Makara97/Bluetooth_Speaker_Setup/Bluetooth_Speaker_Driver/Project Outputs for Bluetooth_Speaker_Driver/BOM/Bill of Materials-Bluetooth_Speaker_Driver(Fabrication Variant).xlsx

Comment | Description | Designator | Footprint | LibRef | Quantity
ANT3216_2.45GHz | C293767, ANT3216LL00R2400A, -40℃~+105℃ 1.2mm 1.6mm 160MHz 1W 2.45GHz 3.2mm 5.05dBi 50Ω 1206 Antennas ROHS | ANT1 | ANT3216_2.4GHz | ANT3216_2.45GHz | 1
1uF | C307427, CL05B105KQ5NQNC, 1uF 6.3V X7R ±10% 0402 Multilayer Ceramic Capacitors MLCC - SMD/SMT ROHS | C1, C7, C12, C13, C19 | CAPC0402X06N | CC0402_1uF_X7R | 5
100nF | C1882920, CC0201KRX7R5BB104, 100nF 6.3V X7R ±10% 0201 Multilayer Ceramic Capacitors MLCC - SMD/SMT ROHS | C2, C3, C4, C5, C8, C9, C10, C11, C18 | CAPC0201X03N | CC0201_100nF_X7R | 9
2.2nF | C161488. GRM033R71E222KA12D, 2.2nF 25V X7R ±10% 0201 Multilayer Ceramic Capacitors MLCC - SMD/SMT ROHS | C6 | CAPC0201X03N | CC0201_2.2nF_X7R | 1
0.7pF | C907945, GJM0335C1ER70WB01D, 0.7pF 25V C0G 0201 Multilayer Ceramic Capacitors MLCC - SMD/SMT ROHS | C14 | CAPC0201X03N | CC0201_0.7pF_COG | 1
4.7uF | C354262, CC0805KKX7R8BB475, 25V 4.7uF X7R ±10% 0805 Multilayer Ceramic Capacitors MLCC - SMD/SMT ROHS | C16, C17, C34, C38 | CAP0805X13N | CC0805_4.7uF_X7R | 4
100pF | C14663 ,CC0603KRX7R9BB104, 100nF 50V X7R ±10% 0603 Multilayer Ceramic Capacitors MLCC - SMD/SMT ROHS | C20, C26, C27, C31 | CAPC0603X8N | CC0603_100pF_X7R | 4
10uF | C95841, CL21B106KOQNNNE, 10uF 16V X7R ±10% 0805 Multilayer Ceramic Capacitors MLCC - SMD/SMT ROHS | C21, C25, C28, C30, C45, C47, C48, C49, C53, C56, C62 | CAPC0805X14N | CC0805_10uF_X7R | 11
2.2nF | C107043, CC0603JRNPO9BN222, 2.2nF 50V NP0 ±5% 0603 Multilayer Ceramic Capacitors MLCC - SMD/SMT ROHS | C22, C29 | CAPC0603X8N | CC0603_2.2nF_NPO | 2
2.2uF | C19110 ,CL21B225KAFNNNE, 2.2uF 25V X7R ±10% 0805 Multilayer Ceramic Capacitors MLCC - SMD/SMT ROHS | C23, C24 | CAP0805X13N | CC0805_2.2uF_X7R | 2
22pF | C105620, CC0603JRNPO9BN220, 22pF 50V NP0 ±5% 0603 Multilayer Ceramic Capacitors MLCC - SMD/SMT ROHS | C32, C40 | CAPC0603X8N | CC0603_22pF_NPO | 2
22uF | C309062, CL32B226KAJNNNE, 22uF 25V X7R ±10% 1210 Multilayer Ceramic Capacitors MLCC - SMD/SMT ROHS | C33, C41, C51, C52 | CAPC1210X25N | CC1210_22uF_X7R | 4
4.7nF | C106218, CC0603KRX7R9BB472, 4.7nF 50V X7R ±10% 0603 Multilayer Ceramic Capacitors MLCC - SMD/SMT ROHS | C35 | CAPC0603X8N | CC0603_4.7nF_X7R | 1
10nF | C100042, CC0603KRX7R9BB103, 10nF 50V X7R ±10% 0603 Multilayer Ceramic Capacitors MLCC - SMD/SMT ROHS | C36, C42, C43, C44, C46 | CAPC0603X8N | CC0603_10nF_X7R | 5
220nF | C464977, GRM31C5C1H224JE02L, 220nF 50V C0G ±5% 1206 Multilayer Ceramic Capacitors MLCC - SMD/SMT ROHS | C37, C83, C84, C88, C90 | CAPC1206X18N | CC0603_220nF_NPO, CC1206_220nF_NPO | 5
100nF | C14663, CC0603KRX7R9BB104, 100nF 50V X7R ±10% 0603 Multilayer Ceramic Capacitors MLCC - SMD/SMT ROHS | C39, C50, C54, C57, C61, C63, C75, C81, C100, C105 | CAPC0603X8N | CC0603_100nF_X7R | 10
75pF | C282074, CC0603JRNPO9BN750, 50V 75pF NP0 ±5% 0603 Multilayer Ceramic Capacitors MLCC - SMD/SMT ROHS | C55 | CAPC0603X8N | CC0603_75pF_NPO | 1
1uF | C28323, CL21B105KBFNNNE, 1uF 50V X7R ±10% 0805 Multilayer Ceramic Capacitors MLCC - SMD/SMT ROHS | C58, C60, C64, C87, C89, C91, C94, C95, C98, C108, C111, C112, C113 | CAP0805X13N | CC0805_1uF_X7R | 13
470uF | C3350, RVT1V471M1010, -55℃~+105℃ 10.2mm 10mm 2000hrs@105℃ 35V 470uF ±20% SMD,D10xL10.2mm Aluminum Electrolytic Capacitors - SMD ROHS | C59 | CAPD10XL11.1X10.2M | CPD10XL10.2_470uF_ALUM | 1
100nF | C97946, GRM31C5C1H104JA01L, 100nF 50V C0G ±5% 1206 Multilayer Ceramic Capacitors MLCC - SMD/SMT ROHS | C65, C66 | CAPC1206X18N | CC1206_100nF_C0G | 2
10uF | C5246550, HV1V106M0605PZ, -55℃~+105℃ 10uF 2.2mm 2000hrs 35V 5.8mm 6.3mm ±20% SMD,D6.3xL5.8mm Polymer Aluminum Capacitors ROHS | C67, C70, C71, C72, C73 | CAPD6.3XL5.8X61M | CPD6.3XL5.8_10uF_POLYMER | 5
390nF | C1854267, CC0805KKX7R9BB394, 390nF 50V X7R ±10% 0805 Multilayer Ceramic Capacitors MLCC - SMD/SMT ROHS | C68, C69 | CAPC0805X14N | CC0805_390nF_X7R | 2
100uF | C5246554, HV1V107M0607PZ, -55℃~+105℃ 100uF 2.2mm 2000hrs 35V 6.3mm 7.7mm ±20% SMD,D6.3xL7.7mm Polymer Aluminum Capacitors ROHS | C74, C80, C99, C104 | CAPD6.3XL6.3X77M | CPD6.3XL7.7_100uF_POLY | 4
1nF | C100040, CC0603KRX7R9BB102, 1nF 50V X7R ±10% 0603 Multilayer Ceramic Capacitors MLCC - SMD/SMT ROHS, C106246, CC0603JRNPO9BN102, 1nF 50V NP0 ±5% 0603 Multilayer Ceramic Capacitors MLCC - SMD/SMT ROHS | C76, C77, C78, C82, C85, C86, C92, C93, C96, C97, C101, C106 | CAPC0603X8N | CC0603_1nF_X7R, CC0603_1nF_NPO | 12
220uF | C5246541, HV1E227M0607PZ, -55℃~+105℃ 2.2mm 2000hrs 220uF 25V 6.3mm 7.7mm ±20% SMD,D6.3xL7.7mm Polymer Aluminum Capacitors ROHS | C79, C102 | CAPD6.3XL6.3X77M | CPD6.3XL7.7_220uF_POLY | 2
680nF | C145012, CC1206KKX7R9BB684, 50V 680nF X7R ±10% 1206 Multilayer Ceramic Capacitors MLCC - SMD/SMT ROHS | C103, C110 | CAPC1206X18N | CC1206_680nF_X7R | 2
470nF | C277483, CC1206KKX7R9BB474, 470nF 50V X7R ±10% 1206 Multilayer Ceramic Capacitors MLCC - SMD/SMT ROHS | C107, C109 | CAPC1206X18N | CC1206_470nF_X7R | 2
FB_3A | C107332, MPZ1608S101ATAH0, -55℃~+125℃ 1 100Ω@100MHz 30mΩ 3A ±25% 0603 Ferrite Beads ROHS | FB1, FB2, FB4, FB5, FB6 | FB0603X08N | FB0603_3A | 5
FB_6A | C136227, MPZ2012S300AT000, -55℃~+125℃ 1 10mΩ 30Ω@100MHz 6A ±25% 0805 Ferrite Beads ROHS | FB3, FB7 | FB0805X12N | FB0805_6A | 2
4.7uH | C91237, MLP2520S4R7MT0S1, 130mΩ 1A 4.7uH Multilayer inductor ±20% 1008 Inductors (SMD) ROHS | IN1, IN2 | INDC2520X10N | IN2520_4.7uH_1A | 2
15uH | C5189959, CYA0630-15UH, 15uH 3.8A 3A 98mΩ ±20% SMD,7.2x6.6mm Inductors (SMD) ROHS | IN3 | INDM7266X30N | IN7266_15uH_3A | 1
SWD_CONN_2X5P_1.27MM | C42372547, HX JN1.27-2x5P ZZ H4.9, -40℃~+105℃ 1.27mm 1.27mm 1A 2 2x5P 5 500V Black Copper Gold IDC Header Through Hole Plugin,P=1.27mm IDC Connectors ROHS | J1 | CONN_2X5P_1.27MM - duplicate | SWD_CONN_2X5P_1.27MM | 1
JST_GH_4_PIN | C161692, BM04B-GHS-TBT(LF)(SN), -25℃~+85℃ 1 1.25mm 1A 1x4P 4 4.05mm 4.32mm 4P 50V 8.25mm Auxiliary Solder Pin GH PA9T Phosphor bronze Surface Mount,Vertical Tin UL94V-0 White SMD,P=1.25mm Wire To Board Connector ROHS | J2 | JST_GH_4_PIN | JST_GH_4_PIN | 1
JST_GH_8_PIN | C133062, BM08B-GHS-TBT(LF)(SN), -25℃~+85℃ 1 1.25mm 13.25mm 1A 1x8P 4.05mm 4.32mm 50V 8 8P Auxiliary Solder Pin GH PA9T Phosphor bronze Surface Mount,Vertical Tin UL94V-0 White SMD,P=1.25mm Wire To Board Connector ROHS | J3 | JST_GH_8_PIN | JST_GH_8_PIN | 1
USB_TYPE_A_FE | C456018, AF 90 WJDG, -25℃~+85℃ 1 1.5A 14mm 30V 4P 5,000 times Female Right Angle Type-A USB 2.0 White 弯插 USB Connectors ROHS | J4 | USB_TYPE_A_FE | USB_TYPE_A_FE | 1
JST_S2P_VH | C160355, S2P-VH(LF)(SN), -25℃~+85℃ 1 10A 13.9mm 1x2P 2 250V 2P 3.96mm 7.86mm Brass PA66 Right Angle Tin UL94V-0 VH White 弯插,P=3.96mm Wire To Board Connector ROHS | J5 | JST_S2P_VH | JST_S2P_VH | 1
JST_B2B-XH-A-GU | C265283, B2B-XH-A-GU, -25℃~+85℃ 1 1x2P 2 2.5mm 250V 2P 3A 5.75mm 7.4mm 7mm Brass Gold K Pin PA66 Through Hole UL94V-0 White XH 插件,P=2.5mm Wire To Board Connector ROHS | J6, J7, J8 | JST_B2B_XH_A_GU | JST_B2B-XH-A-GU | 3
10uH | C76798, MLZ1608M100WT000, 1.05Ω 10uH 250mA 2MHz 90mA Multilayer inductor ±20% 0603 Inductors (SMD) ROHS | L1, L2 | INDC0603X08N | IN0603_10uH | 2
2.2nH | C98041, LQP03TN2N2B02D, 11GHz 14@500MHz 150mΩ 2.2nH 600mA Thick Film Inductor 0201 Inductors (SMD) ROHS | L3, L4 | INDC0201 | IN0201_2.2nH | 2
1.5nH | C77114, LQP03TN1N5B02D, 1.5nH 14@500MHz 150mΩ 15GHz 600mA Thick Film Inductor 0201 Inductors (SMD) ROHS | L5 | INDC0201 | IN0201_1.5nH | 1
1.8nH | C98040, LQP03TN1N8B02D, 1.8nH 14@500MHz 150mΩ 15GHz 600mA Thick Film Inductor 0201 Inductors (SMD) ROHS | L7 | INDC0201 | IN0201_1.8nH | 1
10uH | C168076, FNR6045S100MT, 10uH 2.7A 3.5A 62mΩ Magnetic Shielded Inductor ±20% SMD,6x6mm Power Inductors ROHS | L8, L9 | INDC6060X45N | IN0606_10uH_2.7A | 2
LED_YELLOW | C965814, XL-2012UYC, 120° 2.3V 20mA 50mW 585nm~595nm 590nm Discrete Diode Top-mount Water Clear Yellow 0805 LED Indication - Discrete ROHS | LED1A, LED1B, LED1C, LED1D | LED_0805_127P120X200-2N | LED0805_YELLOW | 4
AO3400A | C347475, AO3400A, -55℃~+150℃ 1 N-channel 1.1V 1.4W 17mΩ@10V 30V 5.8A 77pF 823pF 9.7nC@4.5V 99pF SOT-23 MOSFETs ROHS | Q1A, Q1B, Q1C, Q1D | SOT23_P240X110-3N | SOT_23_AO3400A | 4
2.2 ohm | C474415, RC0201JR-072R2L, -100ppm/℃~+350ppm/℃ -55℃~+125℃ 2.2Ω 25V 50mW Thick Film Resistor ±5% 0201 Chip Resistor - Surface Mount ROHS | R1 | CAPC0201X03N | REC0201_2.2_THICK | 1
50 ohm | C849792, RT0603BRE0750RL, -55℃~+155℃ 100mW 50Ω 75V Thin Film Resistor ±0.1% ±50ppm/℃ 0603 Chip Resistor - Surface Mount ROHS | R2A, R2B, R2C, R2D | RECS0603X45N | RESC0603_50_THIN | 4
100 ohm | C122970, RT0603BRD07100RL, -55℃~+155℃ 100mW 100Ω 75V Thin Film Resistor ±0.1% ±25ppm/℃ 0603 Chip Resistor - Surface Mount ROHS | R3A, R3B, R3C, R3D, R10 | RECS0603X45N | RESC0603_100_THIN | 5
100k | C116674, AC0603FR-07100KL, -55℃~+155℃ 100kΩ 100mW 75V Thick Film Resistor ±1% ±100ppm/℃ 0603 Chip Resistor - Surface Mount ROHS | R4A, R4B, R4C, R4D, R9, R12, R13, R17, R25, R28, R29, R30, R31, R39, R41, R44, R46, R48 | RECS0603X45N | RESC0603_100K_THIN | 18
470 ohm | C705857,RT0603BRE07470RL, -55℃~+155℃ 100mW 470Ω 75V Thin Film Resistor ±0.1% ±50ppm/℃ 0603 Chip Resistor - Surface Mount ROHS | R5, R6 | RECS0603X45N | RESC0603_470_THIN | 2
510K | C114066, RC0603FR-07510KL, -55℃~+155℃ 100mW 510kΩ 75V Thick Film Resistor ±1% ±100ppm/℃ 0603 Chip Resistor - Surface Mount ROHS | R7, R11 | RECS0603X45N | RESC0603_510K_THICK | 2
130K | C163432, RC0603FR-07130KL, -55℃~+155℃ 100mW 130kΩ 75V Thick Film Resistor ±1% ±100ppm/℃ 0603 Chip Resistor - Surface Mount ROHS | R8 | RECS0603X45N | RESC0603_130K_THICK | 1
320k | C20165692, RT0603BRD07320KL, -55℃~+155℃ 100mW 320kΩ 75V Thin Film Resistor ±0.1% ±25ppm/℃ 0603 Chip Resistor - Surface Mount ROHS | R14 | RECS0603X45N | RESC0603_320K_THIN | 1
324k | C861321, RT0603BRD07324KL, -55℃~+155℃ 100mW 324kΩ 75V Thin Film Resistor ±0.1% ±25ppm/℃ 0603 Chip Resistor - Surface Mount ROHS | R15 | RECS0603X45N | RESC0603_324K_THIN | 1
49.9 ohm | C23185, 0603WAF499JT5E, -55℃~+155℃ 100mW 49.9Ω 75V Thick Film Resistor ±1% ±100ppm/℃ 0603 Chip Resistor - Surface Mount ROHS | R16 | RECS0603X45N | RESC0603_49.9_THIN | 1
13.3k | C185373, RC0603FR-0713K3L, -55℃~+155℃ 100mW 13.3kΩ 75V Thick Film Resistor ±1% ±100ppm/℃ 0603 Chip Resistor - Surface Mount ROHS | R18 | RECS0603X45N | REC0603_13.3K_THICK | 1
11k | C728581, RT0603BRD0711KL, -55℃~+155℃ 100mW 11kΩ 75V Thin Film Resistor ±0.1% ±25ppm/℃ 0603 Chip Resistor - Surface Mount ROHS | R19, R20, R21, R24, R26, R27 | RECS0603X45N | RESC0603_11K_THIN | 6
5.6k | C179095, RT0603BRD075K6L, -55℃~+155℃ 100mW 5.6kΩ 75V Thin Film Resistor ±0.1% ±25ppm/℃ 0603 Chip Resistor - Surface Mount ROHS | R22, R23 | RECS0603X45N | RESC0603_5.6K_THIN | 2
4.7k | C513565, RT0603BRD074K7L, -55℃~+155℃ 100mW 4.7kΩ 75V Thin Film Resistor ±0.1% ±25ppm/℃ 0603 Chip Resistor - Surface Mount ROHS | R32, R35 | RECS0603X45N | RESC0603_4.7K_THIN | 2
10k | C95204, RT0603BRD0710KL, -55℃~+155℃ 100mW 10kΩ 75V Thin Film Resistor ±0.1% ±25ppm/℃ 0603 Chip Resistor - Surface Mount ROHS | R33, R34 | RECS0603X45N | RESC0603_10K_THIN | 2
68 ohm | C861523, RT0603BRD0768RL, -55℃~+155℃ 100mW 68Ω 75V Thin Film Resistor ±0.1% ±25ppm/℃ 0603 Chip Resistor - Surface Mount ROHS | R36, R37, R38, R43 | RECS0603X45N | RESC0603_68_THIN | 4
51K | C107231, RC0603FR-0751KL, -55℃~+155℃ 100mW 51kΩ 75V Thick Film Resistor ±1% ±100ppm/℃ 0603 Chip Resistor - Surface Mount ROHS | R40, R45 | RECS0603X45N | RESC0603_51K_THICK | 2
39K | C163424, RC0603FR-0739KL, -55℃~+155℃ 100mW 39kΩ 75V Thick Film Resistor ±1% ±100ppm/℃ 0603 Chip Resistor - Surface Mount ROHS | R42, R47 | RECS0603X45N | RESC0603_39K_THICK | 2
SCHDIOSMB_1A | C86598, STPS160U, 1 Independent 1A 4uA@60V 60V 670mV@1A 75A SMB Schottky Diodes ROHS | SD1, SD2 | SD_SMB_1A | SCHDIOSMB_1A | 2
PB_SW | C49393629, R4A25211L, 1.8N 12V 50mA Gull Wing Rectangular Button SPST-NO Surface Mount,Vertical White SMD Pushbutton Switches ROHS | SW1, SW2, SW3, SW4, SW5, SW6, SW7, SW8 | SW_PB_2 | SW_SMD_PUSH | 8
nRF5340-QKAA | Multi-protocol Bluetooth Low Energy, IEEE 802.15.4, ANT and 2.4GHz proprietary system-on-chip | U1 | AQFN40P700X700X85_HS-99N | nRF5340-QKAA | 1
PCM5102APWR | C107671, PCM5102APWR, -25℃~+85℃ 1.8V~3.3V 2 32 384kHz 500uA 50MHz Audio Decoder I2S TSSOP-20 ADCs/DACs - Special Purpose ROHS | U2 | SOP65P640X120-20N | PCM5102APWR | 1
TPS65131RGER | C87663, TPS65131RGER, -15V~-2V、500mV~15V -40℃~+85℃@(TA)、-40℃~+125℃@(TJ) 1.25MHz~1.5MHz 1.95A 2 2.7V~5.5V 500uA Adjustable Boost、Inverting Buck-Boost Built-in No QFN-24-EP(4x4) DC-DC Converters ROHS | U3 | QFN50P400X400X100-25N-D | TPS65131RGER | 1
TPS7A4901DGNR | C16430, TPS7A4901DGNR, -40℃~+125℃@(Tj) 1 1.194V~33V 15.4uVrms 150mA 260mV@(100mA) 35V 49uA 72dB@(120Hz) Adjustable Positive Under Voltage Lockout、Over Current Protection、Over Temperature Protection、Enable HVSSOP-8 Voltage Regulators - Linear, Low Drop Out (LDO) Regulators ROHS | U4 | SOP65P490X110-9N | TPS7A4901DGNR | 1
TPS7A3001DGNR | C33835, TPS7A3001DGNR, -40℃~+125℃@(Tj) 1 1.18V~33V 15.1uVrms 200mA 216mV@(100mA) 36V 55uA 72dB@(120Hz) Adjustable Negative Over Current Protection、Enable、Thermal Shutdown HVSSOP-8 Voltage Regulators - Linear, Low Drop Out (LDO) Regulators ROHS | U5 | SOP65P490X110-9N | TPS7A3001DGNR | 1
TPS54202DDCR | C191884, TPS54202DDCR, -40℃~+125℃@(TJ) 1 2A 4.5V~28V 45uA 500kHz Adjustable Buck Buck Built-in Yes SOT-23-6 DC-DC Converters ROHS | U6 | TPS54202DDCR | TPS54202DDCR | 1
TLV75533PDBVR | C404027, TLV75533PDBVR, -40℃~+125℃@(Tj) 1 238mV@(500mA) 25uA 3.3V 46dB@(100kHz) 5.5V 500mA 71.5uVrms Fixed Over Current Protection、Thermal Shutdown、Input undervoltage protection Positive SOT-23-5 Voltage Regulators - Linear, Low Drop Out (LDO) Regulators ROHS | U7 | SOT95P280X145-5N | TLV75533PDBVR | 1
TPS7A2033PDBVR | C2862740, TPS7A2033PDBVR, -40℃~+125℃@(Tj) 1 10uVrms 140mV@(300mA) 3.3V 300mA 65dB@(100kHz) 6V 8.5uA Fixed Over Current Protection、Enable Positive SOT-23-5 Voltage Regulators - Linear, Low Drop Out (LDO) Regulators ROHS | U8 | SOT95P280X145-5N | TPS7A2033PDBVR | 1
RC4580IDR | C80100, RC4580IDR, -16V~-2V、2V~16V -40℃~+85℃ 0.0005% 110dB 2-Channel 9mA SOIC-8 Audio Amplifiers ROHS | U9, U10 | SOIC127P600X175-8N | RC4580IDR | 2
TPA3138D2PWPR | C475506, TPA3138D2PWPR, -10℃~+85℃ -70dB 0.04% 102dB 10W×2@6Ω、18.5W×1@4Ω 2-Channel 20mA 3.5V~14.4V Automatic mute/no-noise switch、Overvoltage protection、Digital programmable gain Class D TSSOP-28-EP Audio Amplifiers ROHS | U11, U12 | SOP65P640X120-29N | TPA3138D2PWPR | 2
32MHz | C20617581, XL2MI-111-32M, -40℃~+85℃ 10pF 32MHz 40Ω Crystal Oscillator ±10ppm ±20ppm SMD3225-4P Crystals ROHS | X1 | CRYOSC_3.2X2.5M | SMD3225_4P_32MHz_OSC | 1
Total components |  |  |  |  | 227
