Makara97/Bluetooth_Speaker_Setup/Bluetooth_Speaker_Driver/Project Outputs for Bluetooth_Speaker_Driver/ExportSTEP/PCB(Fabrication Variant).step

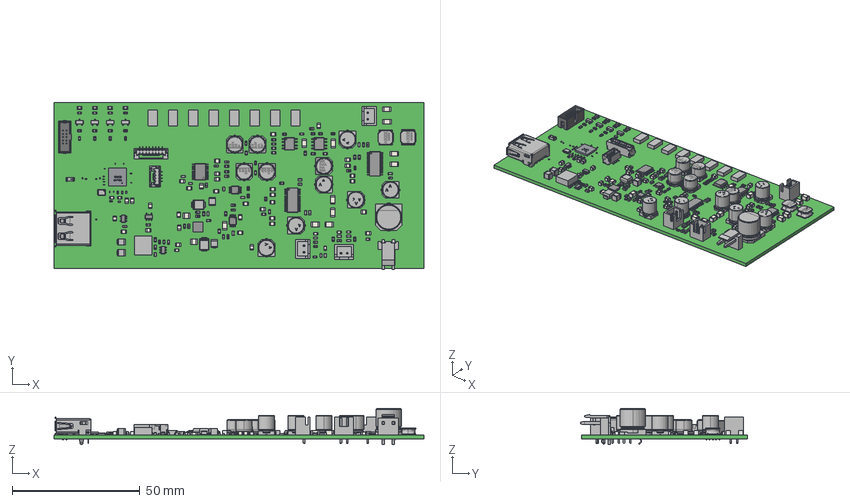
[picture p1: CAD file, 2026-09-16]
Bluetooth_Speaker_Driver/Project Outputs for Bluetooth_Speaker_Driver/ExportSTEP/PCB(Fabrication Variant).step
145.0 x 65.3 x 14.1 mm
Imported x 2
Inlay
MetalFrame
Pin1Marker
Pin3
Pin1
Lid
Pin4
Pin2
Ceramic
PinsArrayLR x 5
ThermalPad x 2
BODY-SOT x 2
LEAD-SOT x 10
LEAD-DUMMY x 2
BODY-HVSSOP x 2
LEAD-HVSSOP x 16
PIN1_HVSSOP x 2
DAP_HVSSOP x 2
BODY-QFN
PIN1-ID
BODY-TSSOP
LEAD-TSSOP x 20
PIN1
aQFN-94 x 9
Extruded x 234
STPS160U_RGB8421504 x 2
RT0603BRD074K7L 4.7k_RGB8421504 x 56
SOT-23_RGB8421504 x 4
LED-0805-1_RGB8421504 x 4
10uH, 6x6 mm_RGB8421504 x 2
JST-B2B-XH-A_RGB8421504 x 3
VH-2AW-Body.STEP
VH-2AW-Pin.STEP x 2
USB-A1HSW6 shell
test
BMxxB-GHS-TBT_08
JST-GH-4PIN-BM04B-GHS-TBT(LF)(SN)(N)_RGB8421504
Linear Pattern 01
Pins:1
CC0603JRNPO9BN222 - 2.2nF, C0G,_RGB8421504 x 37
C5246554 - 100uF, D6.3x7.7mm_RGB8421504 x 6
C5246550 - 10uF,D6.3xL5.8mm_RGB8421504 x 5
C3350 - 470uF, D10xL10.2mm_RGB8421504
CC1210 - 22uF, X7R_RGB8421504 x 4
