Makara97/Bluetooth_Speaker_Setup/Bluetooth_Speaker_Driver/Project Outputs for Bluetooth_Speaker_Driver/Schematic.PDF

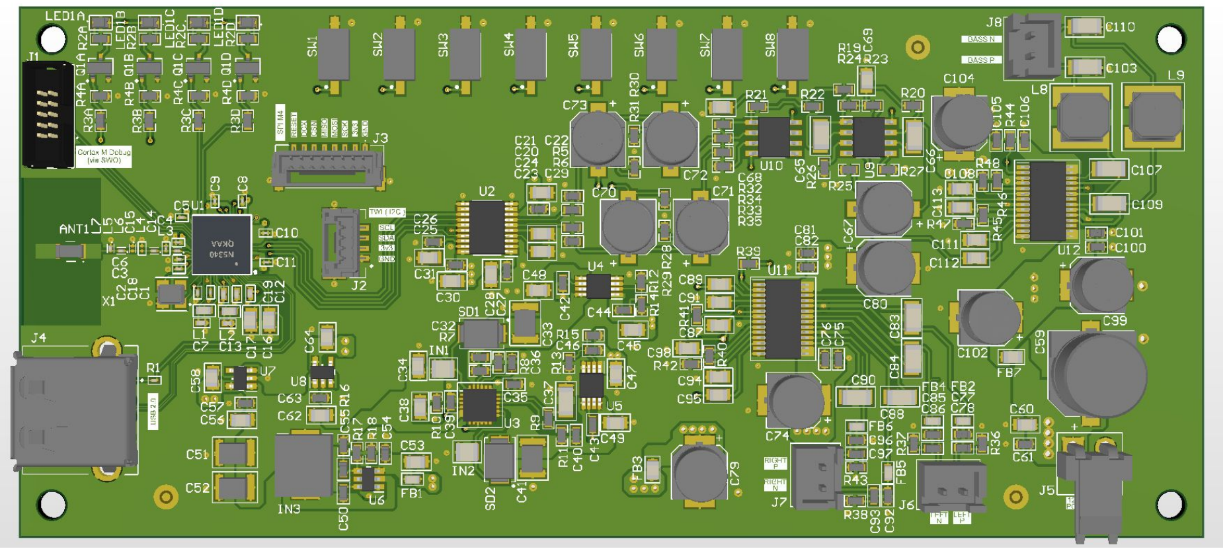
[picture p2: page 1]

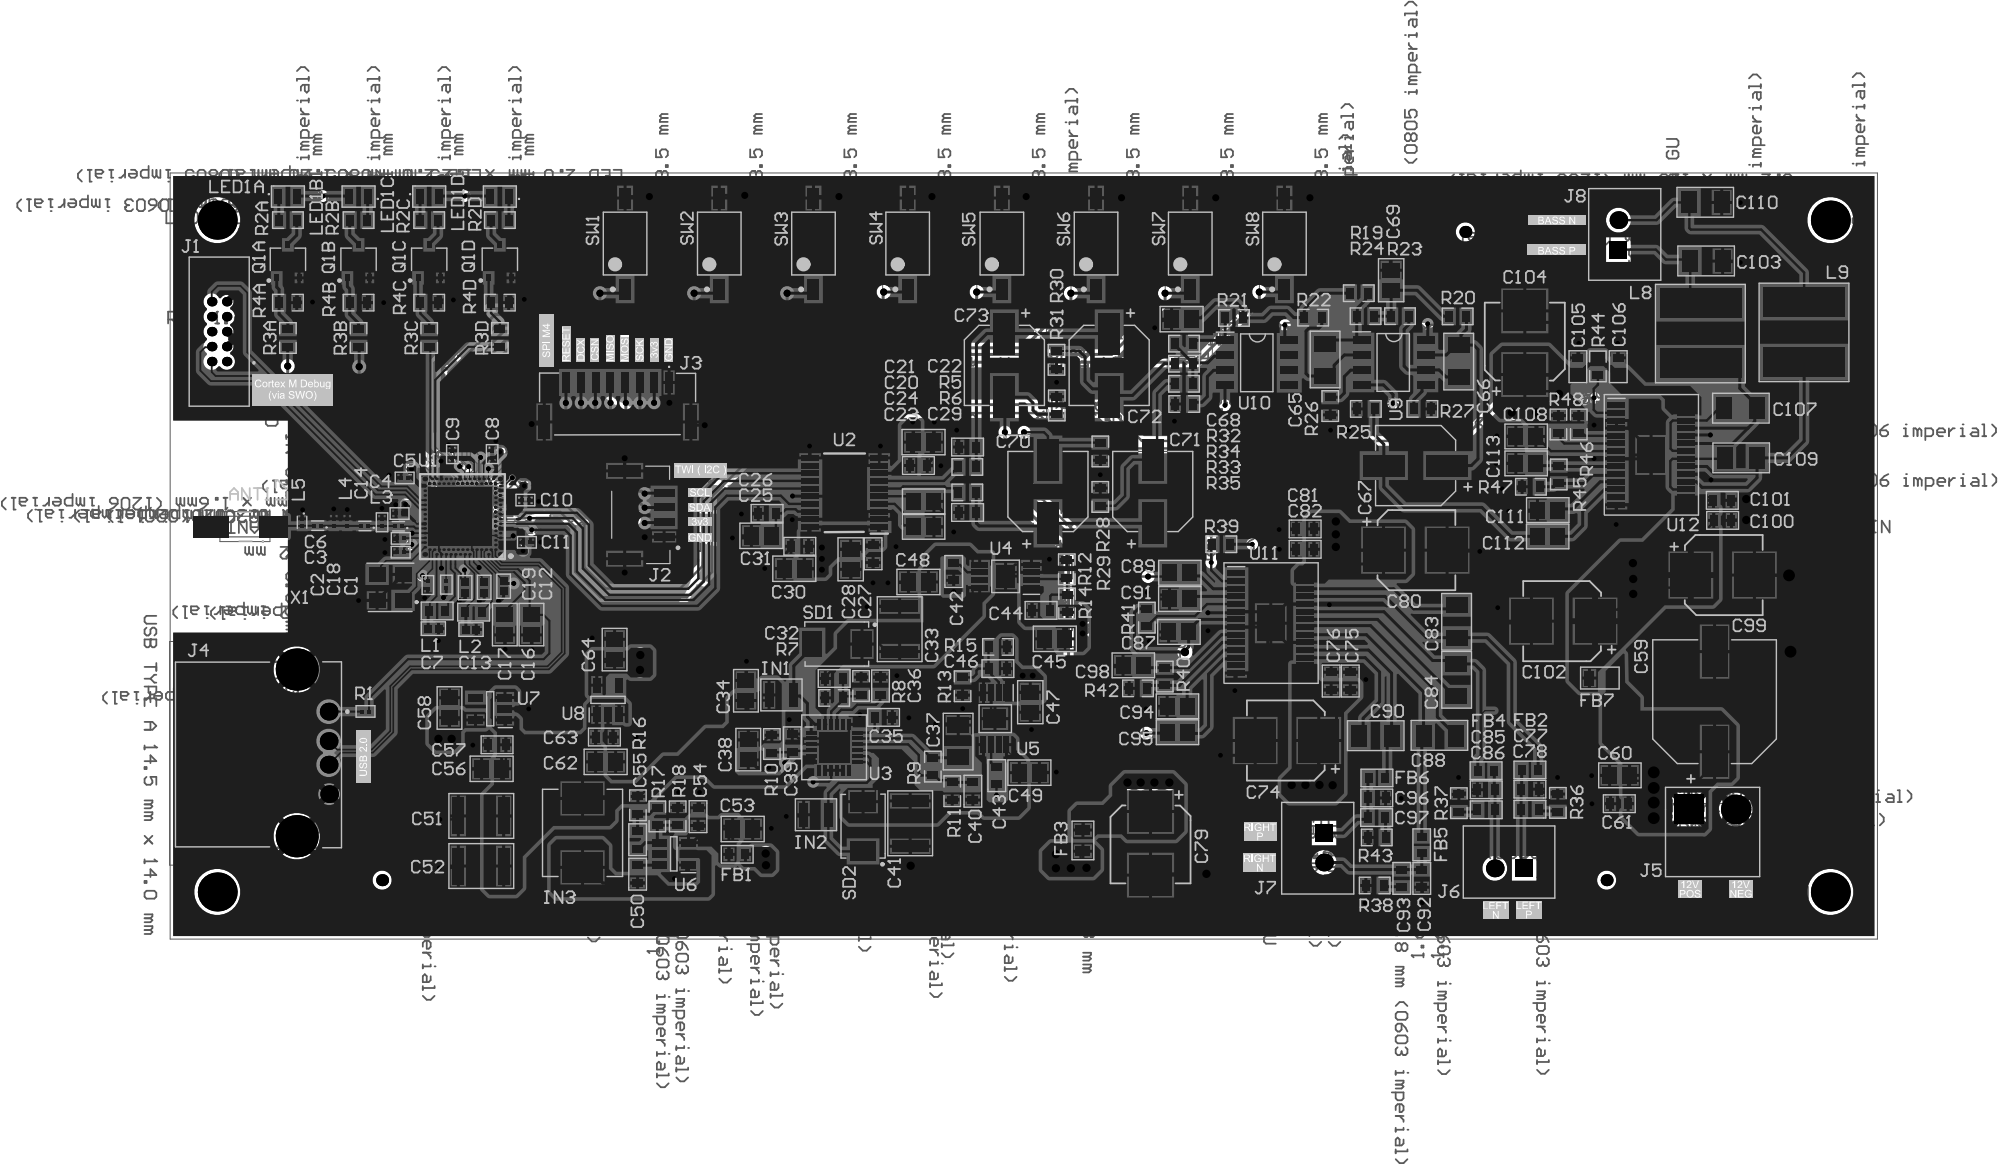
[picture p3: page 2]

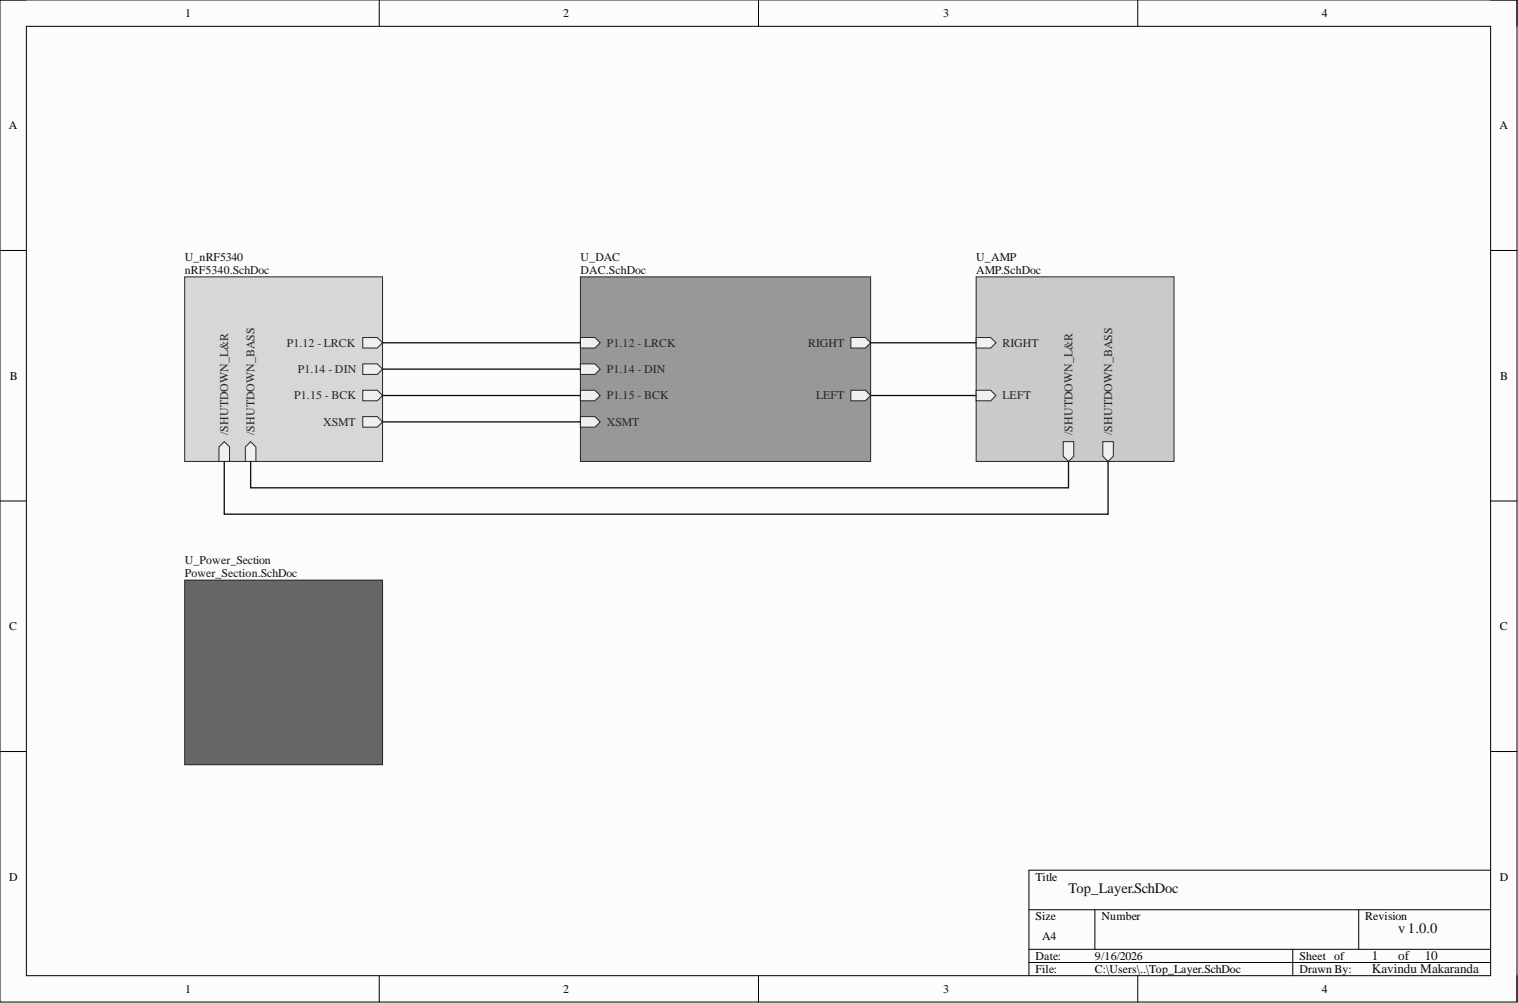
[picture p4: page 4]

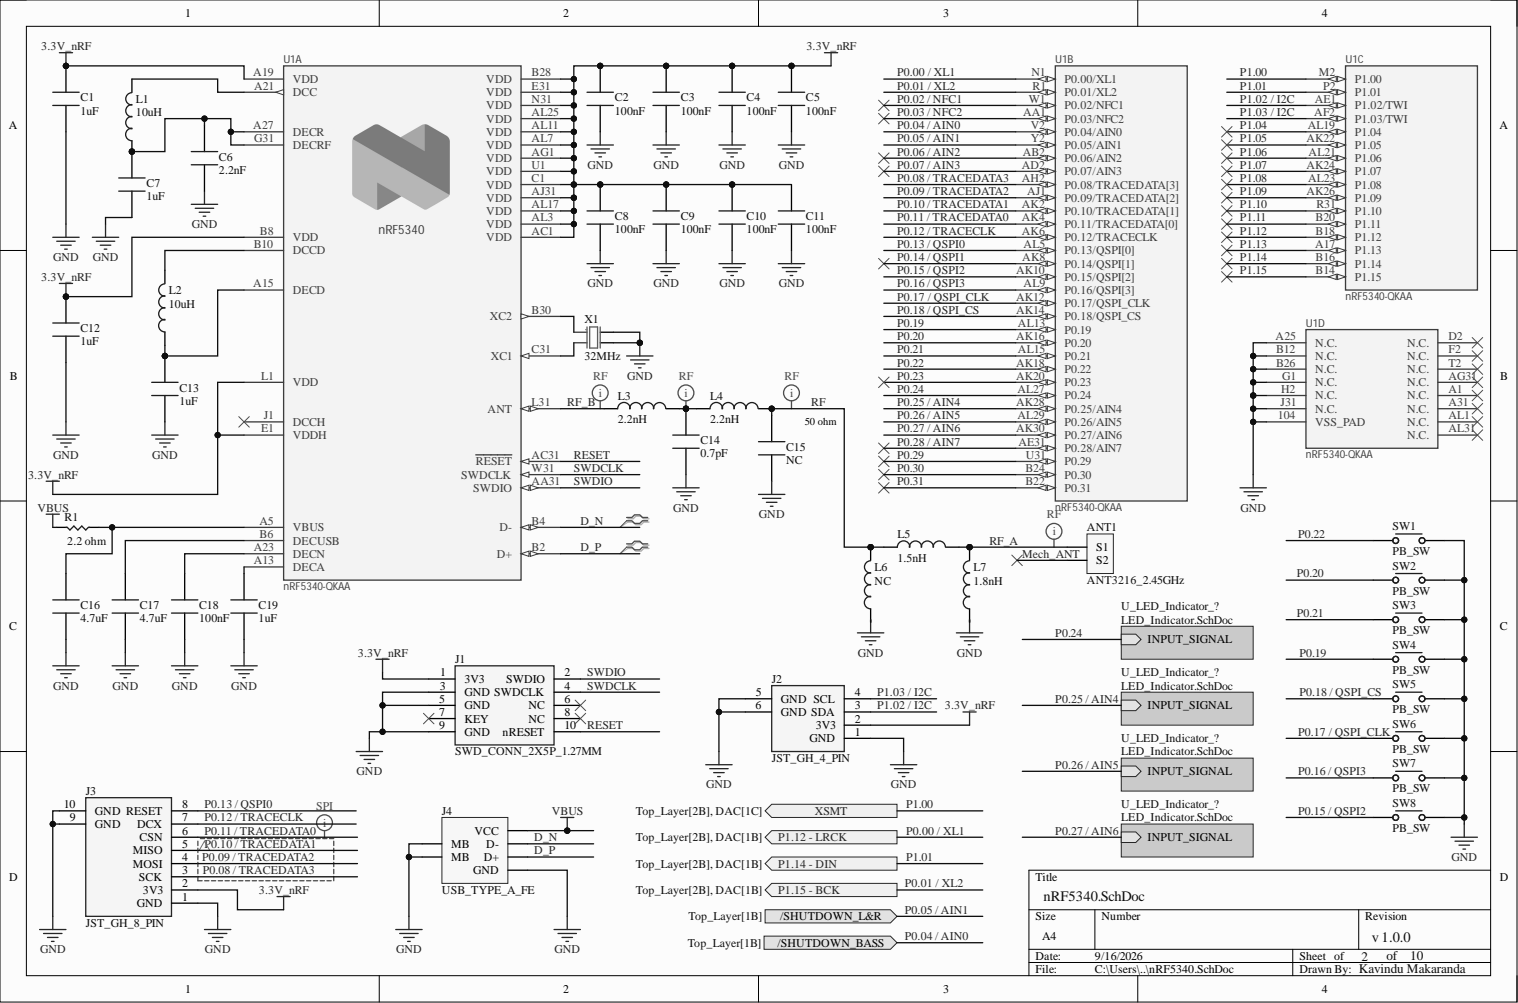
[picture p5: page 5]

A J 3 1 | G N RF | i
A L 1 7
A L 3

A 2 3
A 1 3

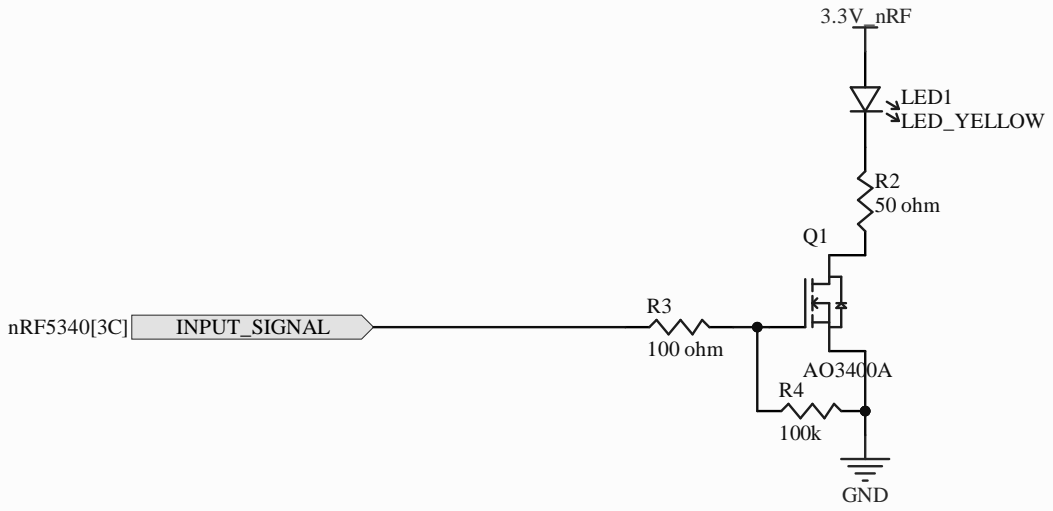
[picture p6: page 6]

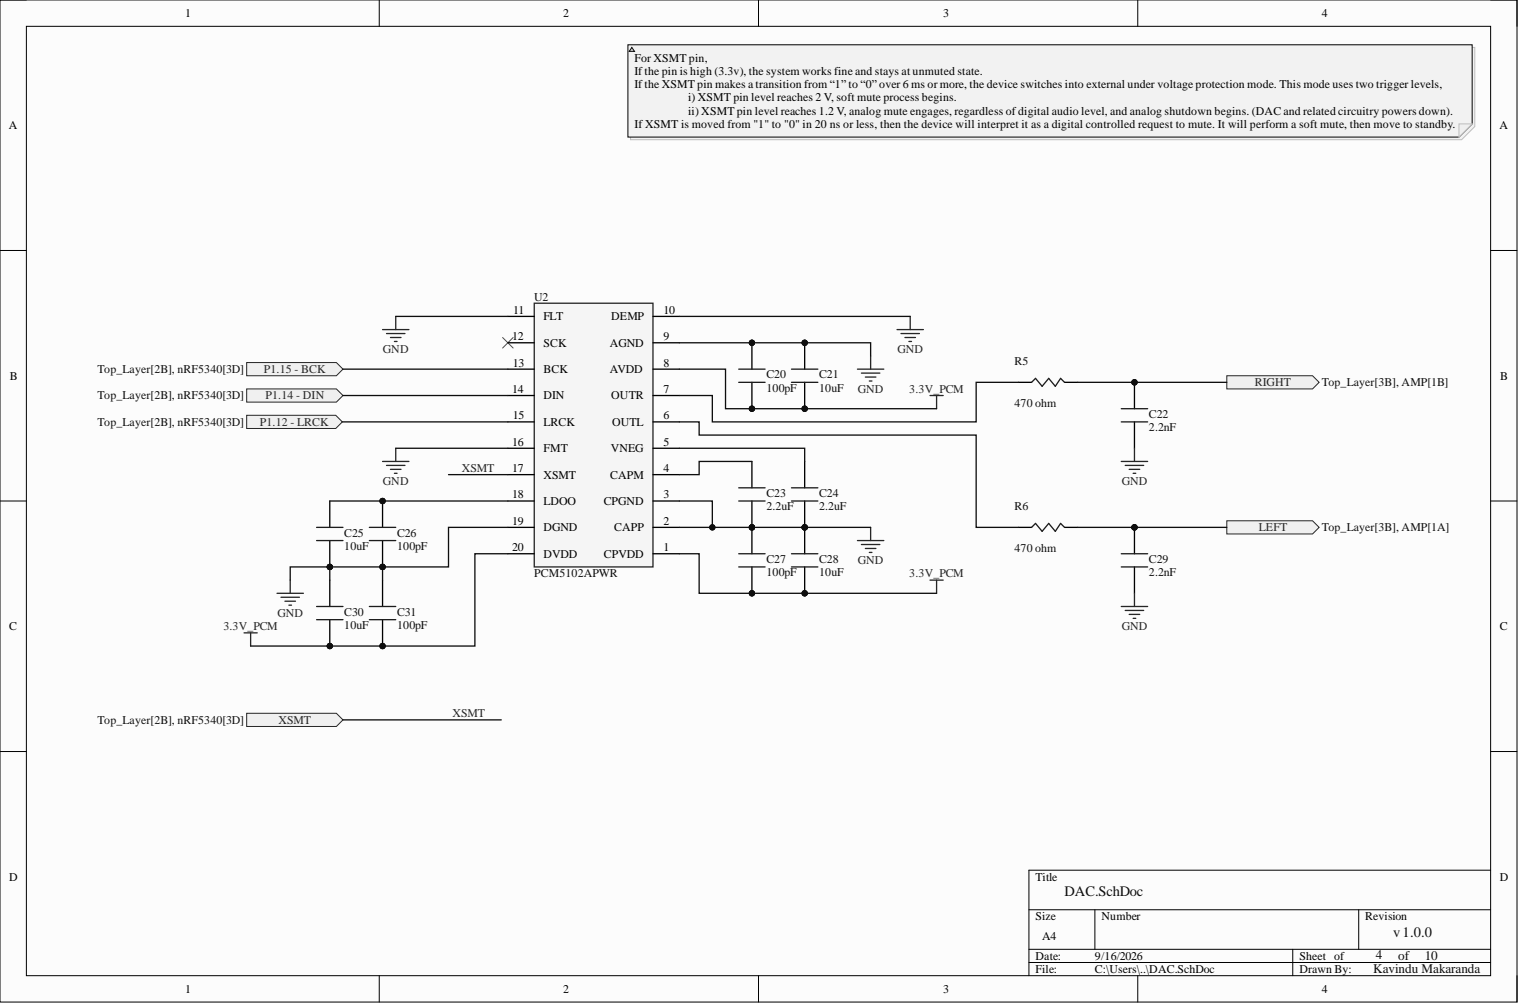
[picture p7: page 7]

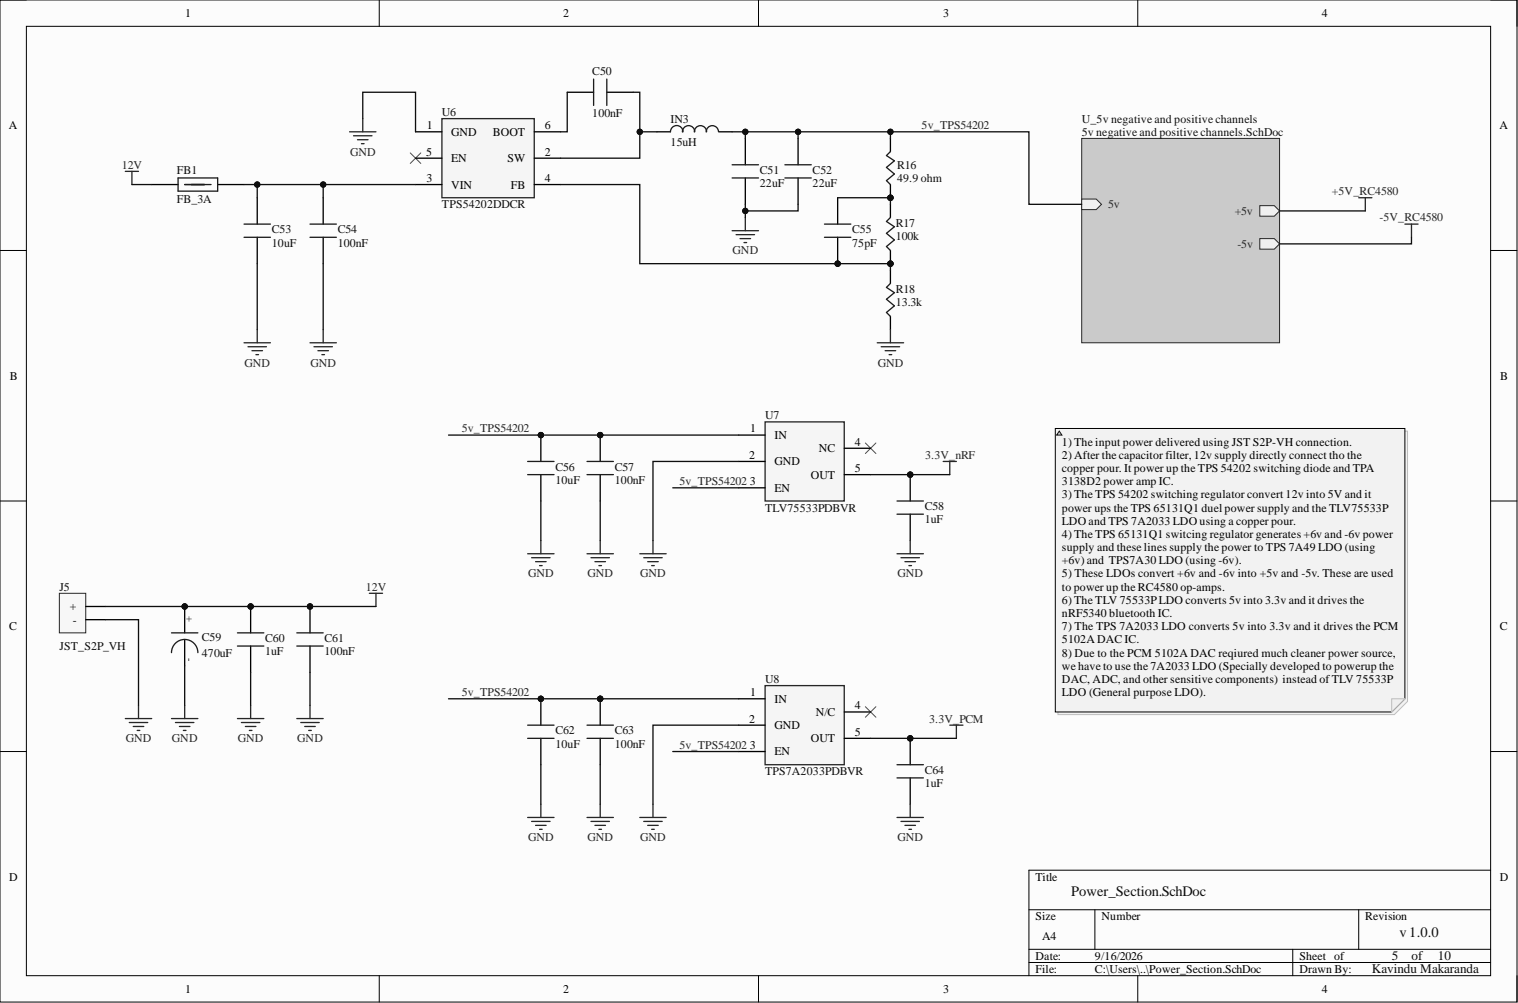
[picture p8: page 8]

U_5v negative and positive channels
5v negative and positive channels.SchDoc

1) The input power delivered using JST S2P-VH connection.
2) After the capacitor filter, 12v supply directly connect tho the
copper pour. It power up the TPS 54202 switching diode and TPA
3138D2 power amp IC.
3) The TPS 54202 switching regulator convert 12v into 5V and it
power ups the TPS 65131Q1 duel power supply and the TLV75533P
LDO and TPS 7A2033 LDO using a copper pour.
4) The TPS 65131Q1 switcing regulator generates +6v and -6v power
supply and these lines supply the power to TPS 7A49 LDO (using
+6v) and TPS7A30 LDO (using -6v).
5) These LDOs convert +6v and -6v into +5v and -5v. These are used
to power up the RC4580 op-amps.
6) The TLV 75533PLDO converts 5v into 3.3v and it drives the
nRF5340 bluetooth IC.
7) The TPS 7A2033 LDO converts 5v into 3.3v and it drives the PCM
5102A DAC IC.
8) Due to the PCM 5102A DAC reqiured much cleaner power source,
we have to use the 7A2033 LDO (Specially developed to powerup the
DAC, ADC, and other sensitive components) instead of TLV 75533P
LDO (General purpose LDO).

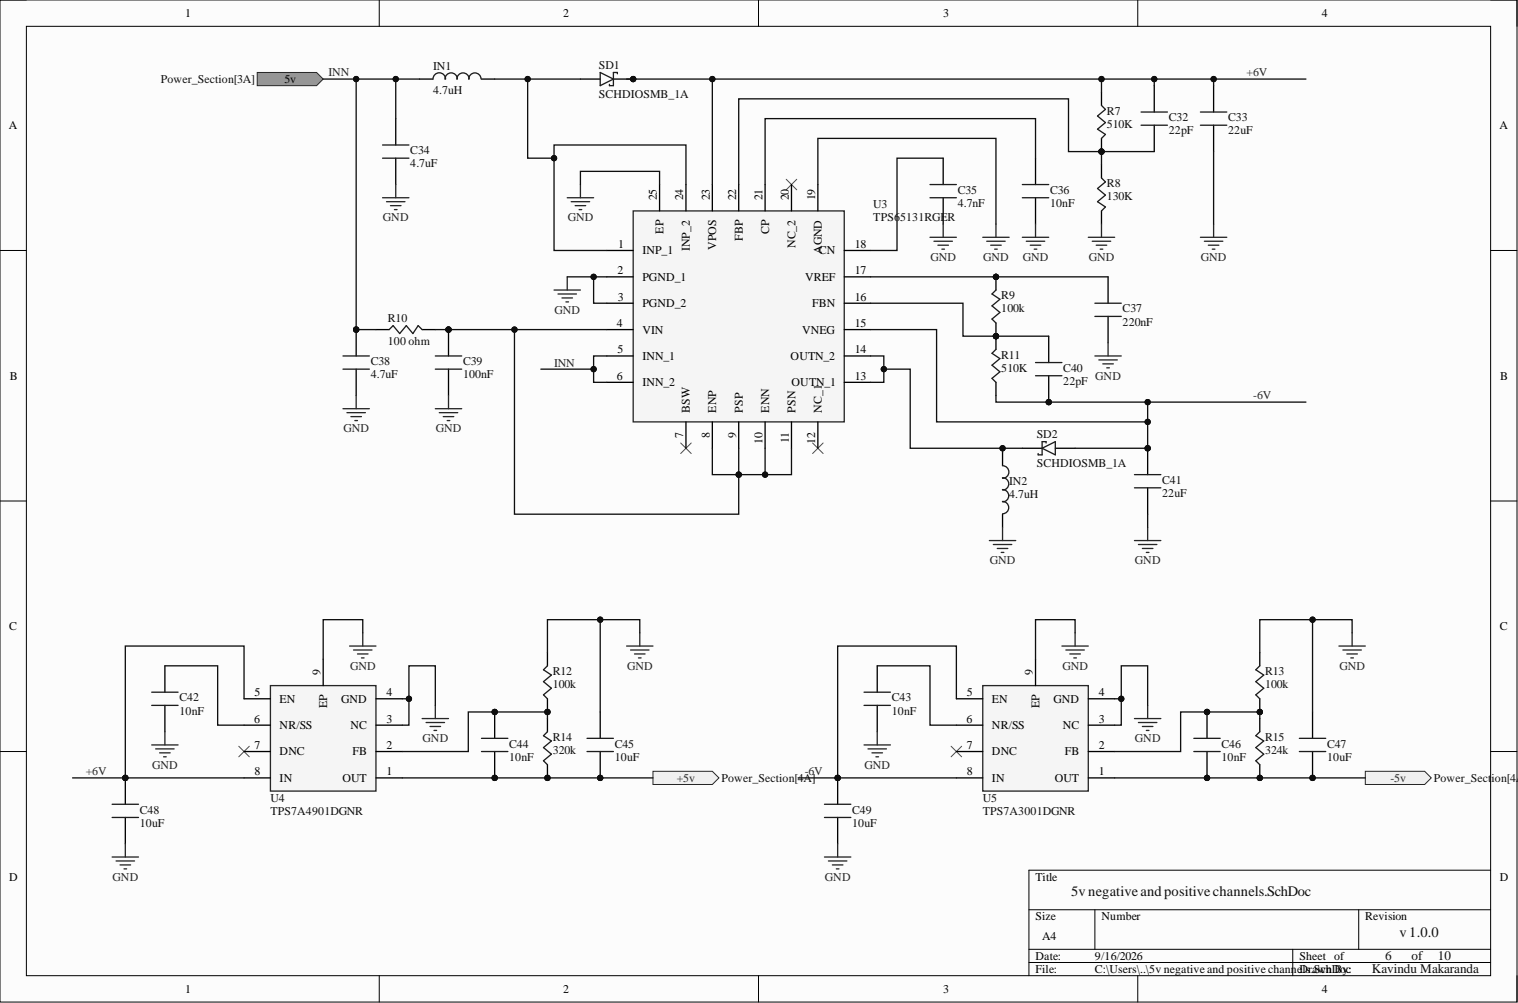
[picture p9: page 9]

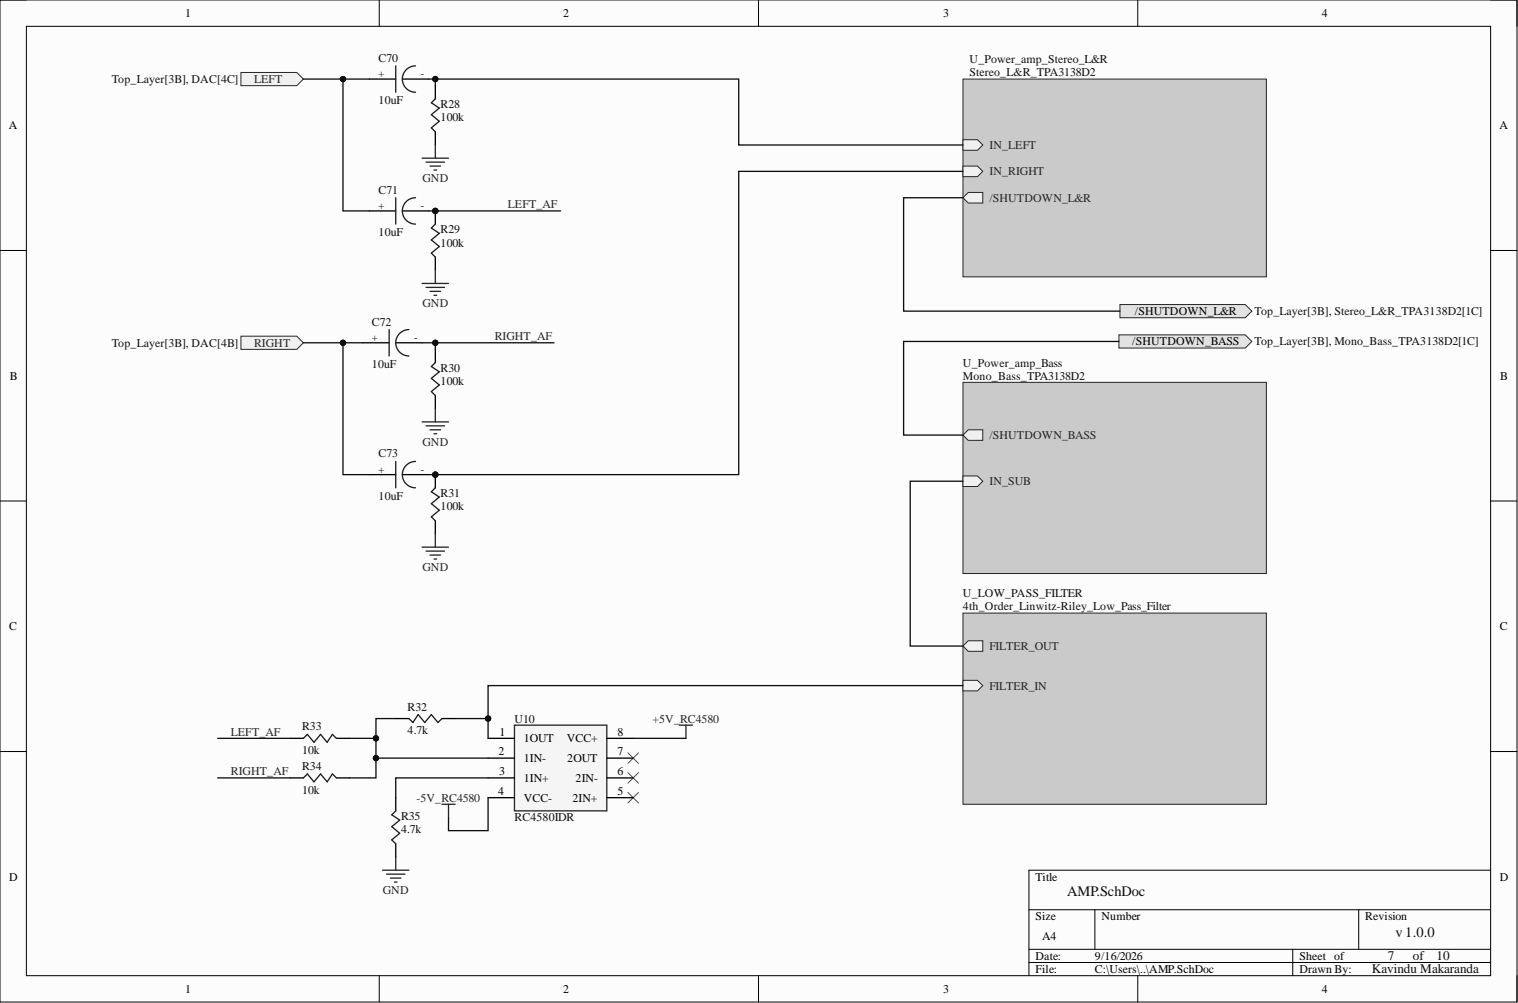
[picture p10: page 10]

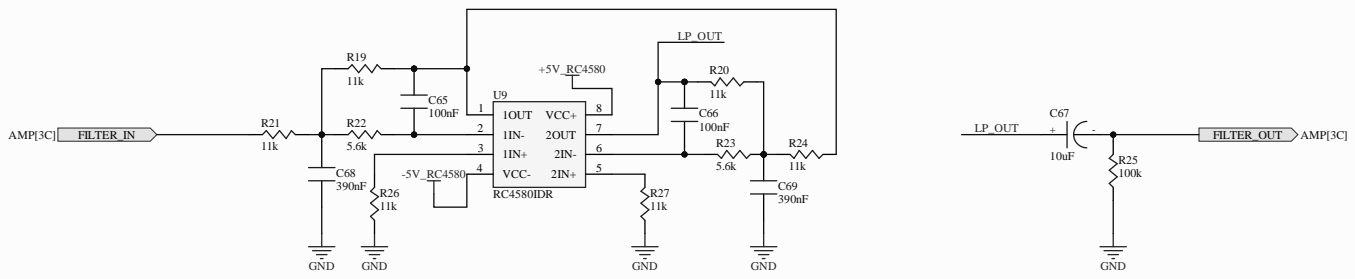
[picture p11: page 11]

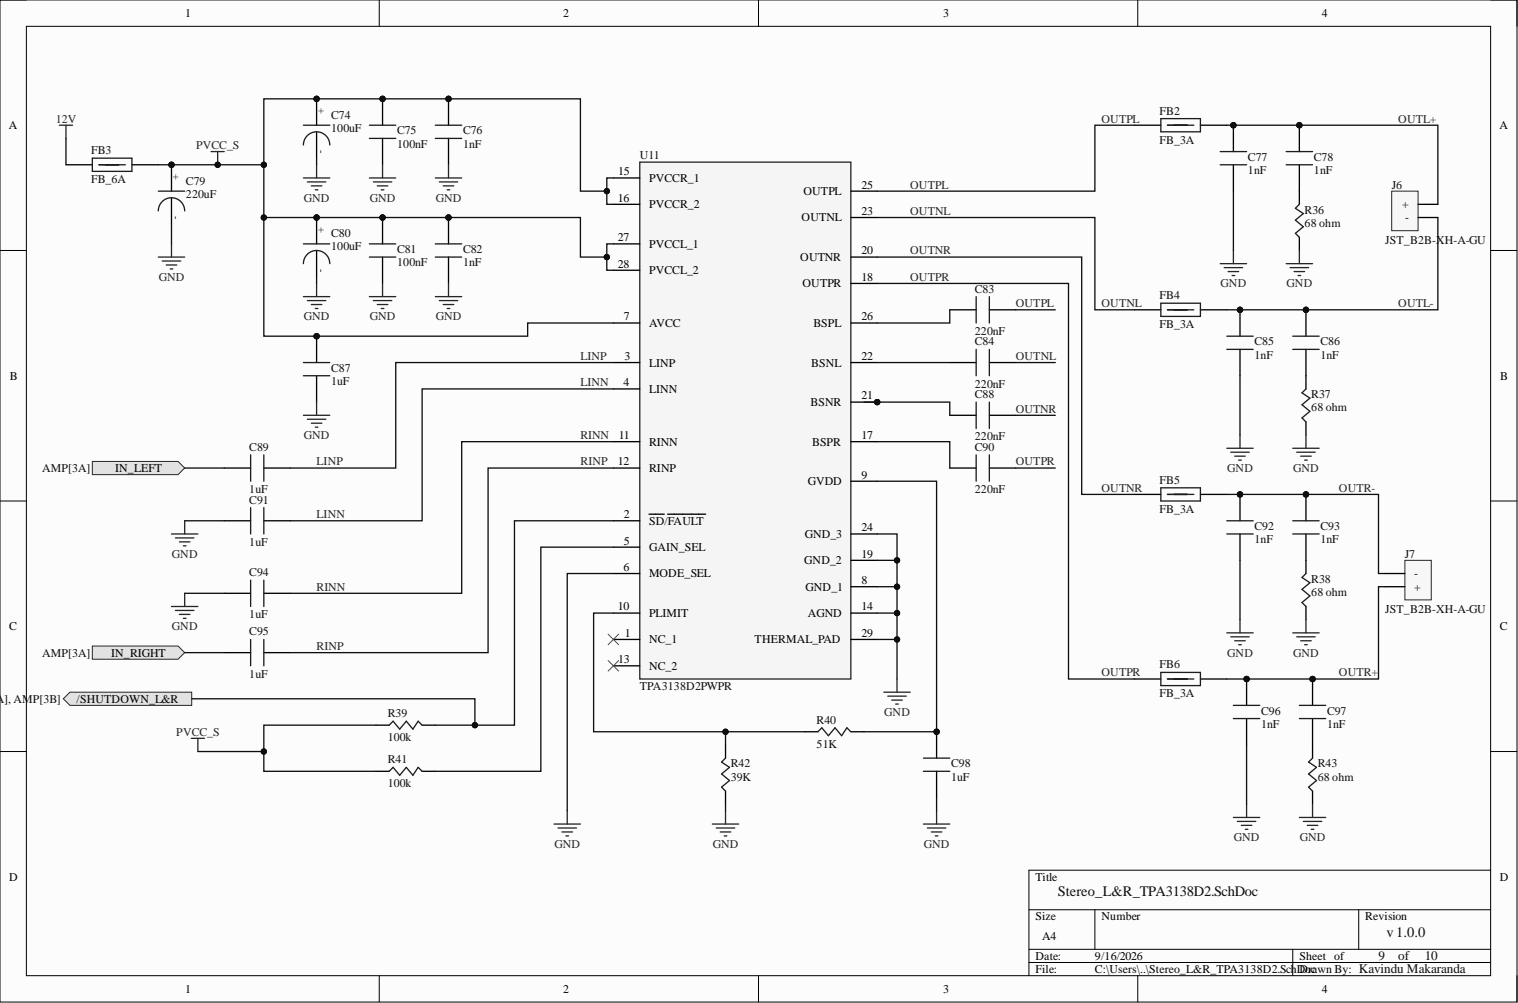
[picture p12: page 12]

1 8 | O U T PR
2 6 | | C8 | 3

G N D RIN N | | 1 1

LIN P RIN P | 1 2 | | 9

LIN N | 2

RIN N | | 5

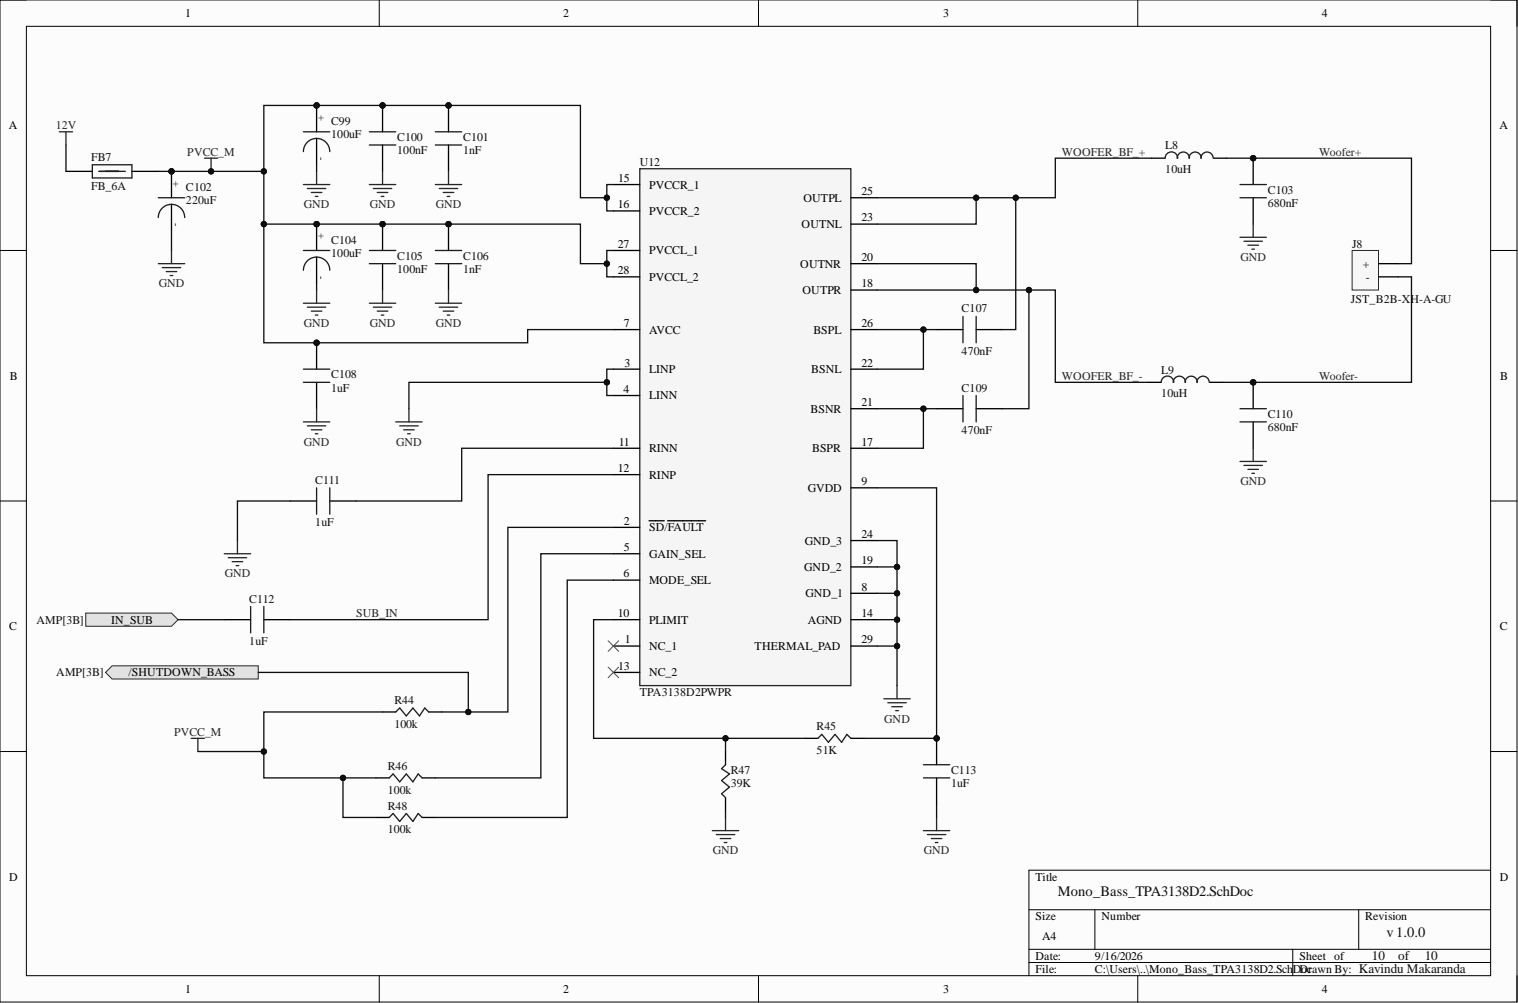
[picture p13: page 13]

RINP 12

1uF | SD/FAULT 2

GAIN_SEL 5

MODE_SEL 6

PLIMIT 10

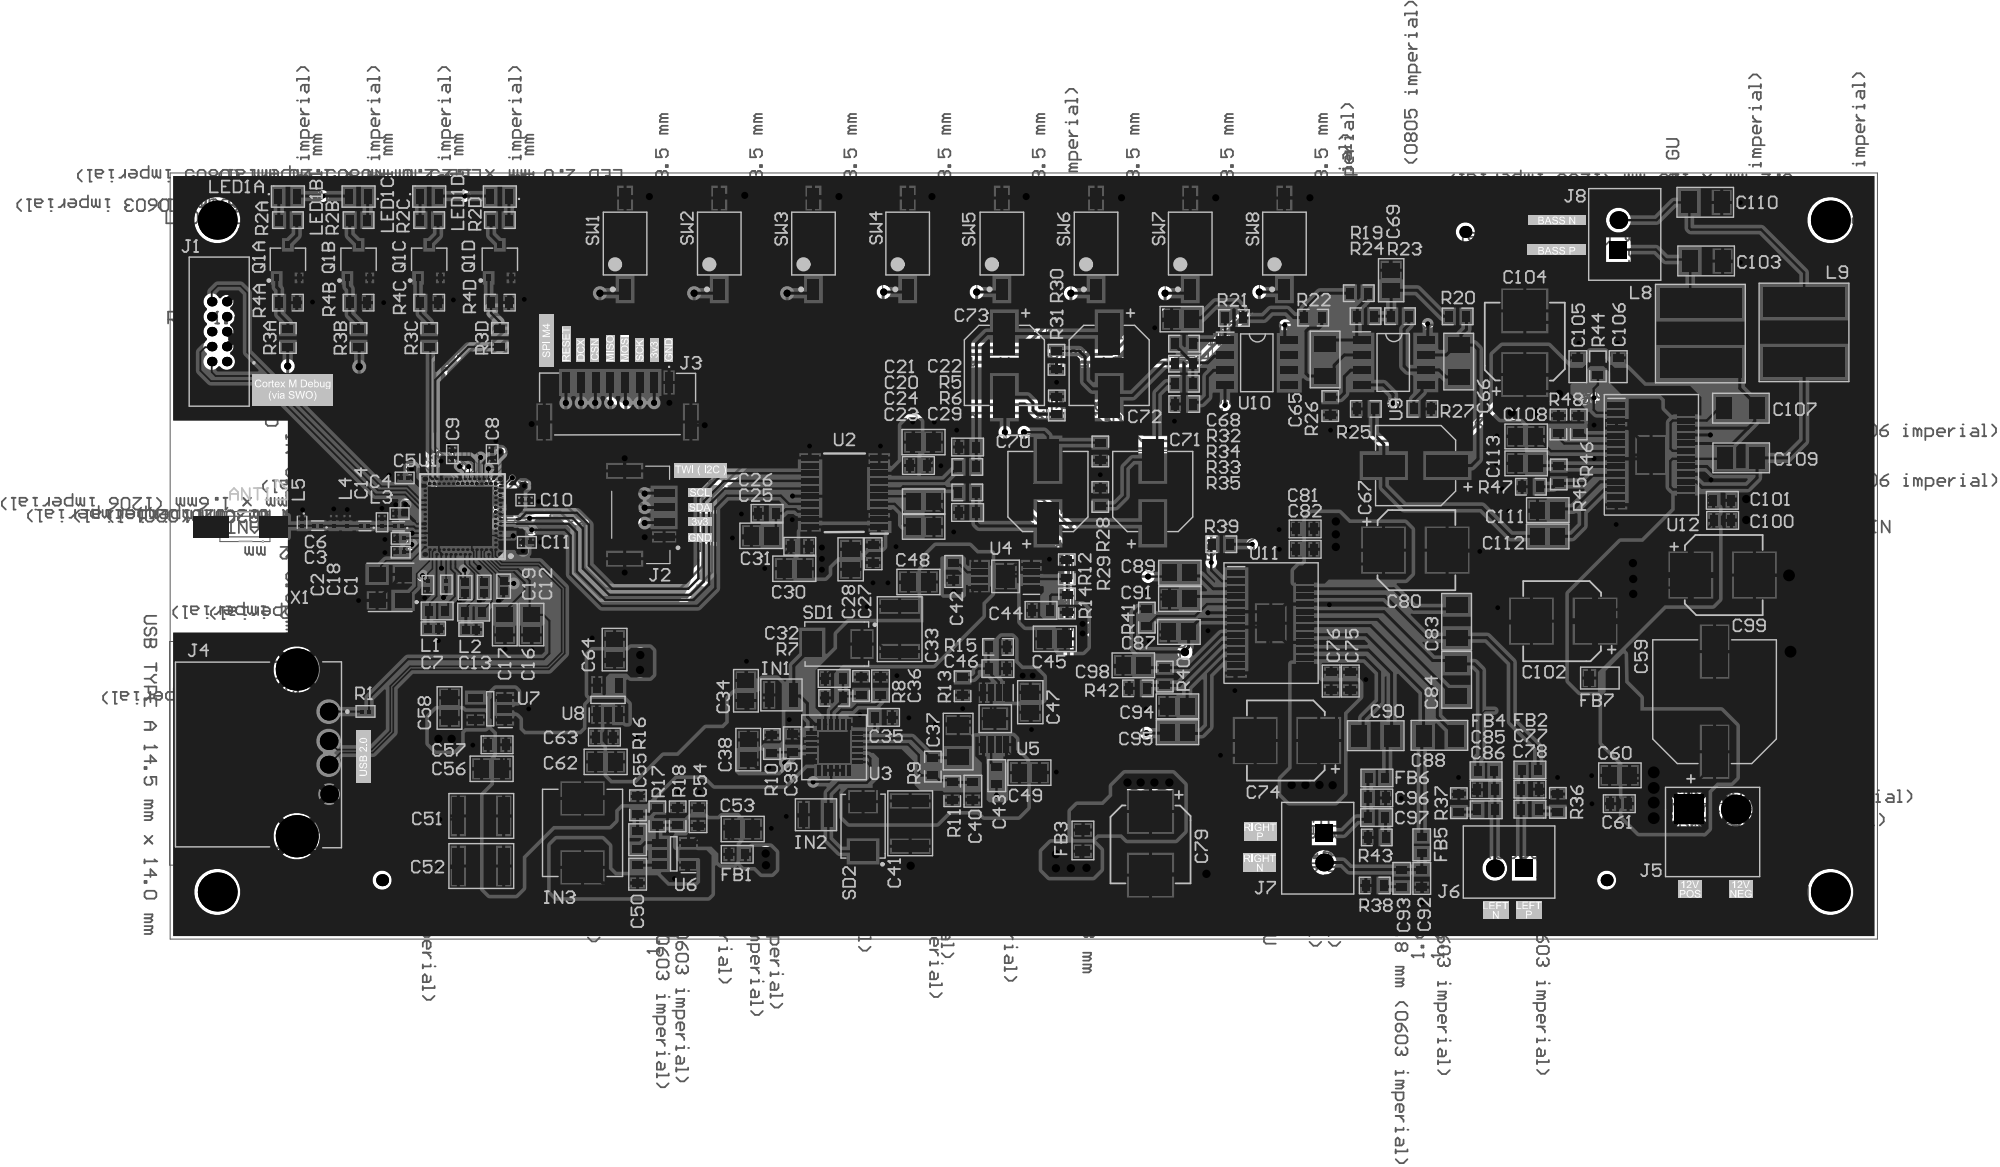
[picture p14: page 14]
