Makara97/Bluetooth_Speaker_Setup/Bluetooth_Speaker_Driver/Project Outputs for Bluetooth_Speaker_Driver/PDF/Report Board Stack/Report_Board_Stack.PDF

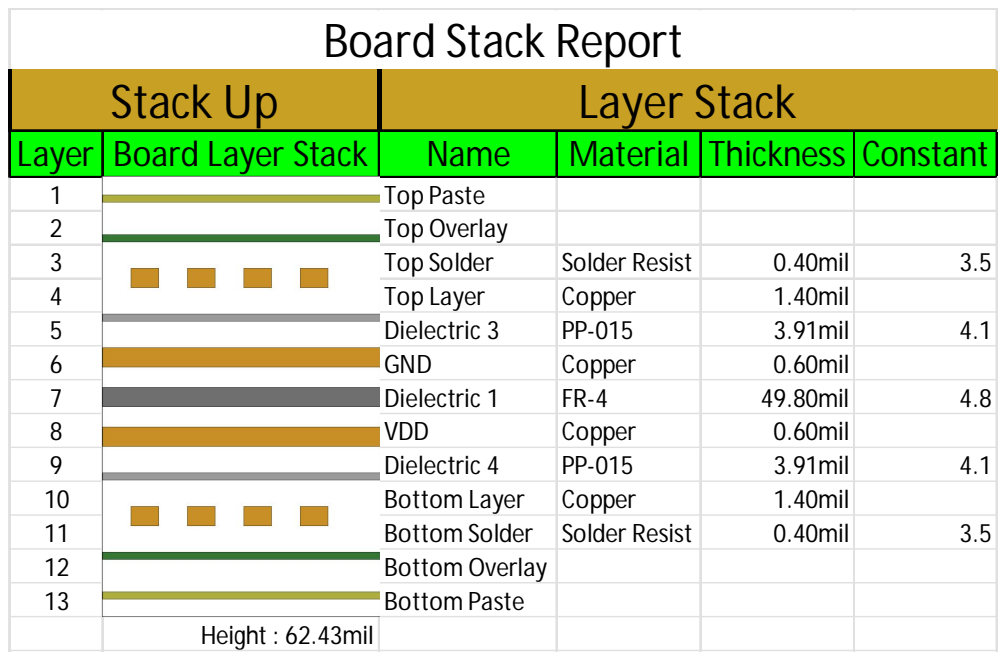
[picture p15: page 1]

Stack Up | Layer Stack
Layer | Board Layer Stack | Name | Material | Thickness | Constant
1 | | Top Paste
2 | | Top Overlay
3 | | Top Solder | Solder Resist | 0.40mil | 3.5
4 | | Top Layer | Copper | 1.40mil
5 | | Dielectric 3 | PP-015 | 3.91mil | 4.1
6 | | GND | Copper | 0.60mil
7 | | Dielectric 1 | FR-4 | 49.80mil | 4.8
8 | | VDD | Copper | 0.60mil
9 | | Dielectric 4 | PP-015 | 3.91mil | 4.1
10 | | Bottom Layer | Copper | 1.40mil
11 | | Bottom Solder | Solder Resist | 0.40mil | 3.5
12 | | Bottom Overlay
13 | | Bottom Paste

Height : 62.43mil
