Makara97/Bluetooth_Speaker_Setup/Bluetooth_Speaker_Driver/Project Outputs for Bluetooth_Speaker_Driver/PDF/Assembly Drawings/Assembly_Drawings.PDF

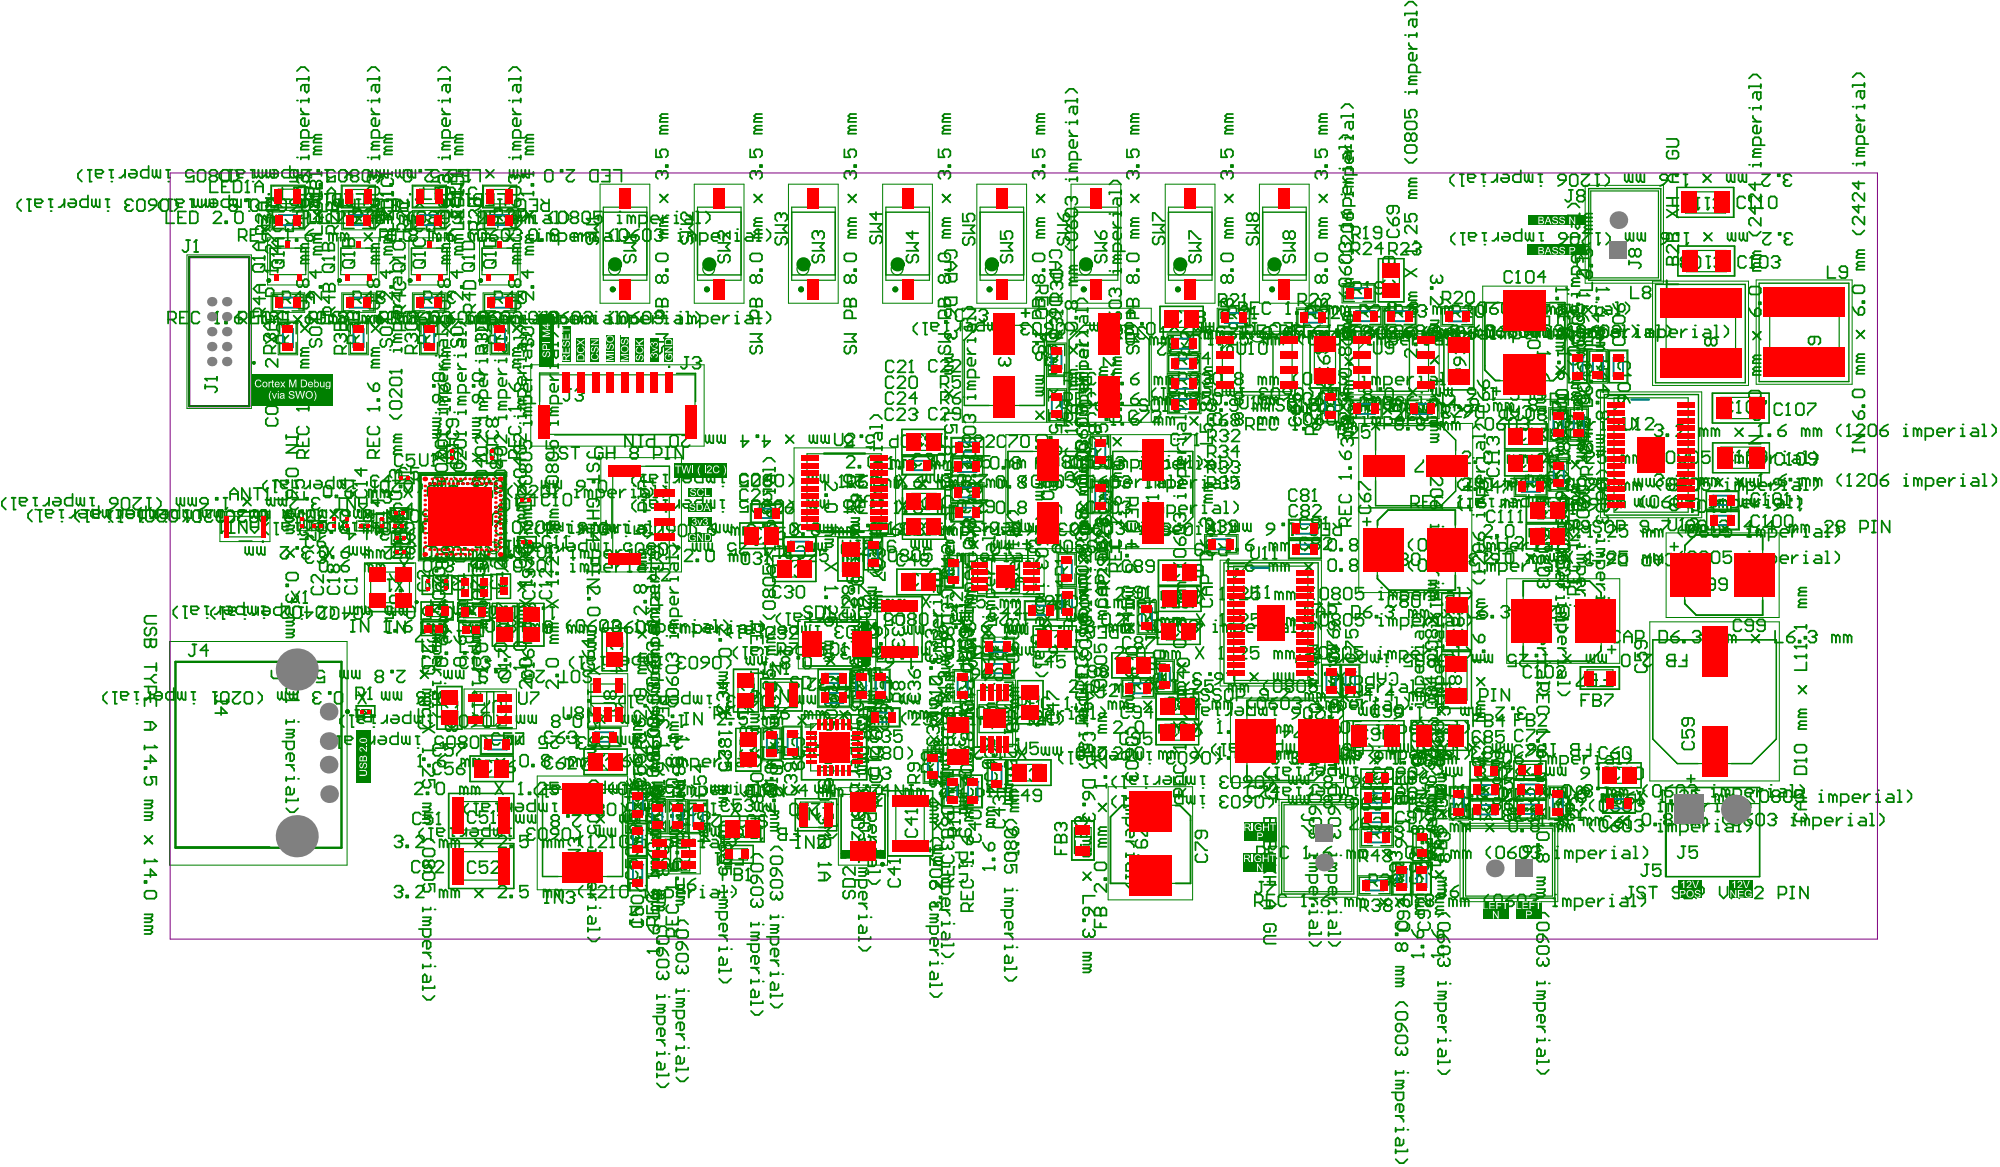
[picture p26: page 1]

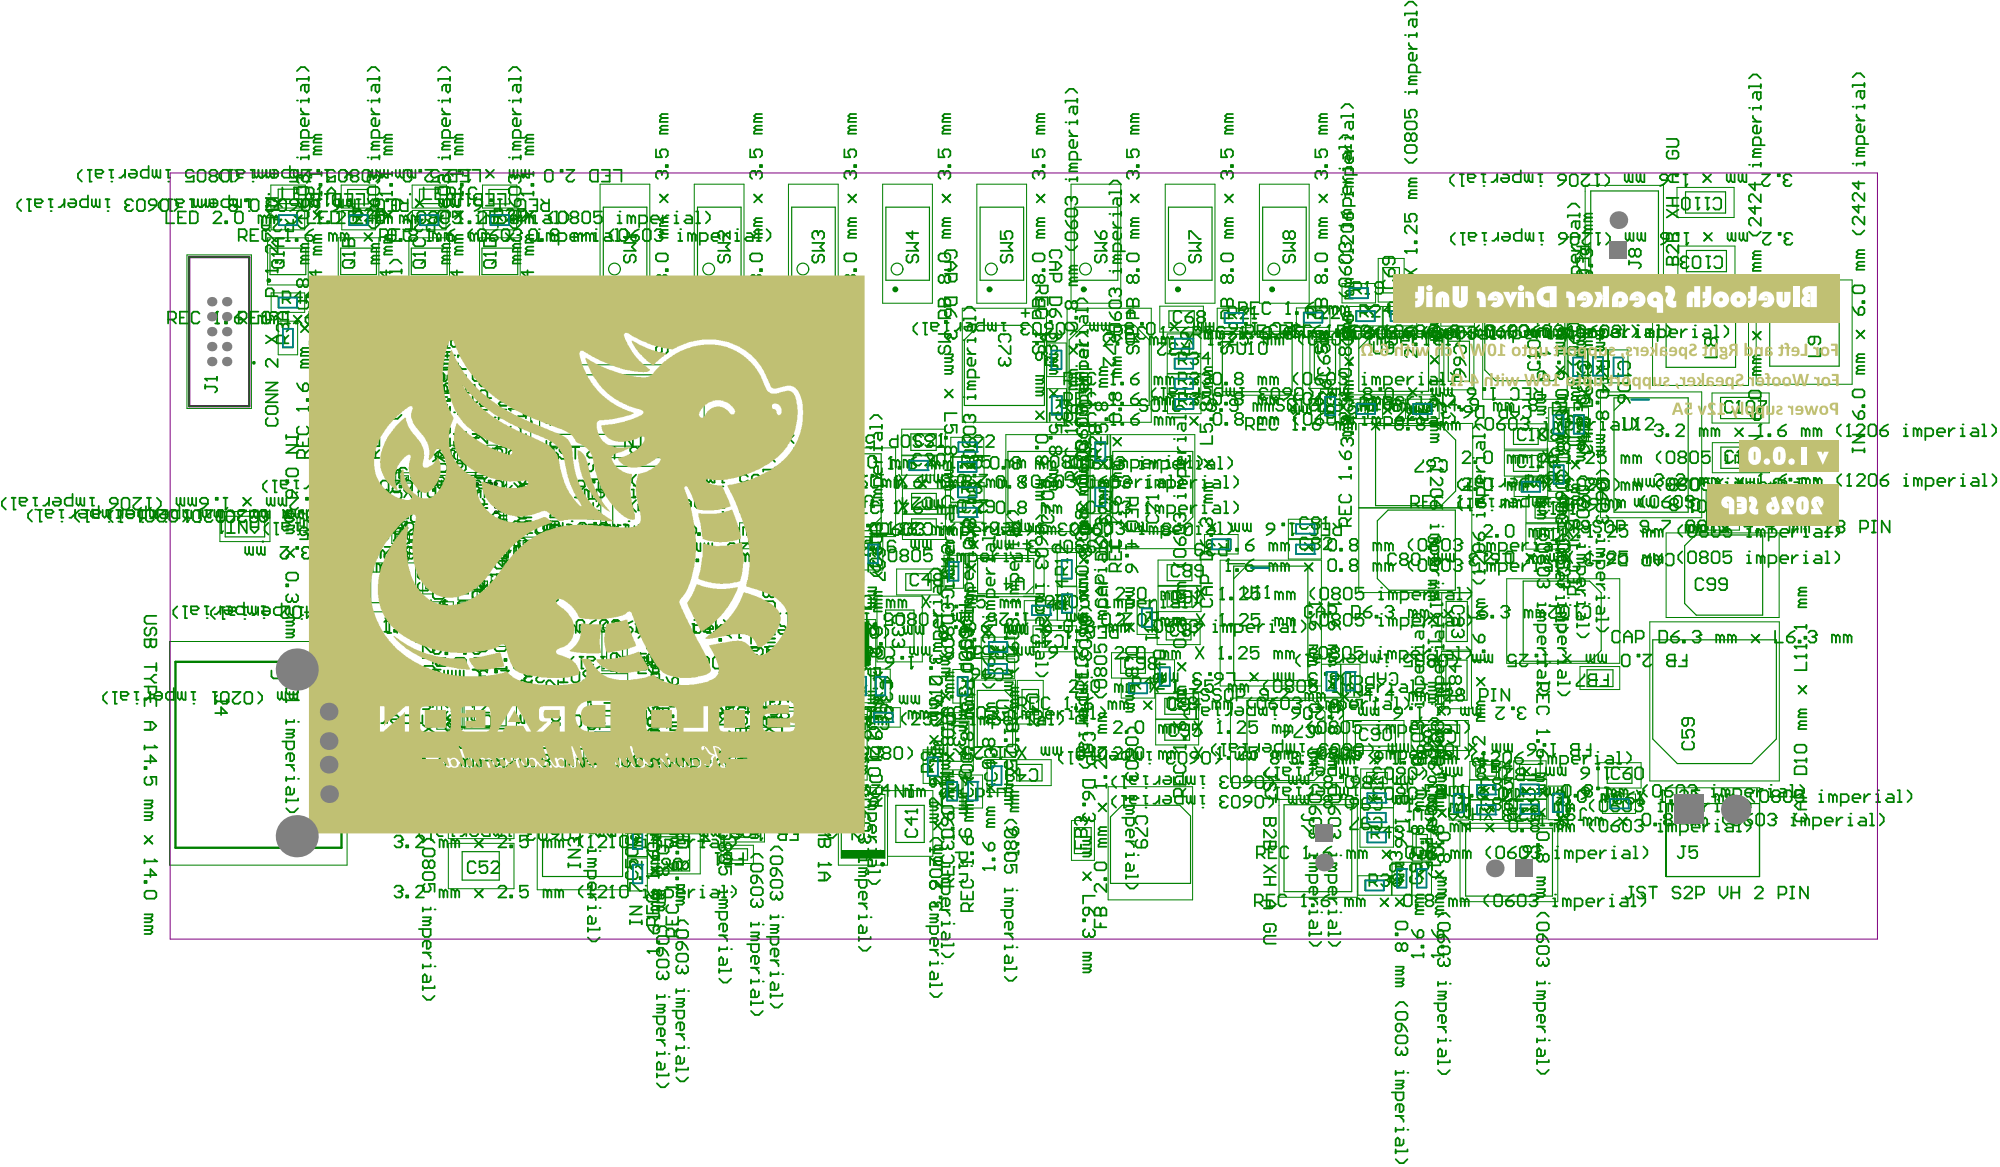
[picture p27: page 2]
