Makara97/Bluetooth_Speaker_Setup/Bluetooth_Speaker_Driver/Project Outputs for Bluetooth_Speaker_Driver/PDF/Drill Drawing_Guides/Drill_Drawing_Guides.PDF

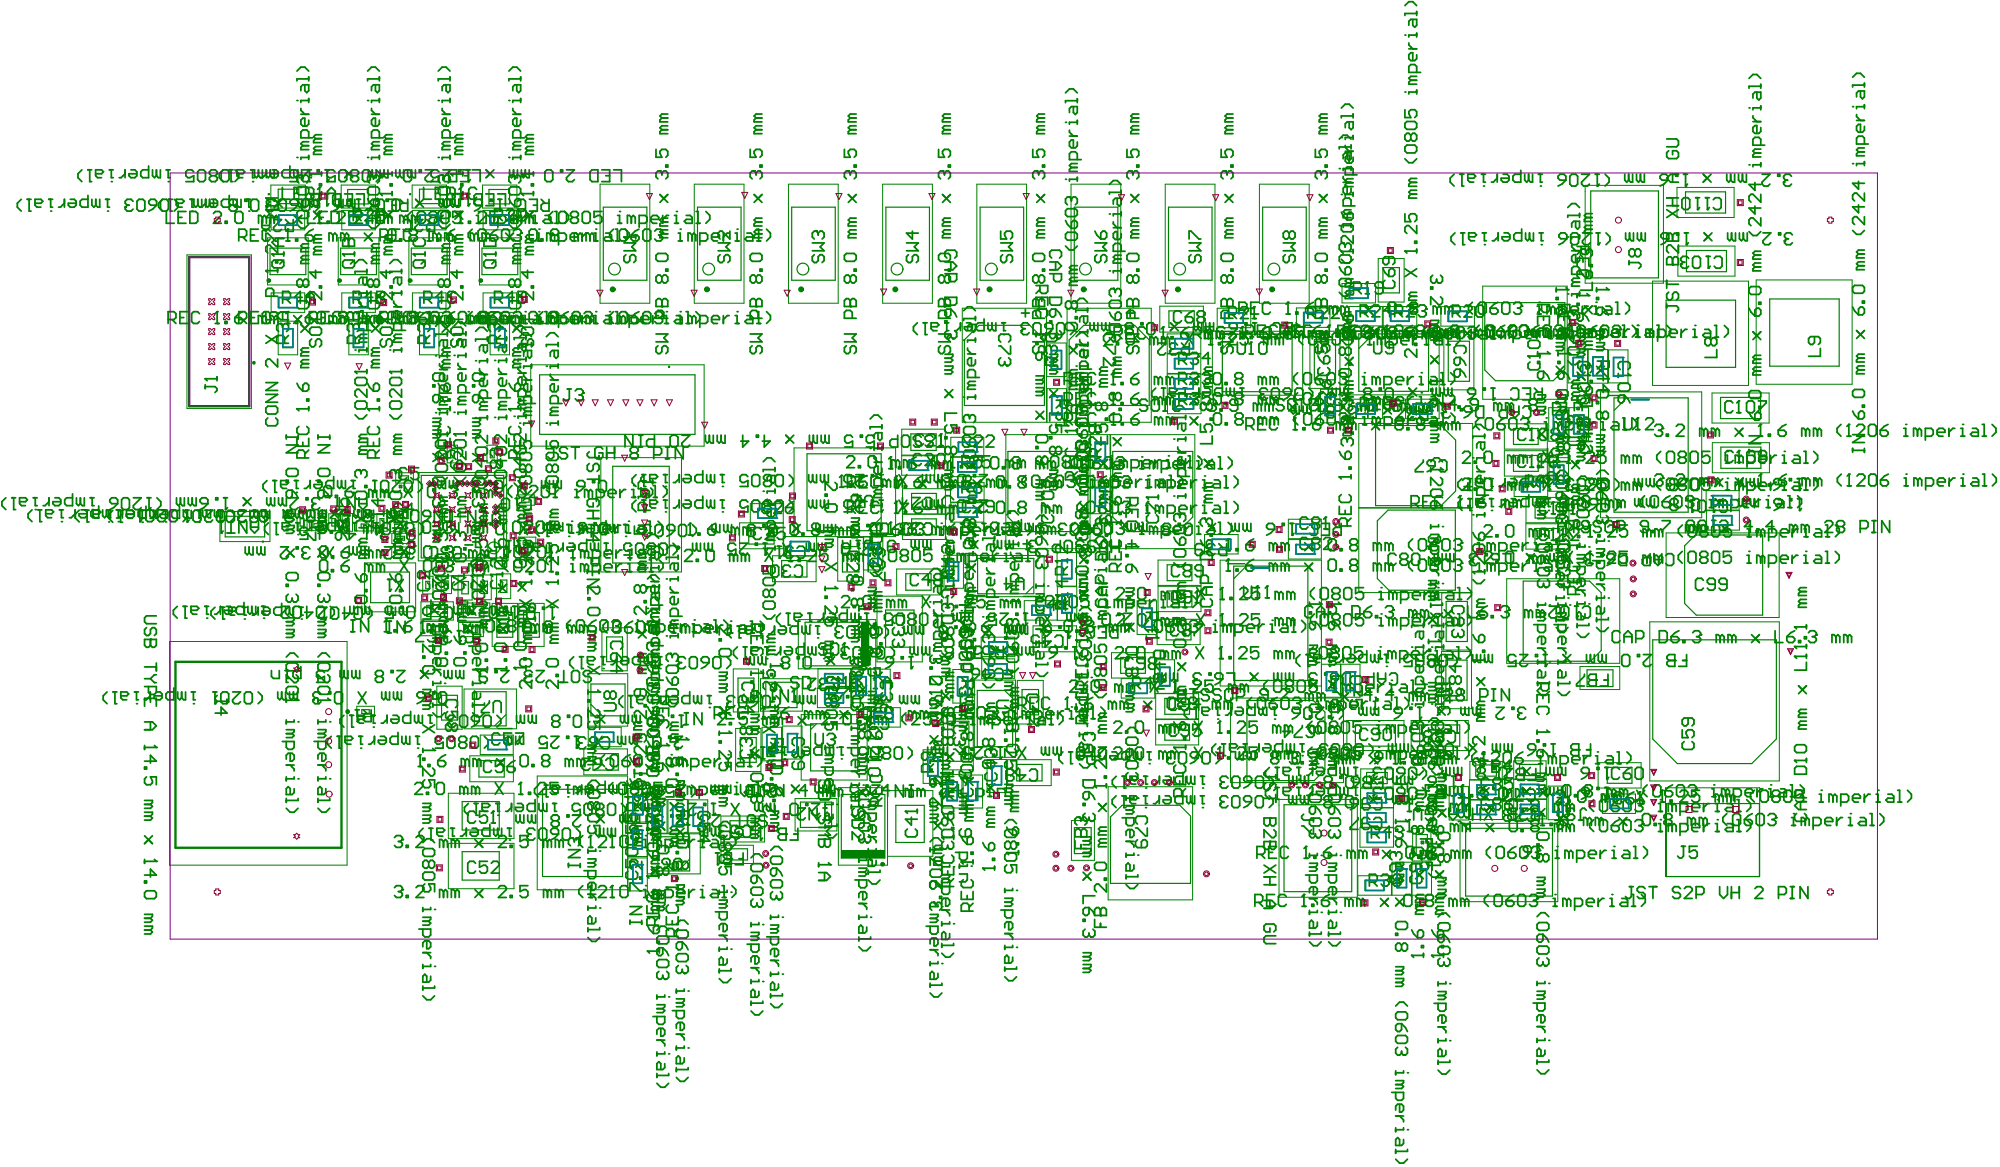
[picture p28: page 1]

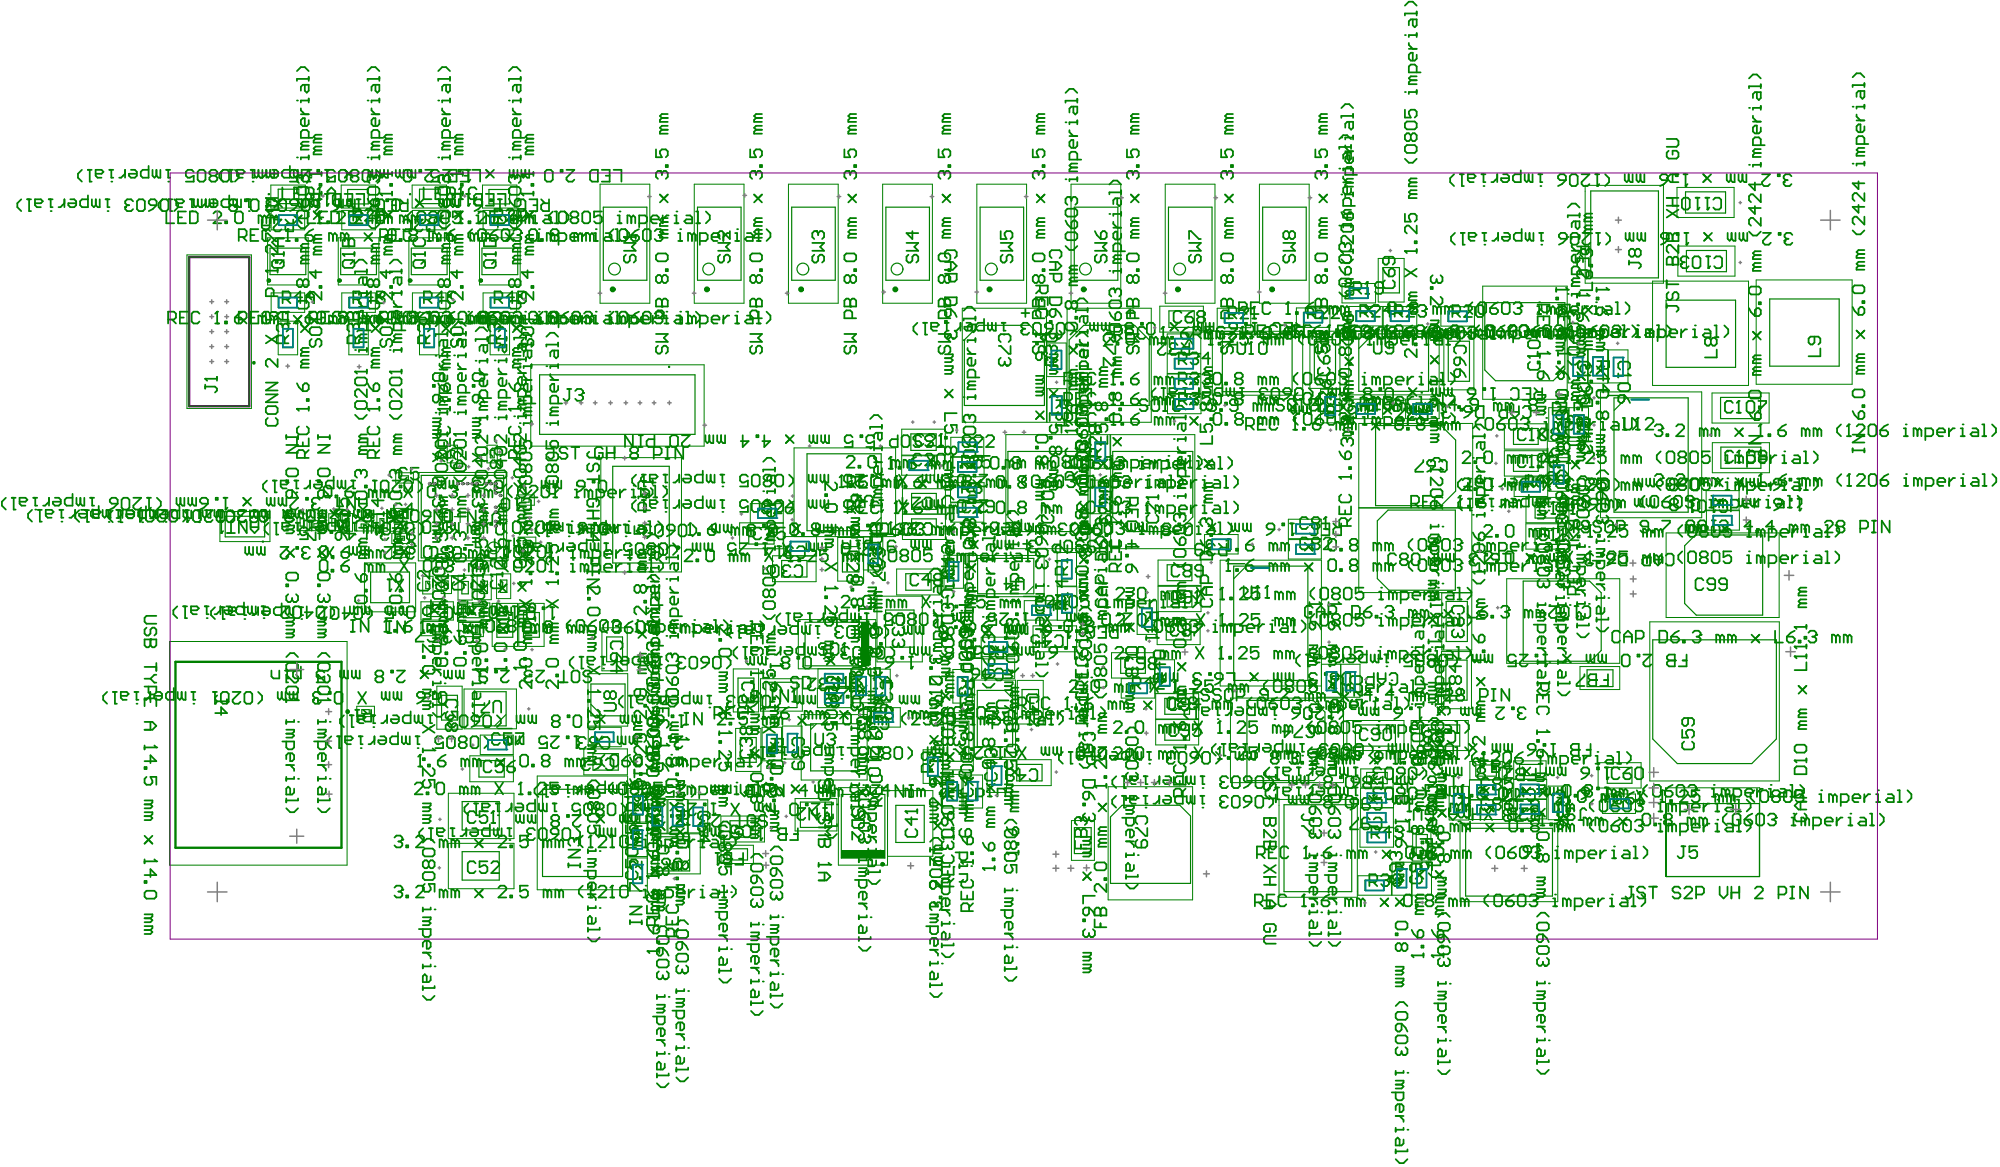
[picture p29: page 2]
