Makara97/Bluetooth_Speaker_Setup/Bluetooth_Speaker_Driver/Project Outputs for Bluetooth_Speaker_Driver/PDF/Final Artwork Prints/Final_Artwork_Print.PDF

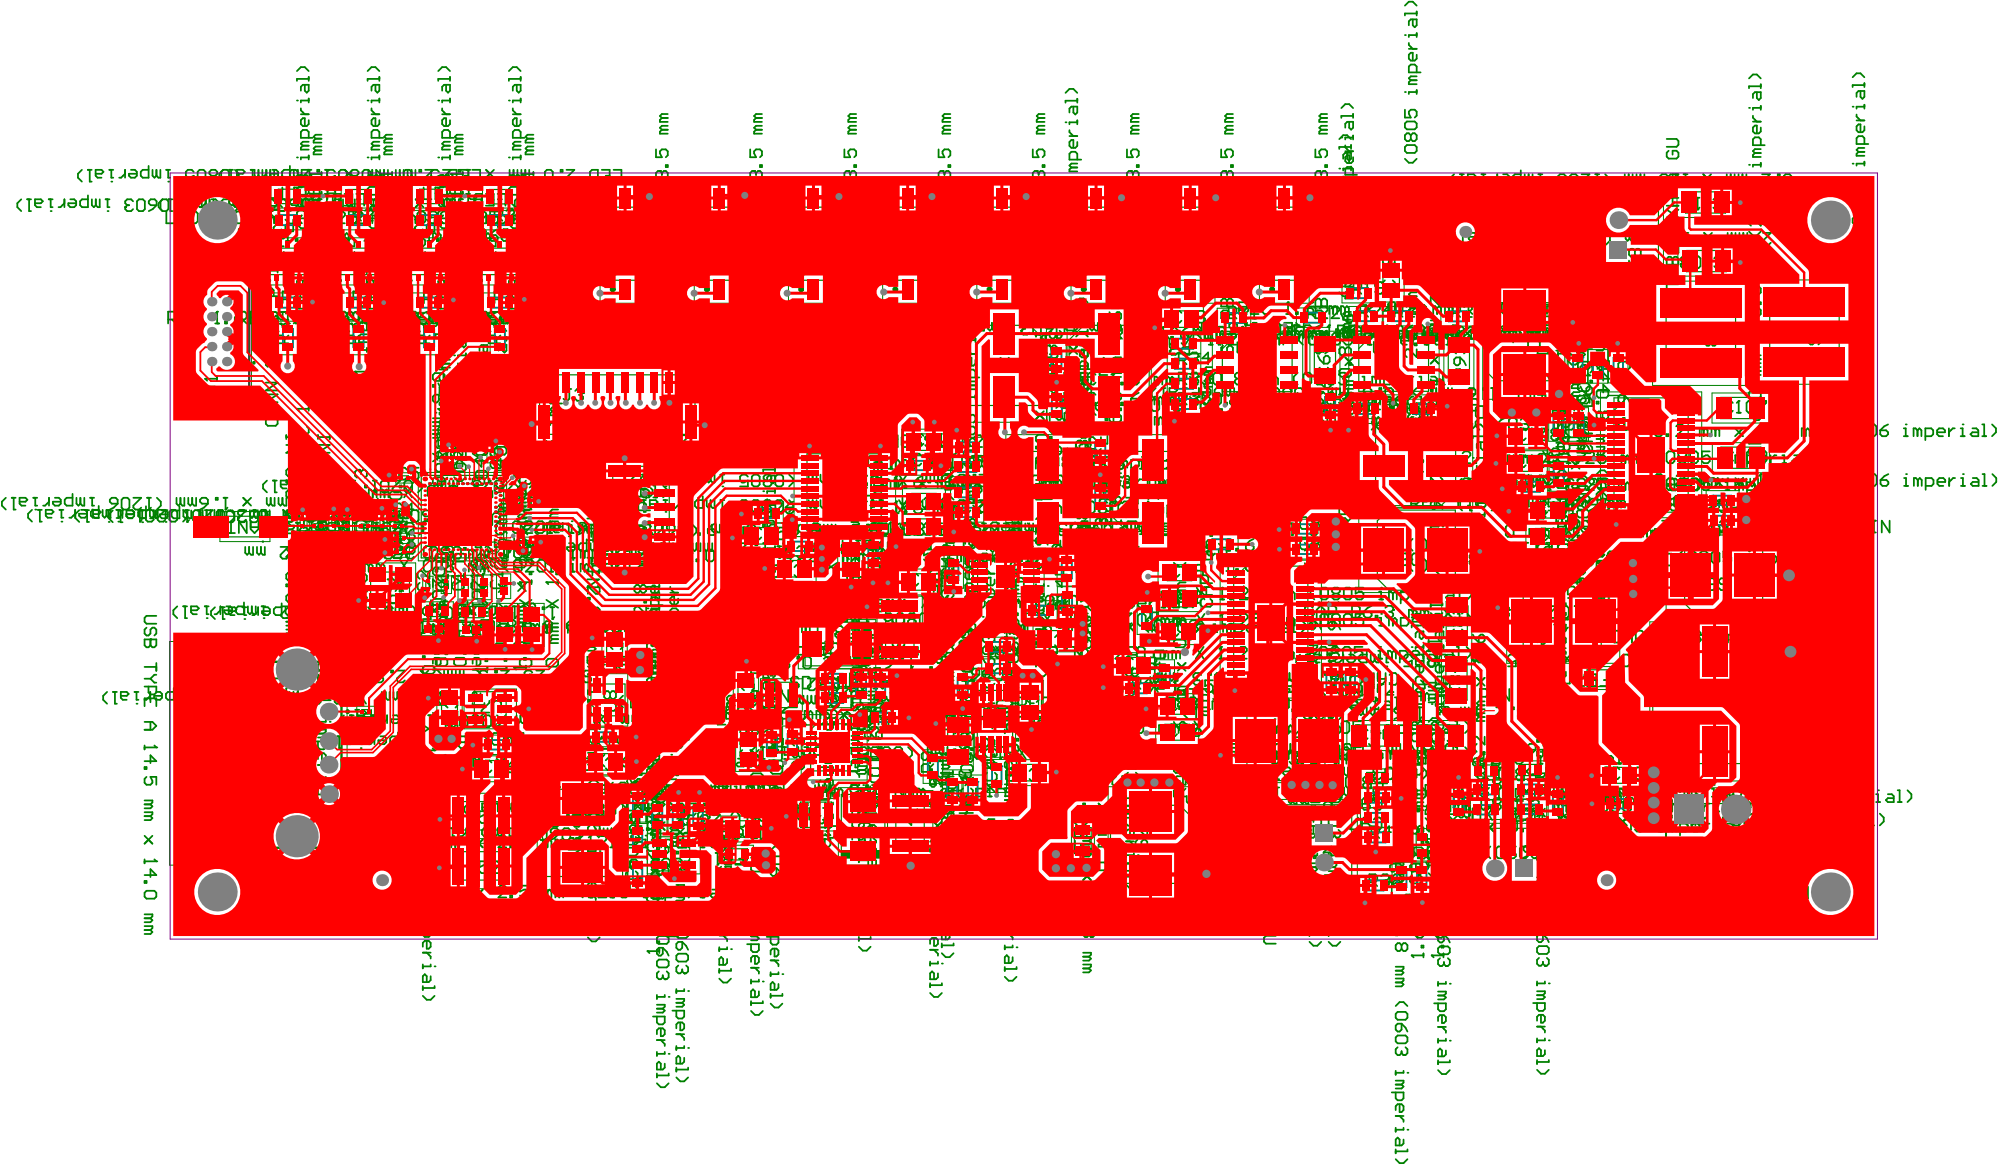
[picture p30: page 1]

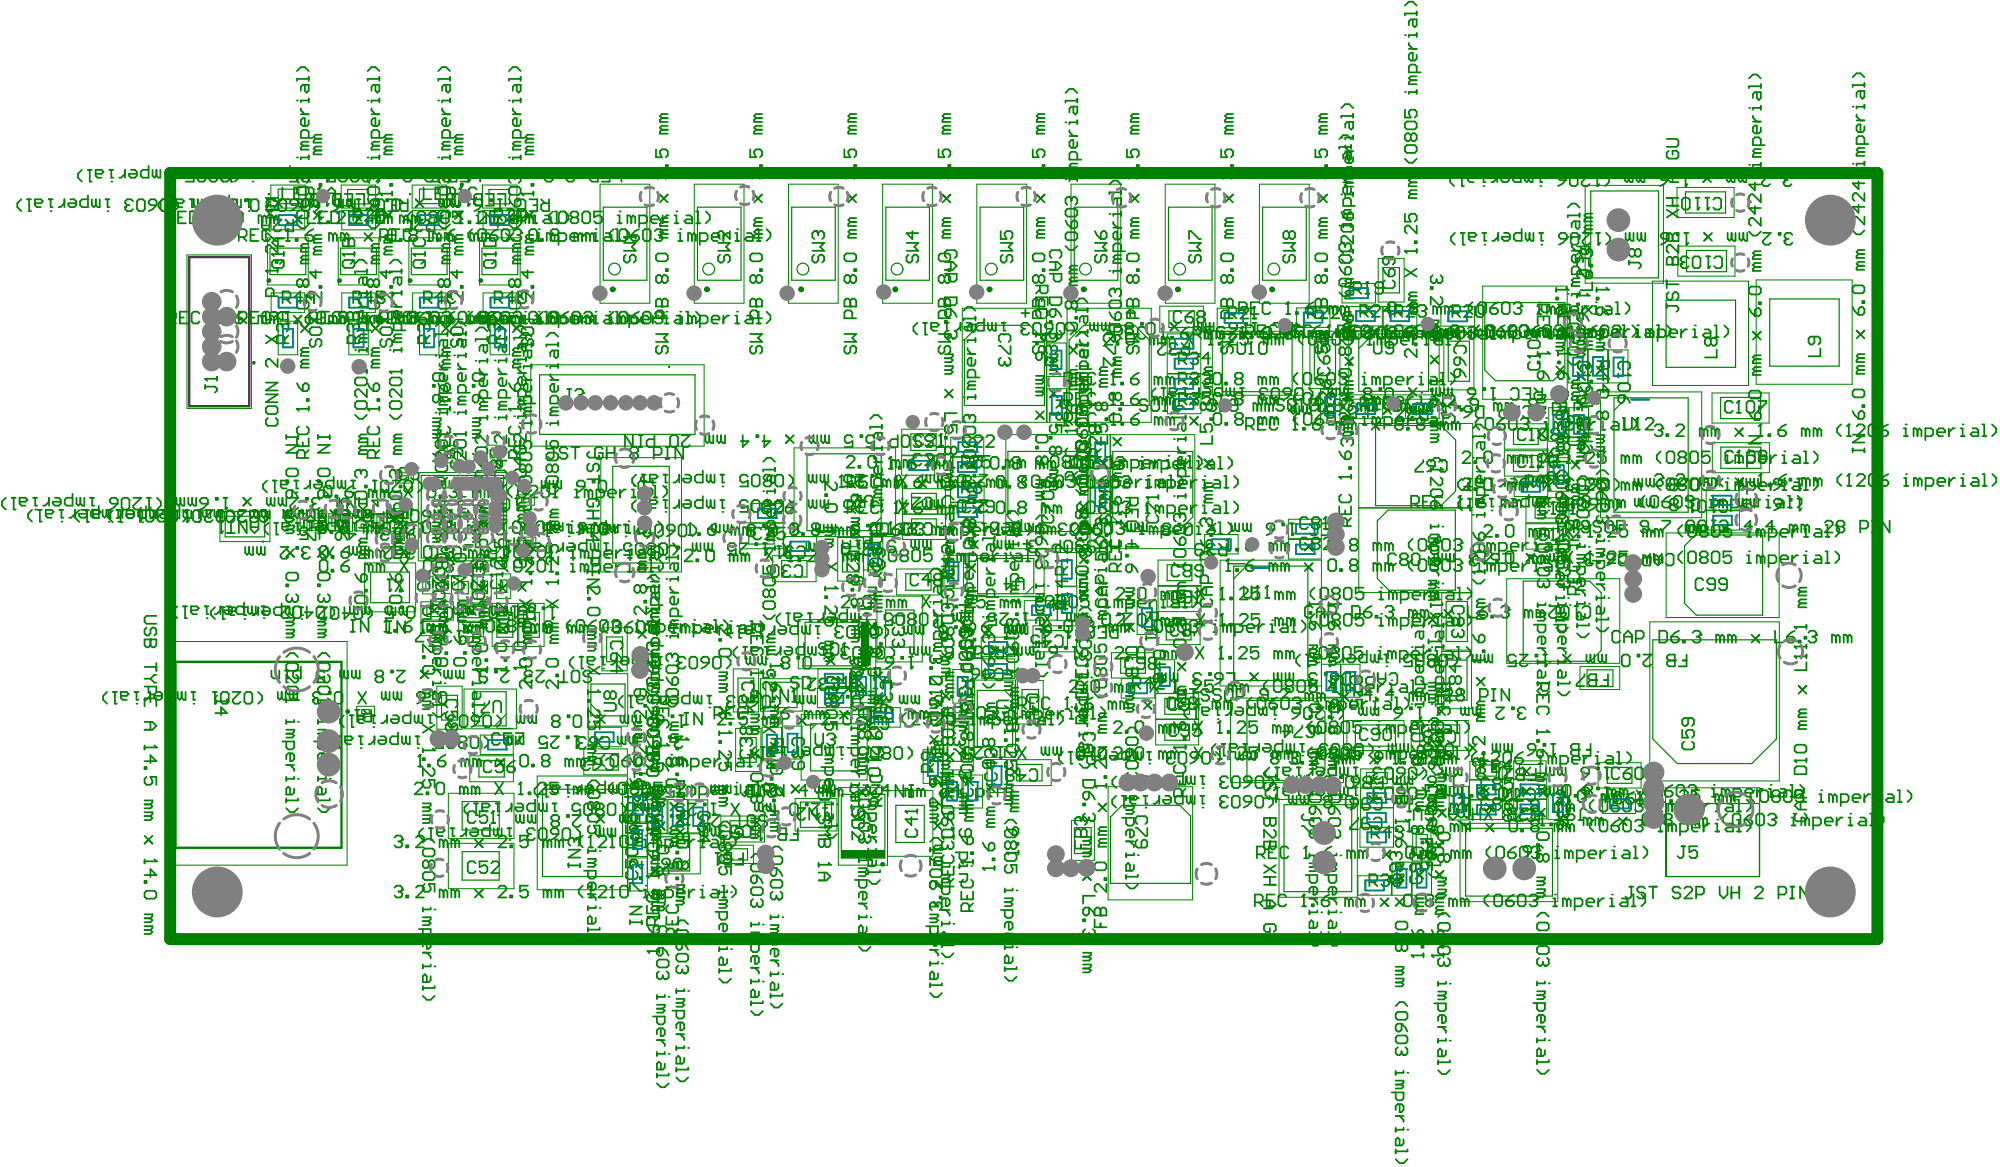
[picture p31: page 2]

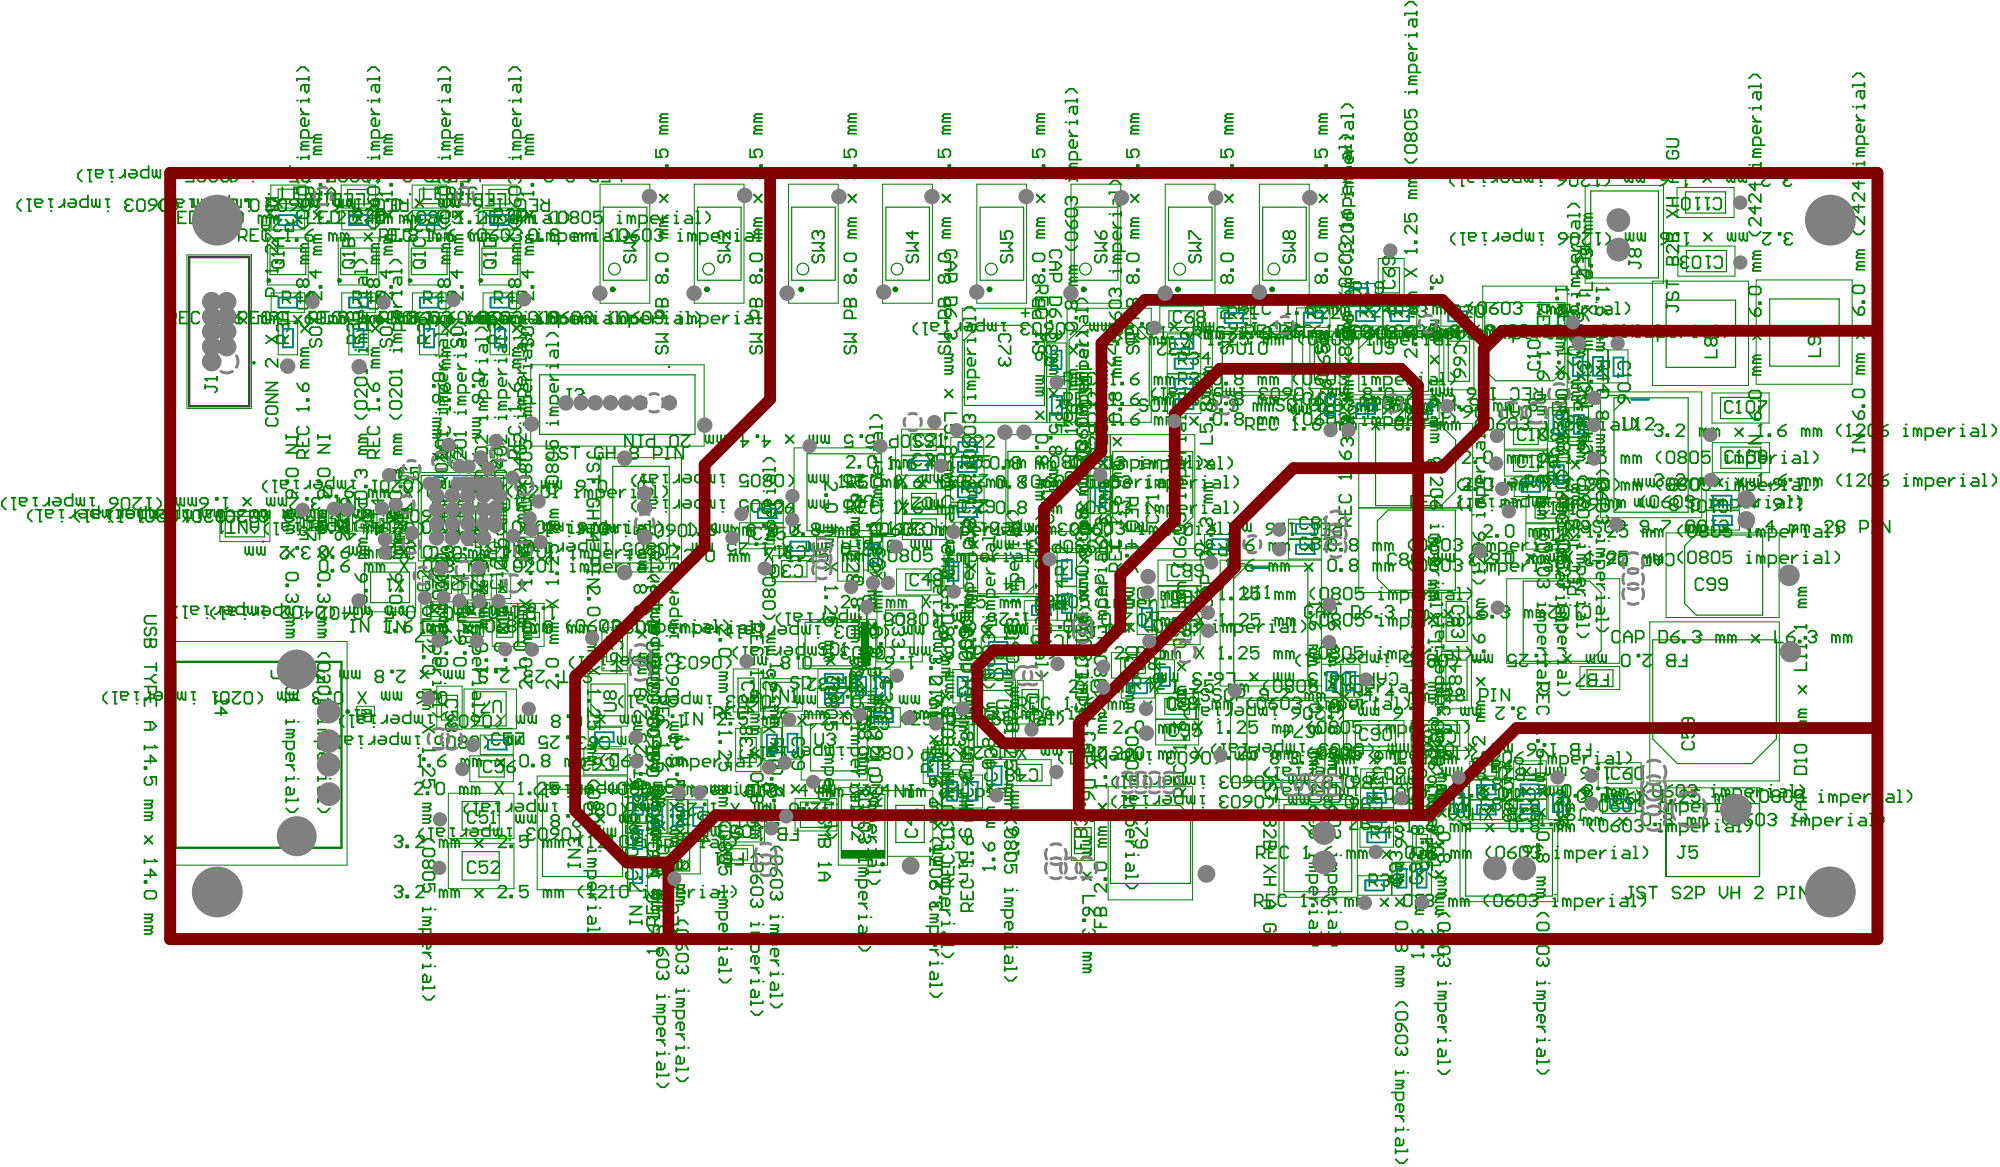
[picture p32: page 3]

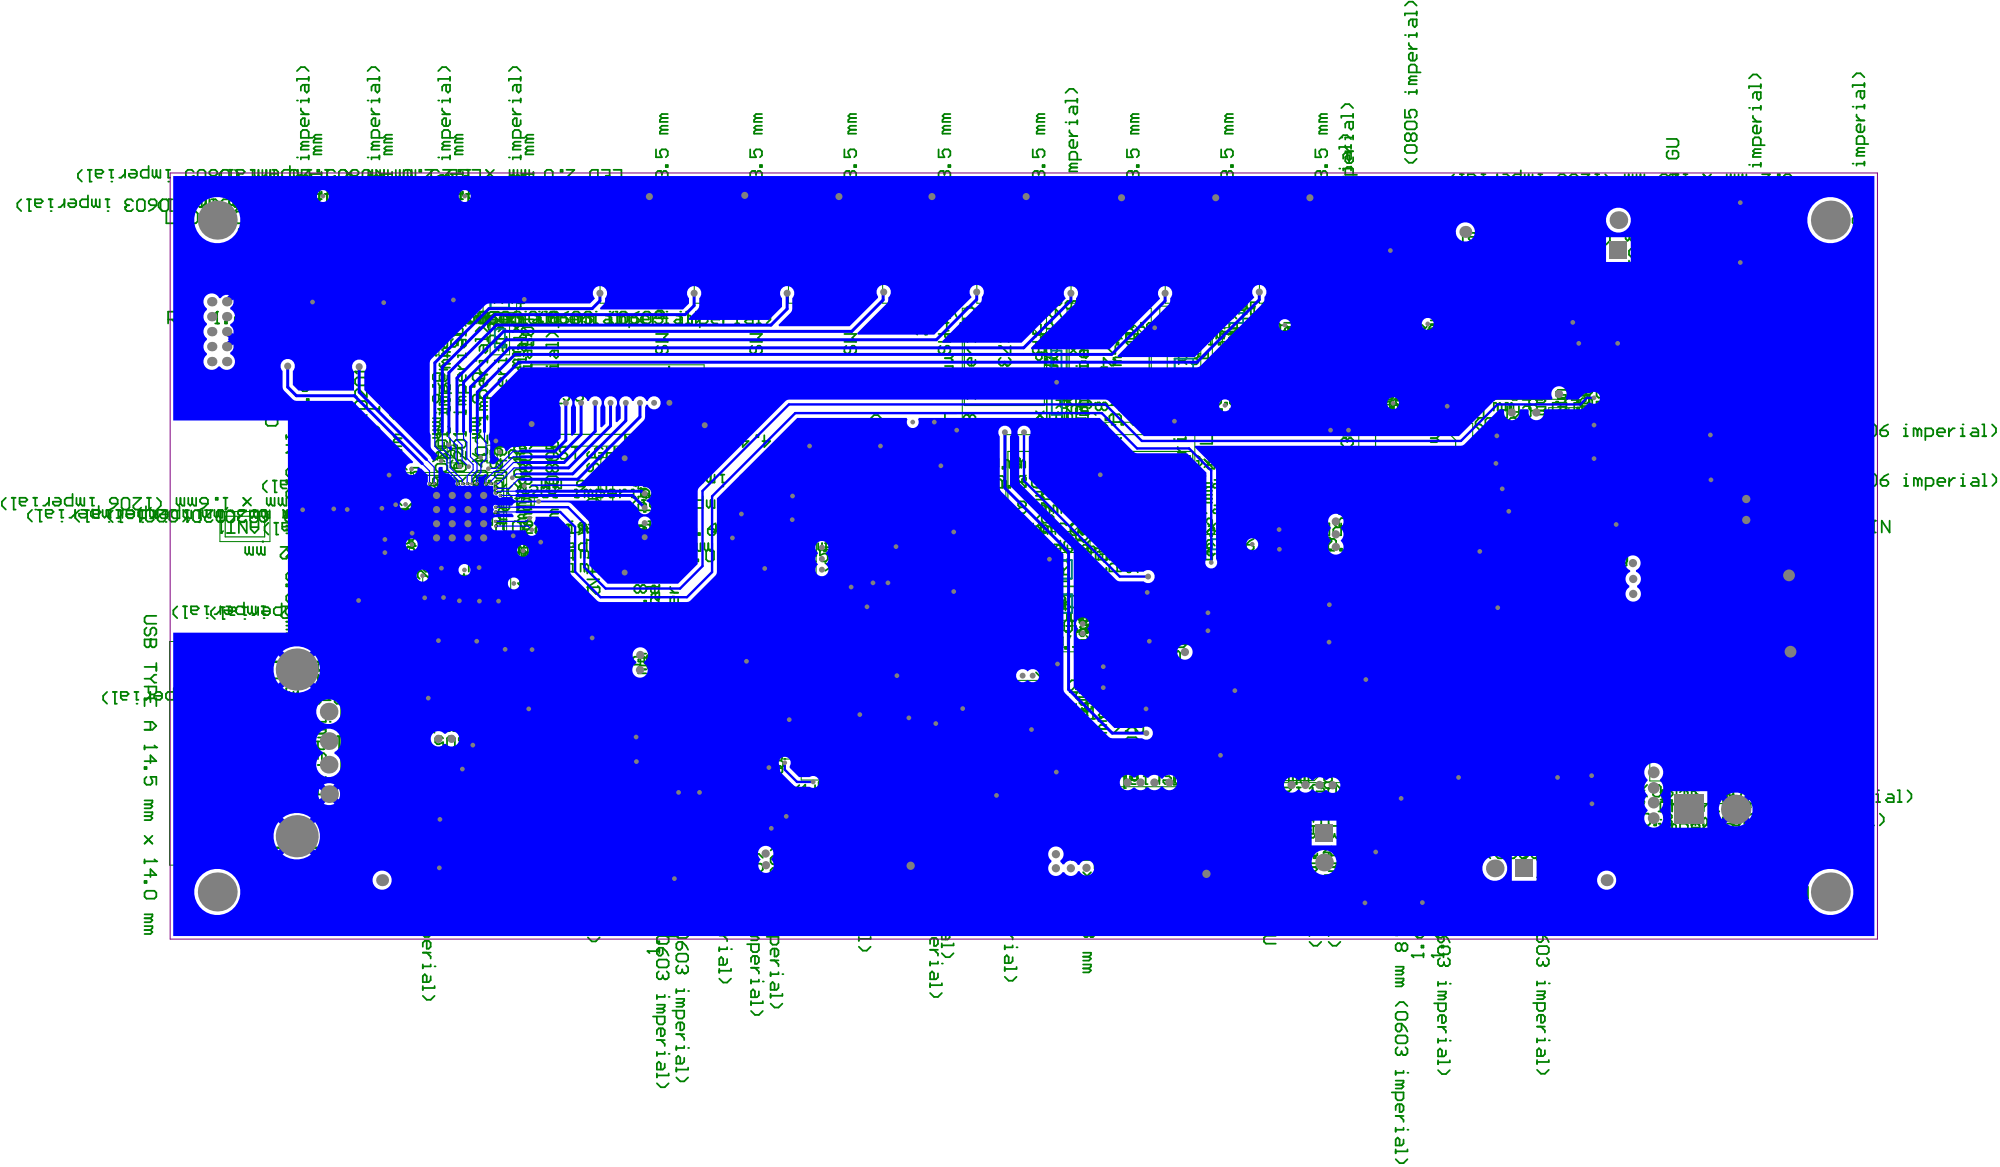
[picture p33: page 4]

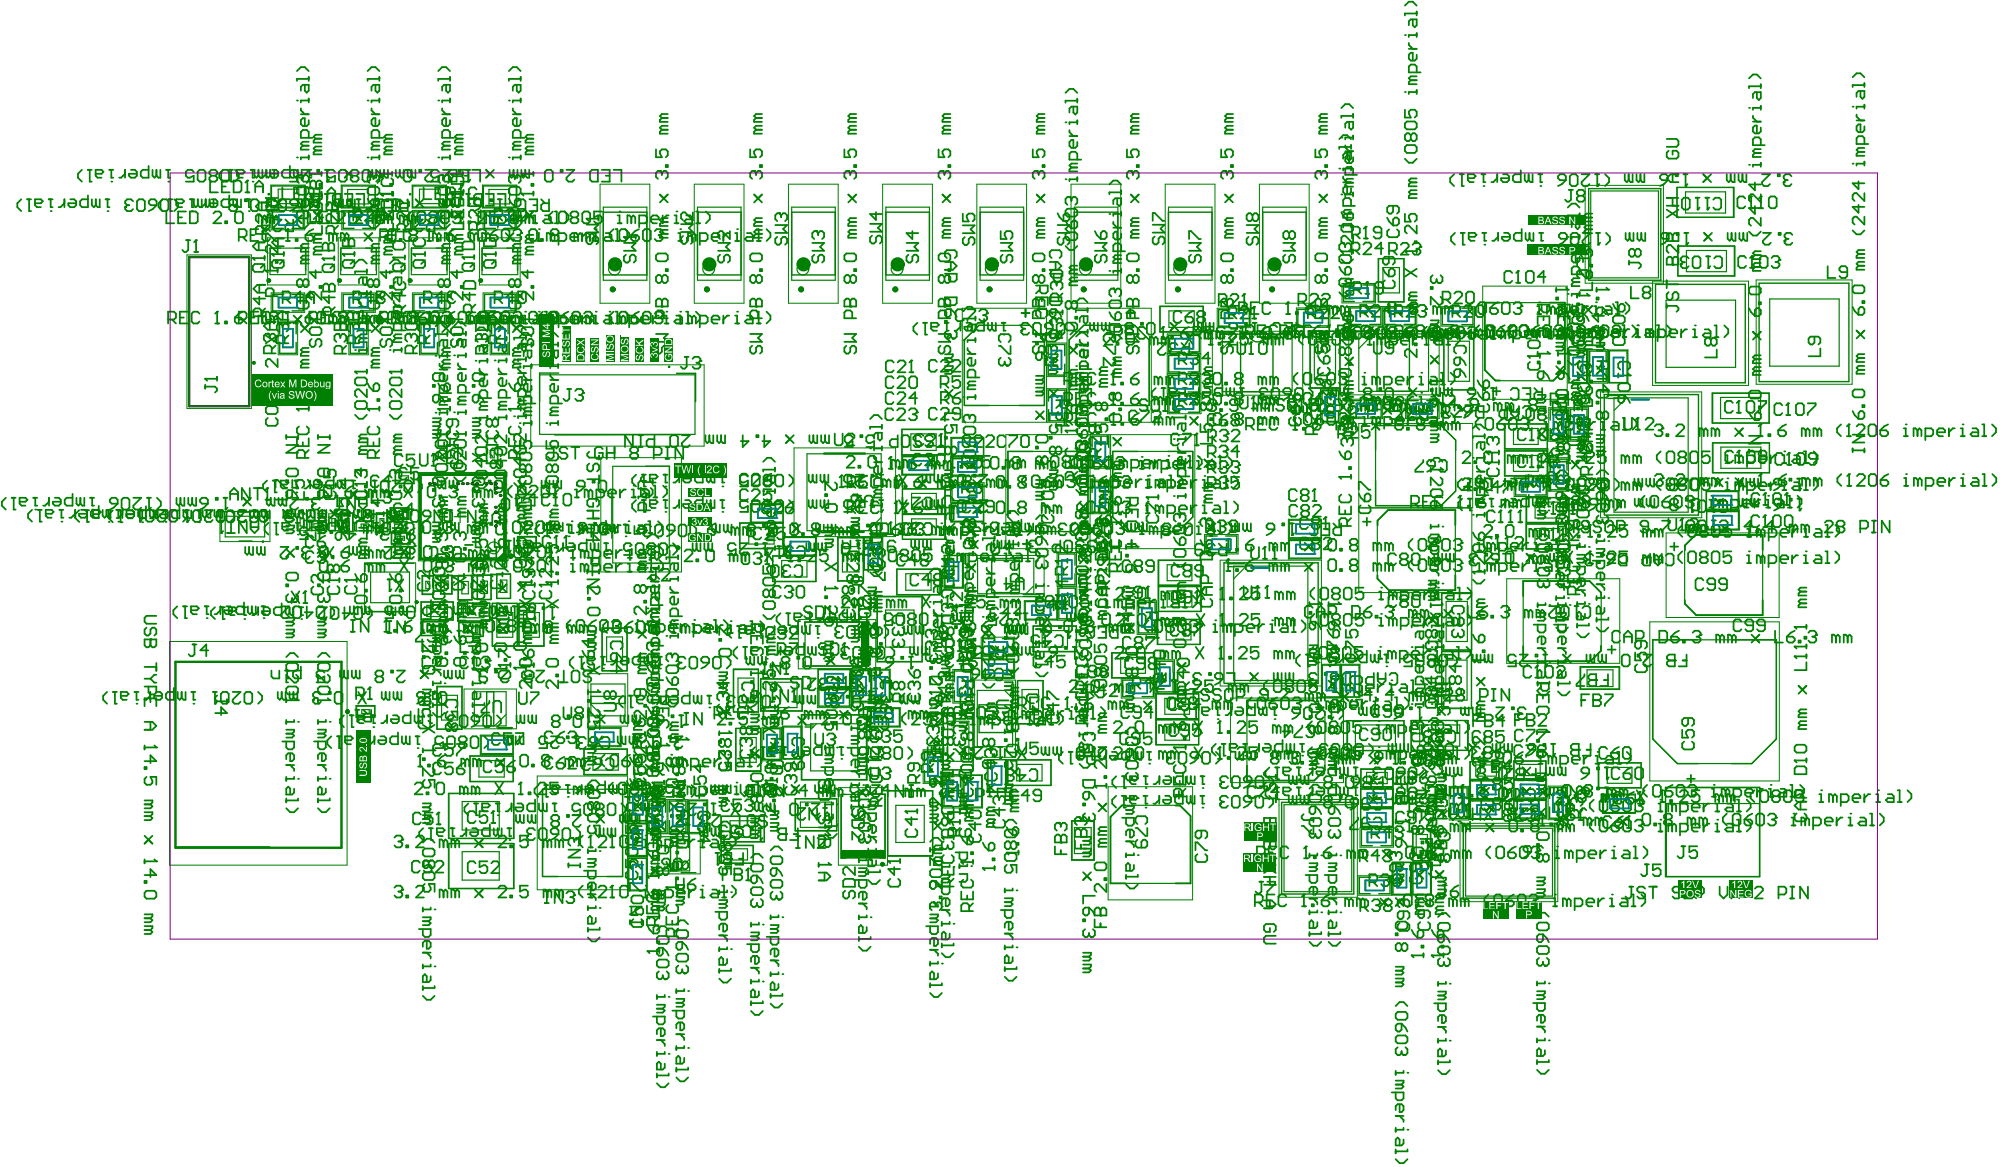
[picture p34: page 5]

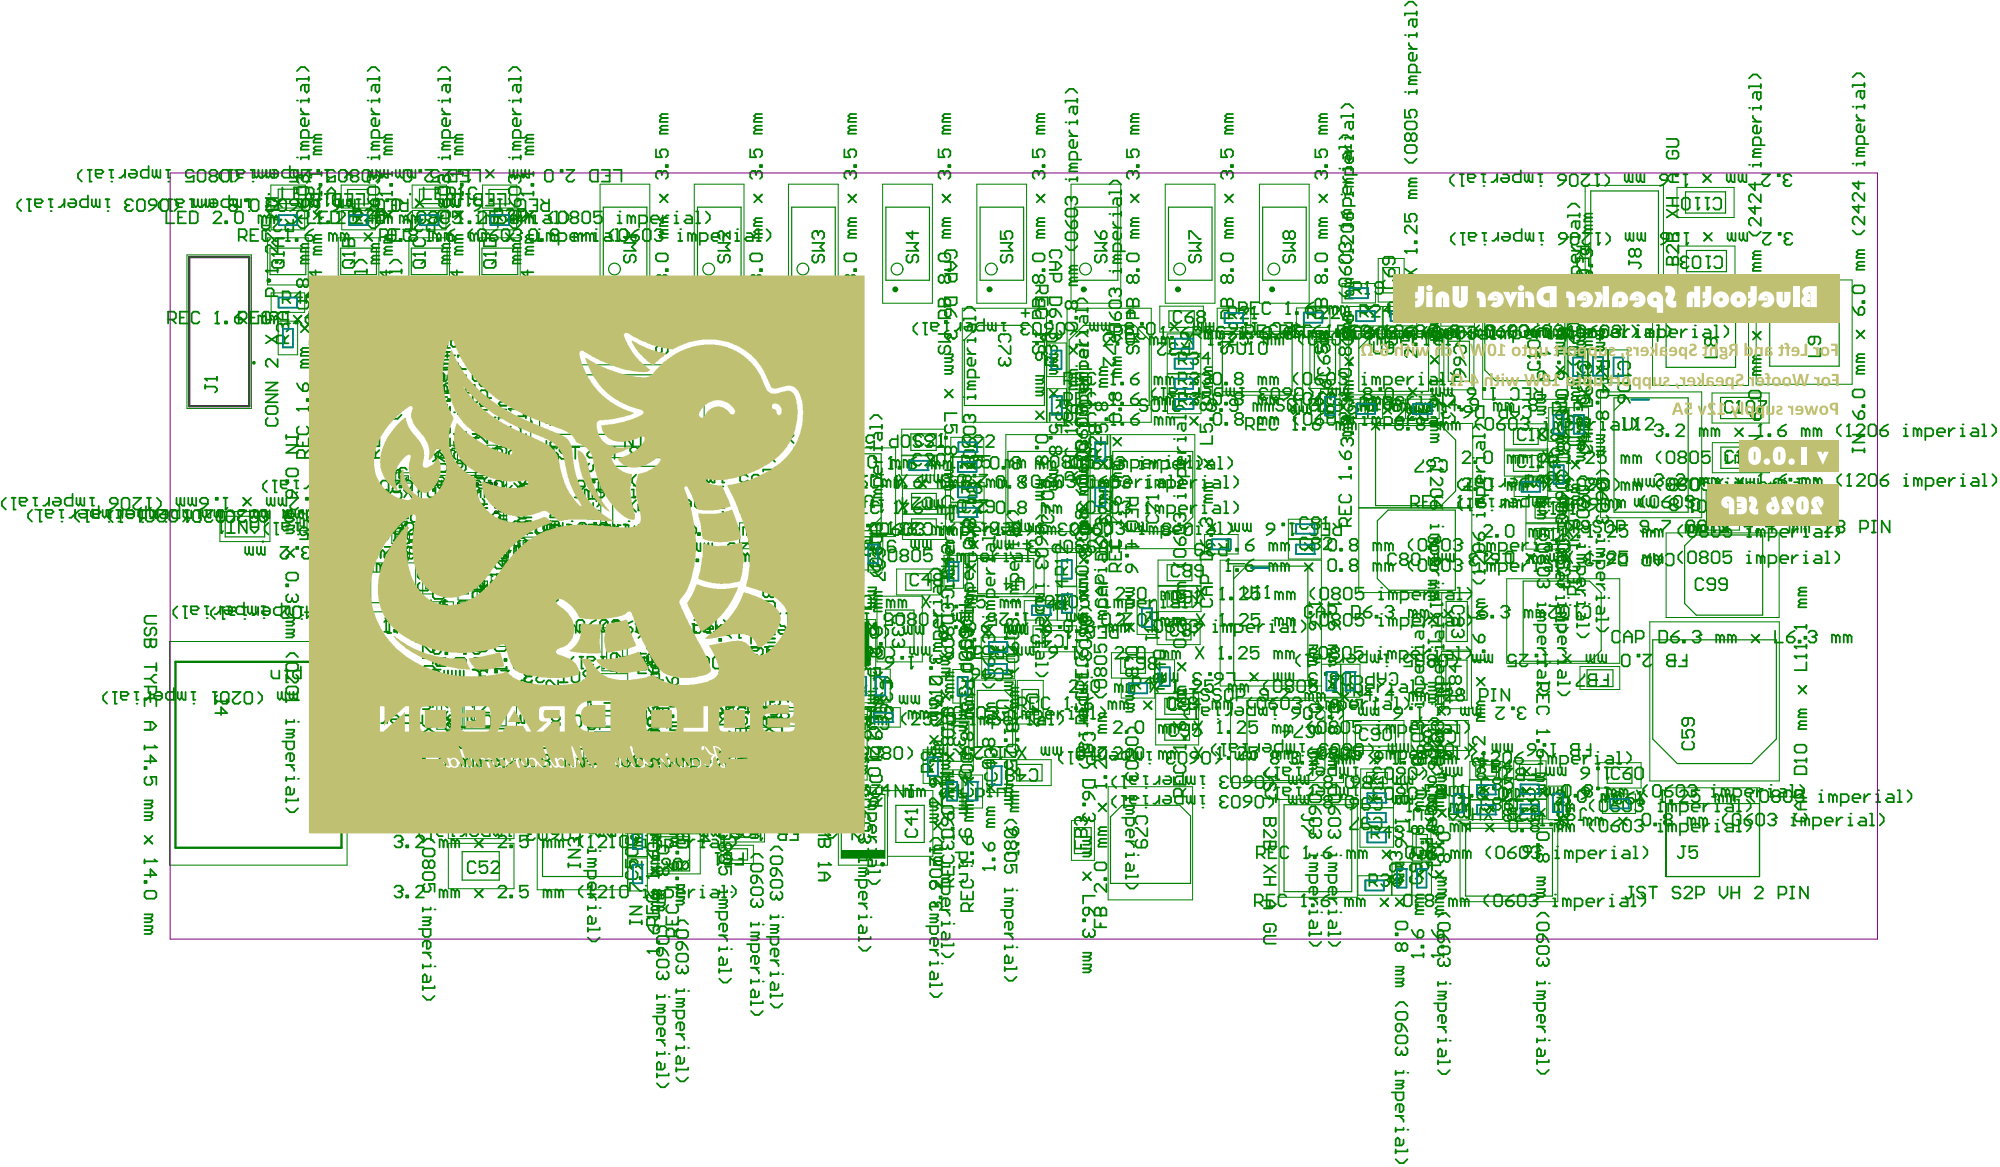
[picture p35: page 6]

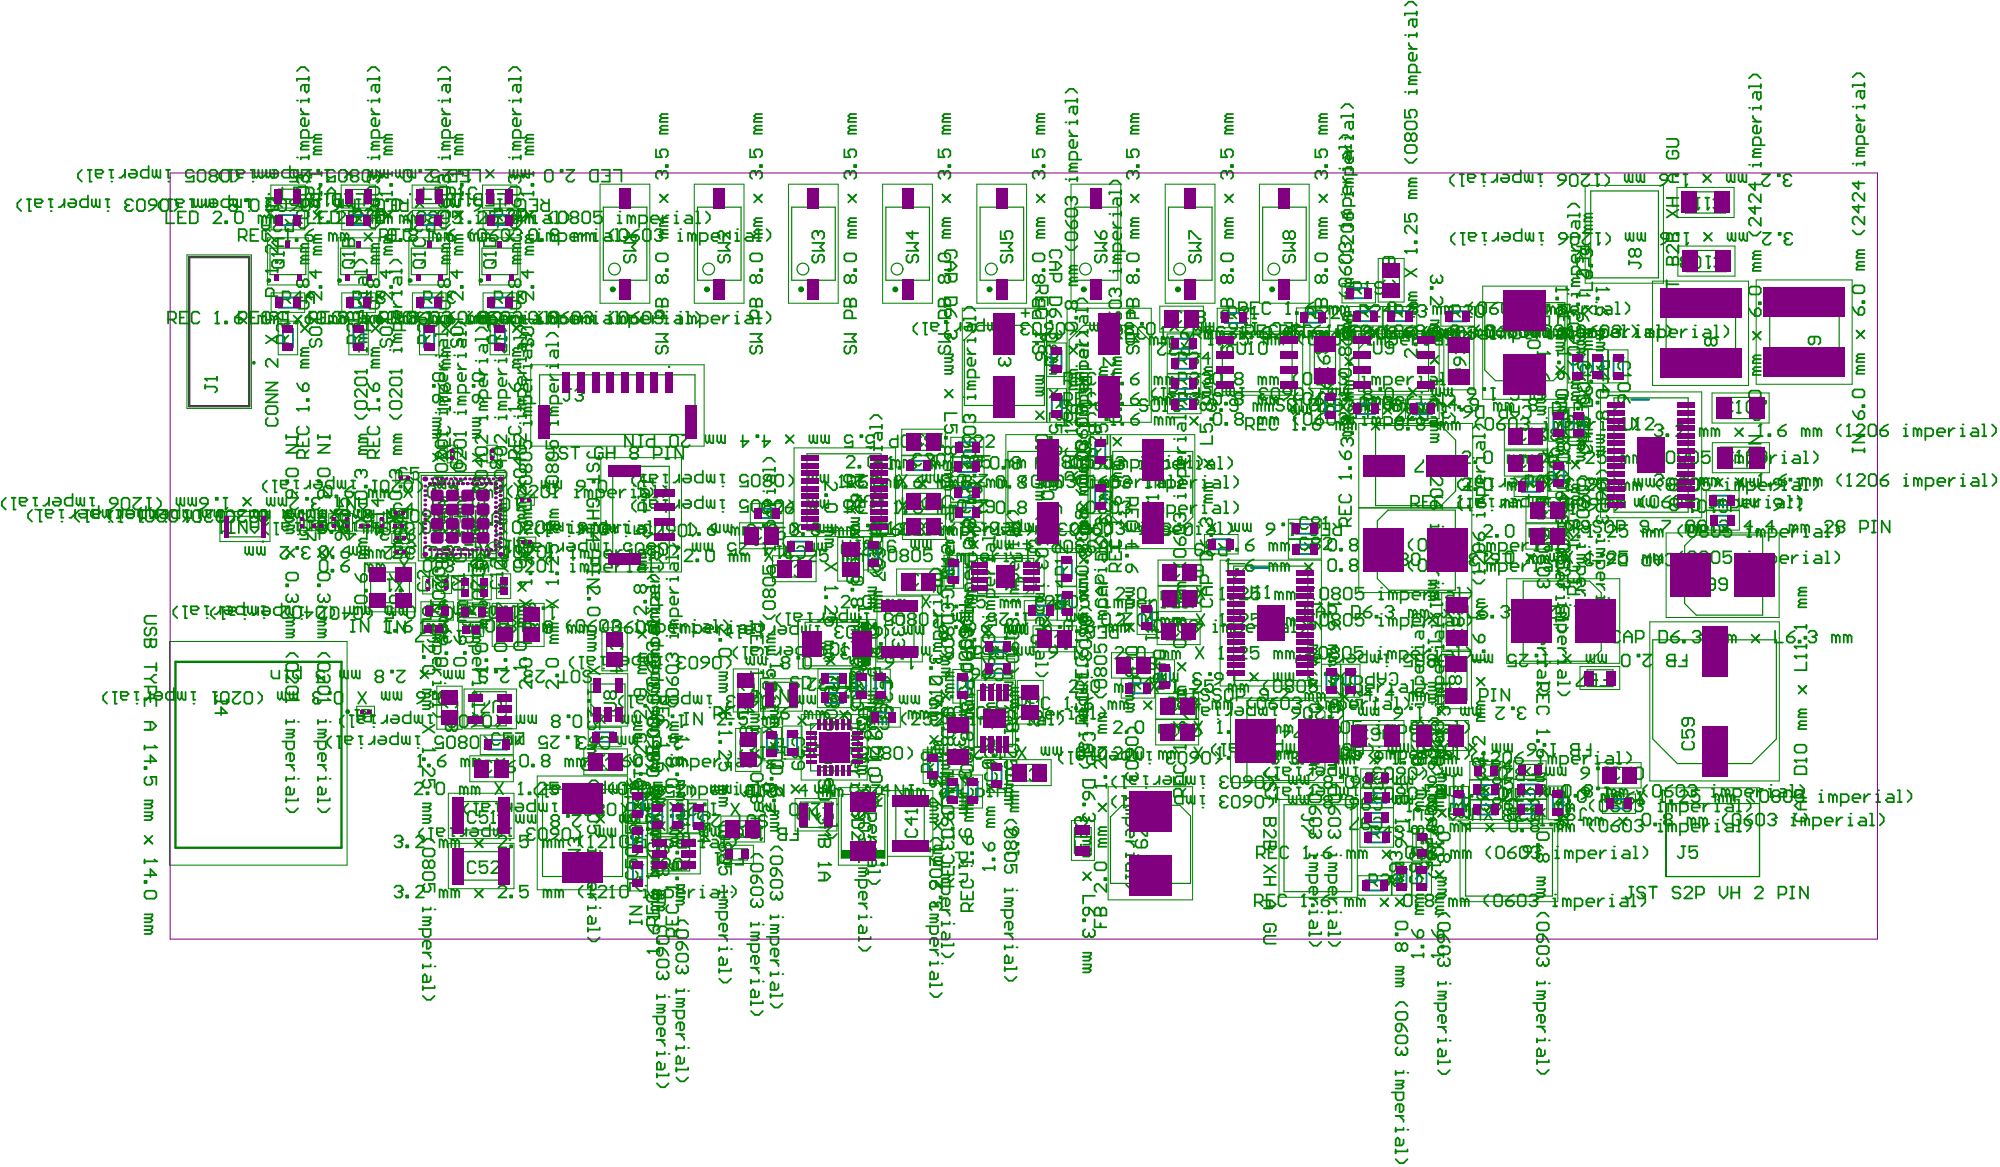
[picture p36: page 7]

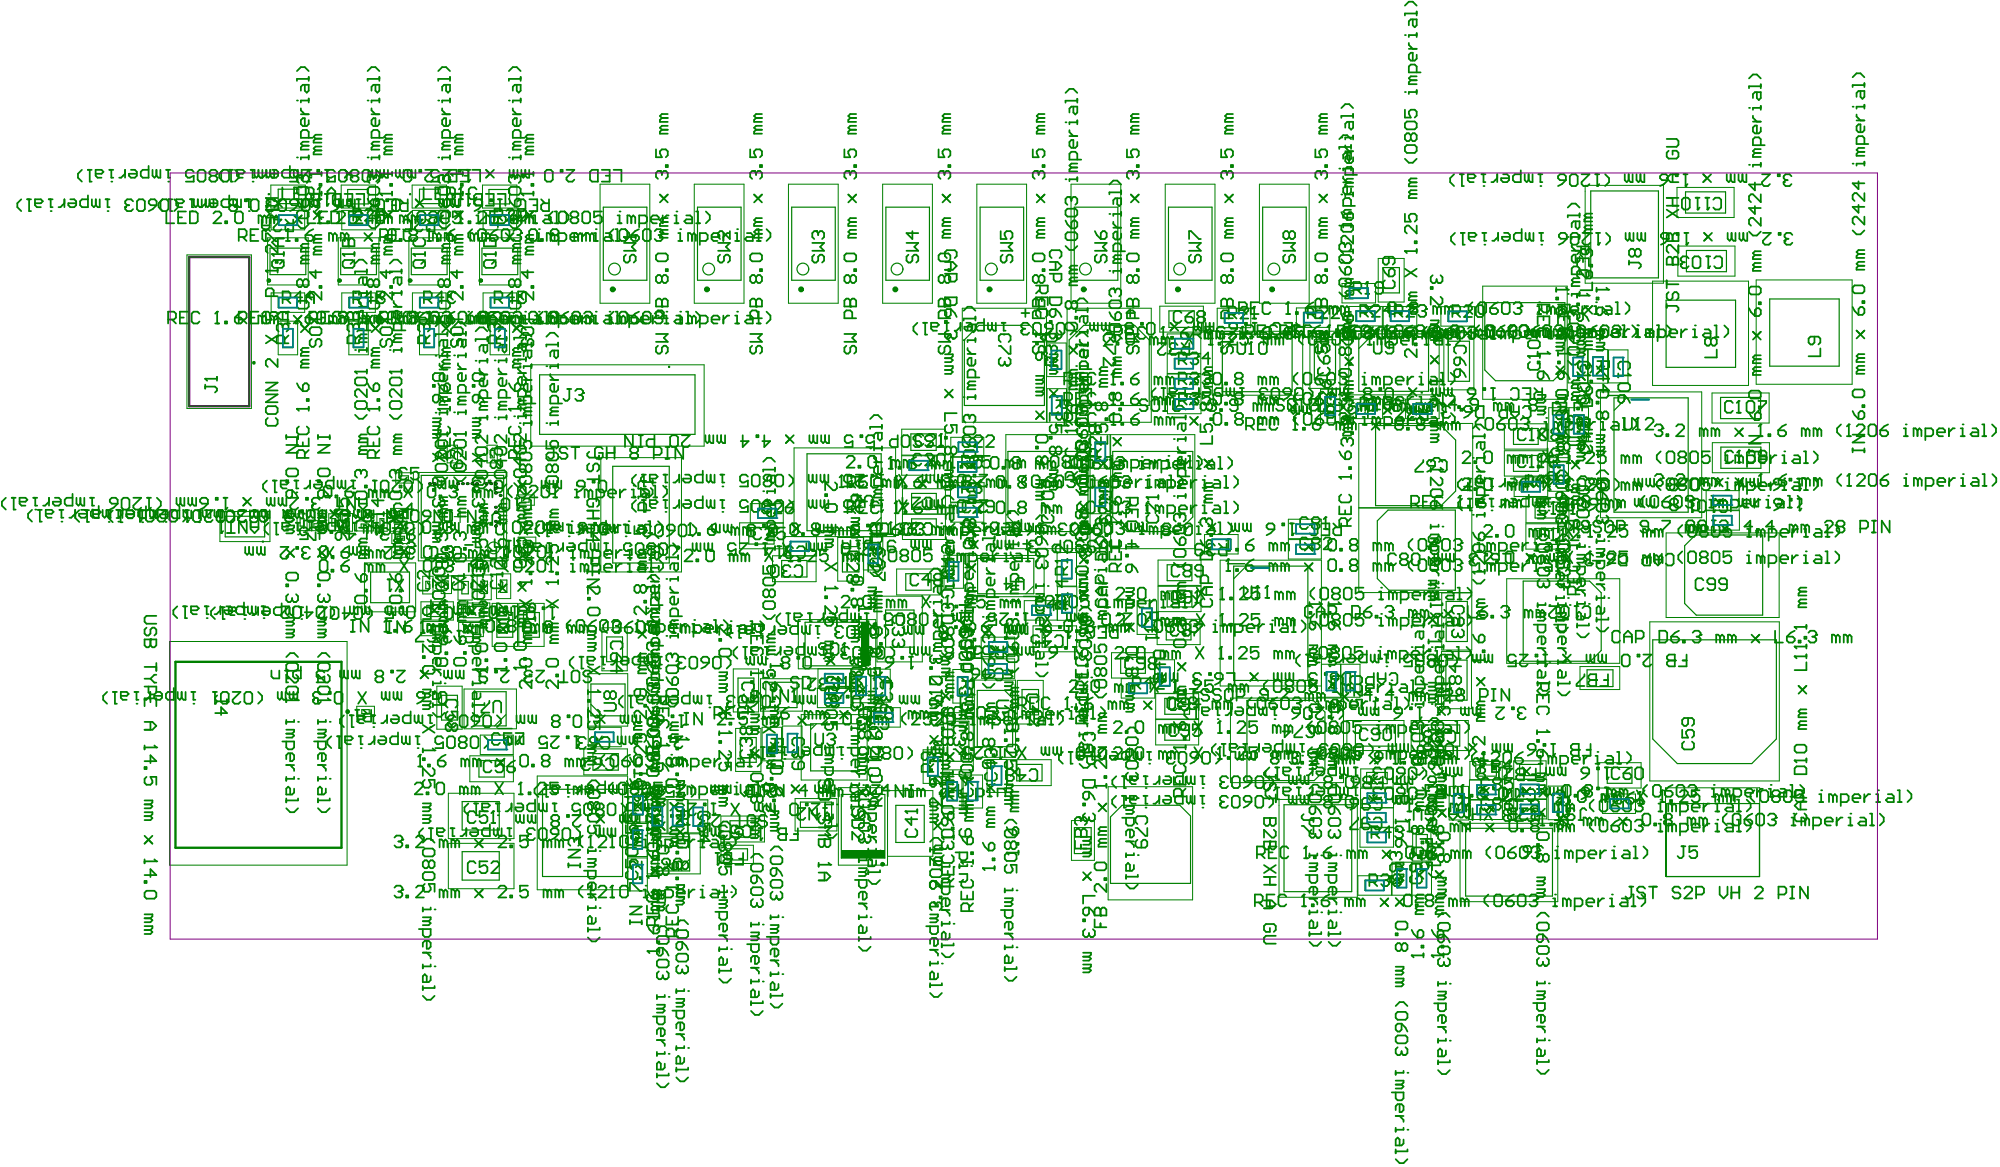
[picture p37: page 8]

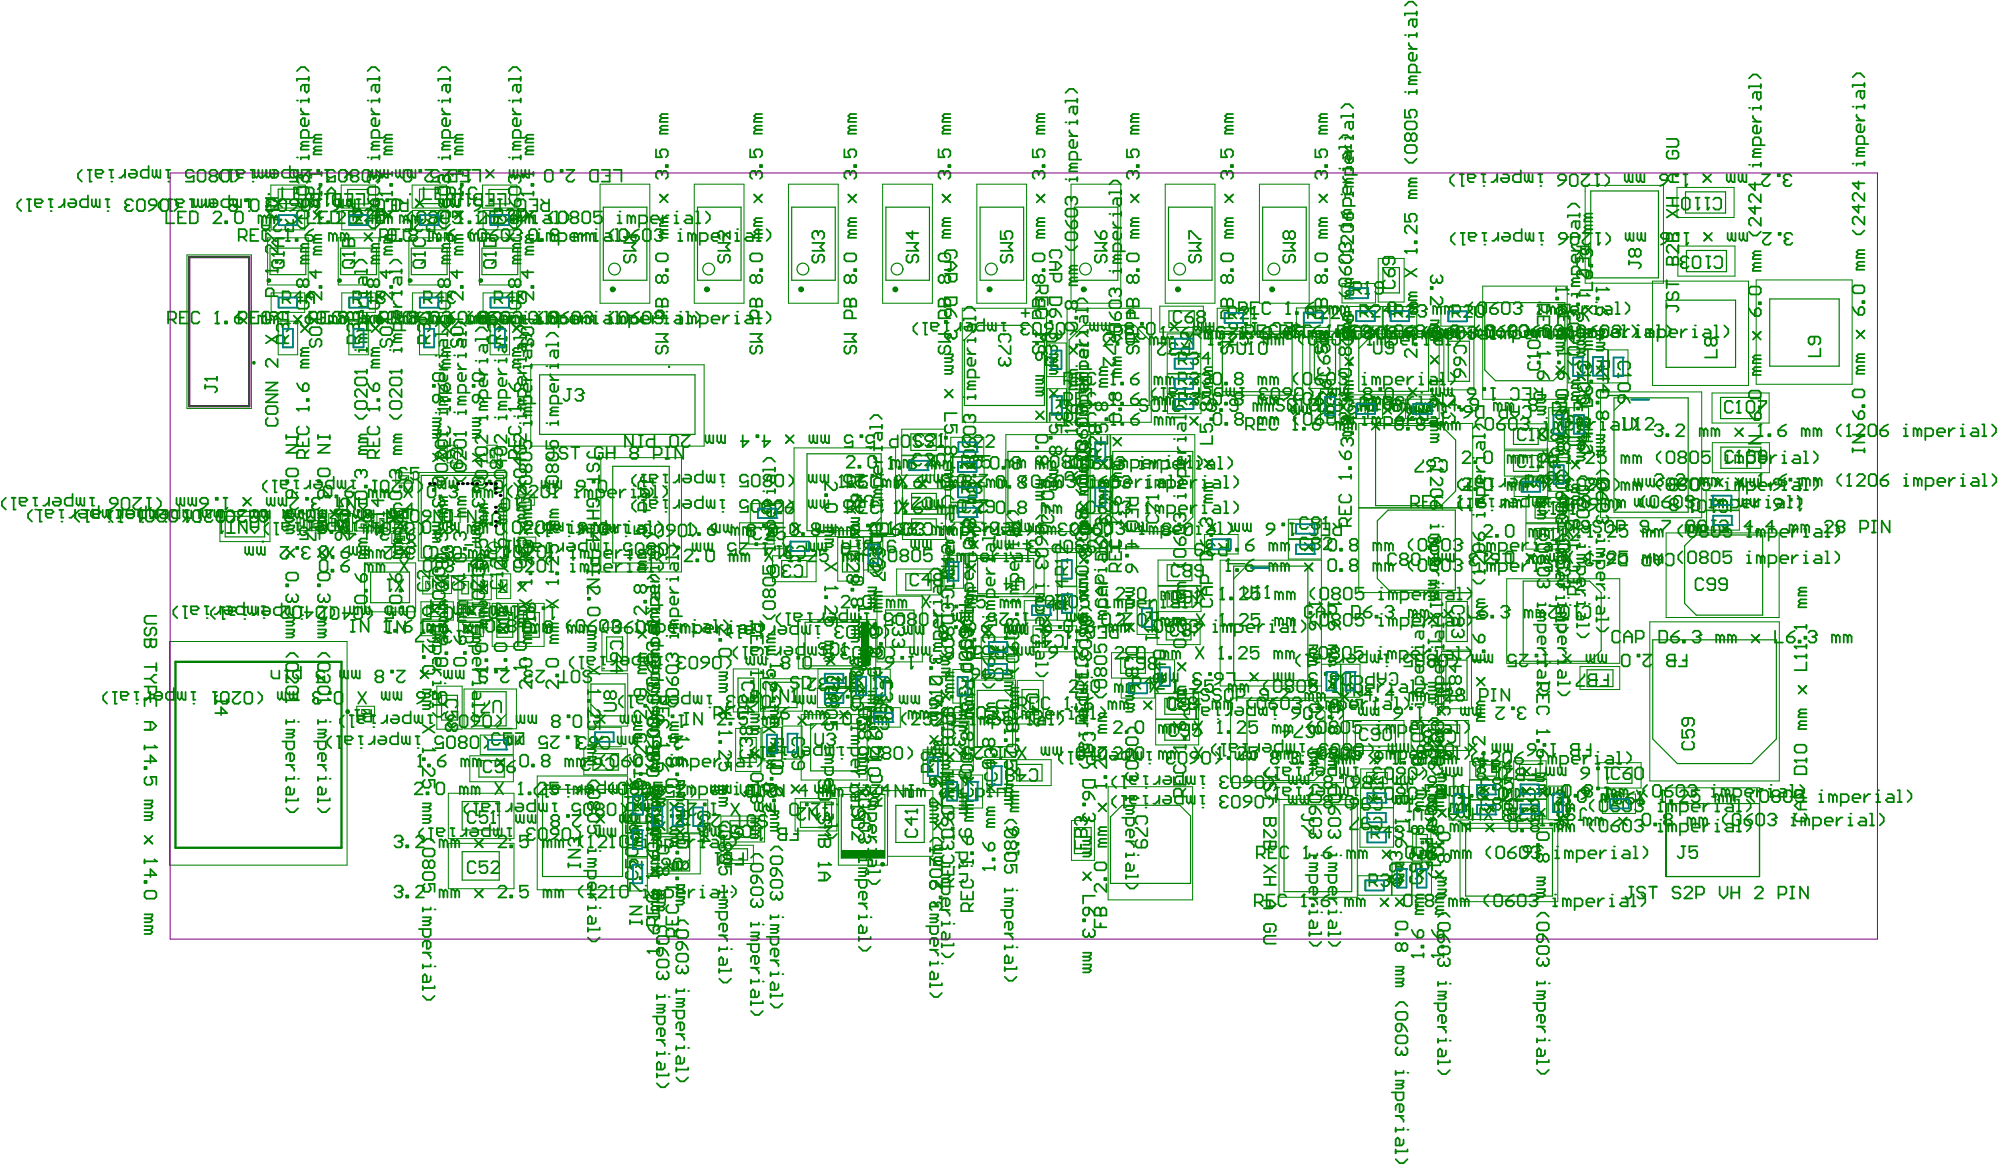
[picture p38: page 11]

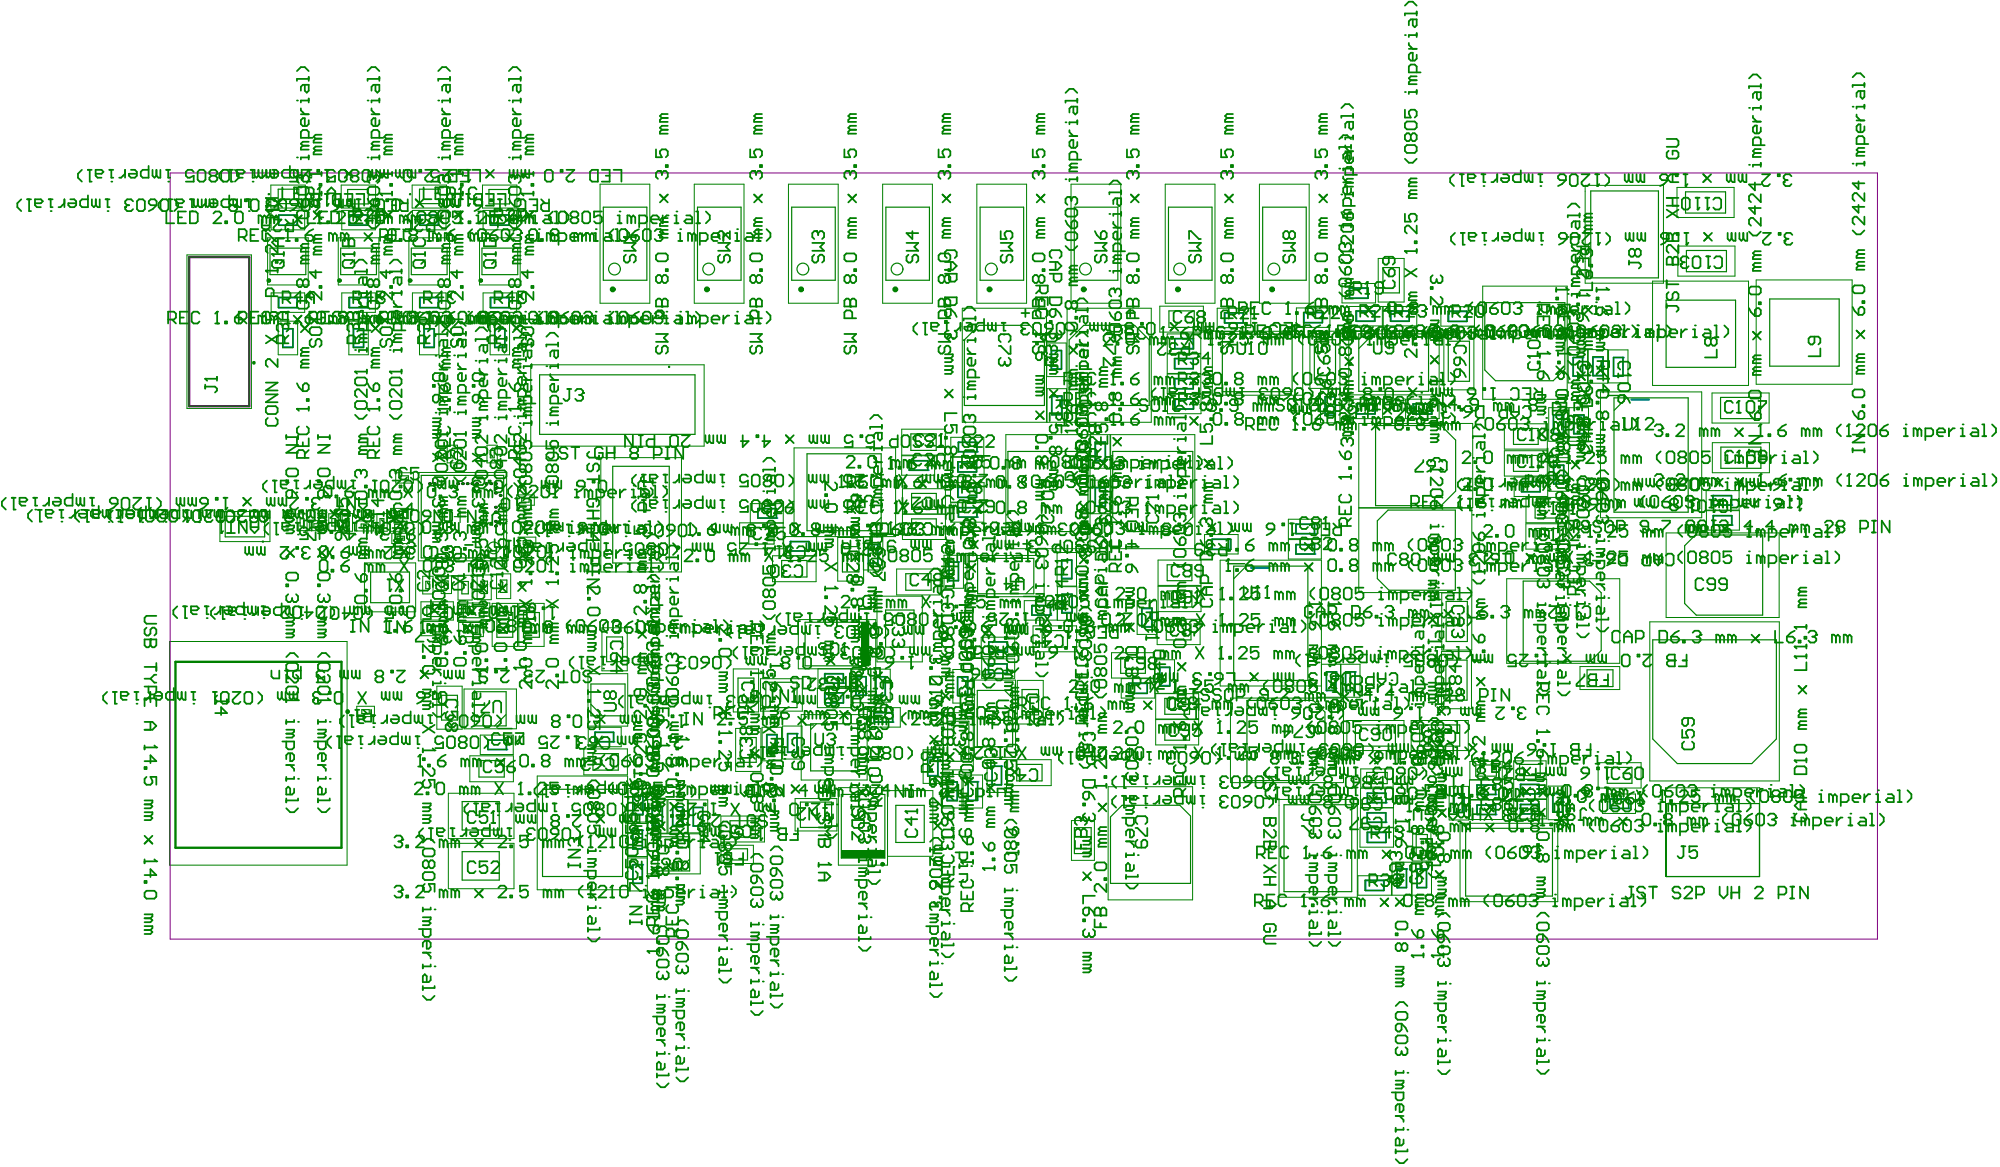
[picture p39: page 12]

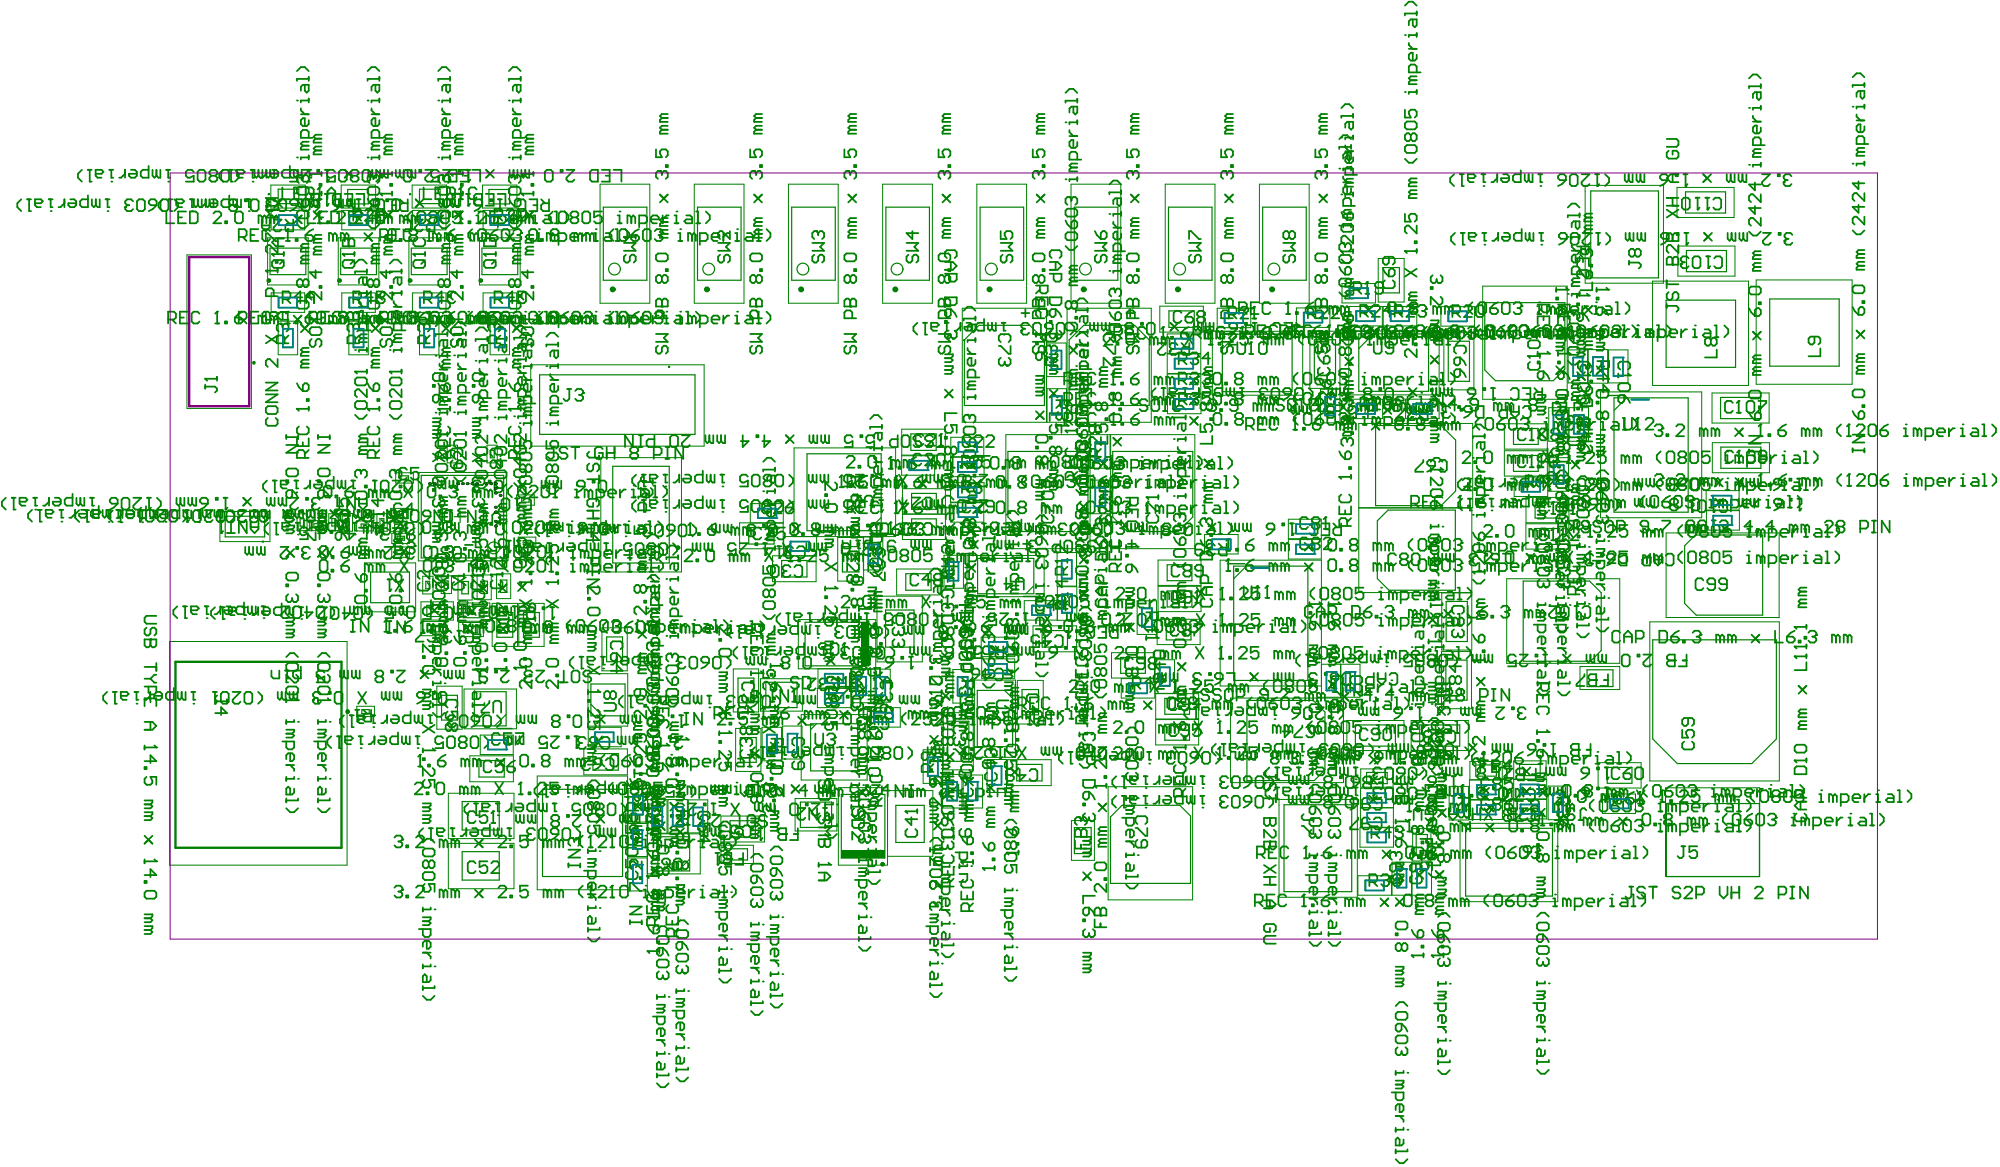
[picture p40: page 13]

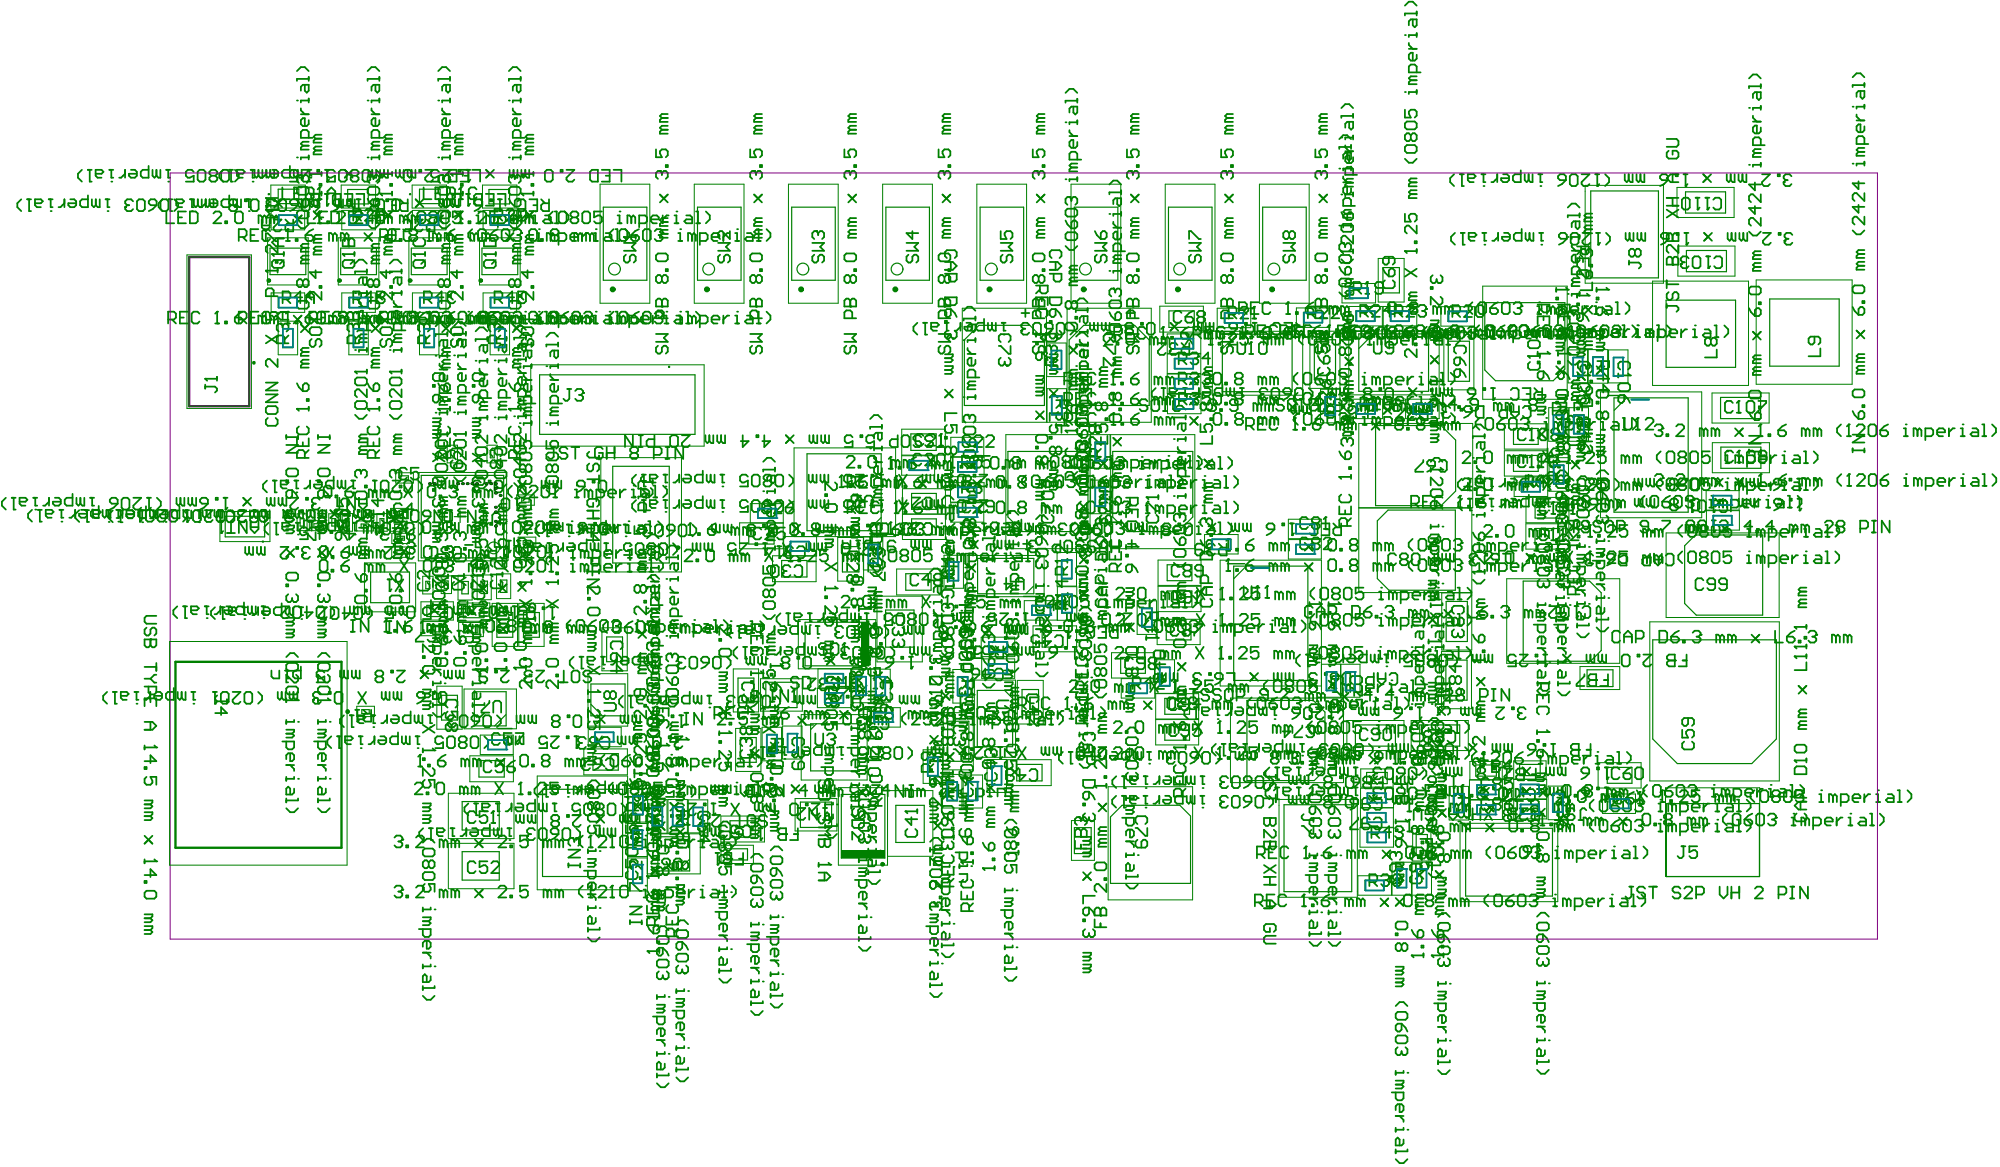
[picture p41: page 14]

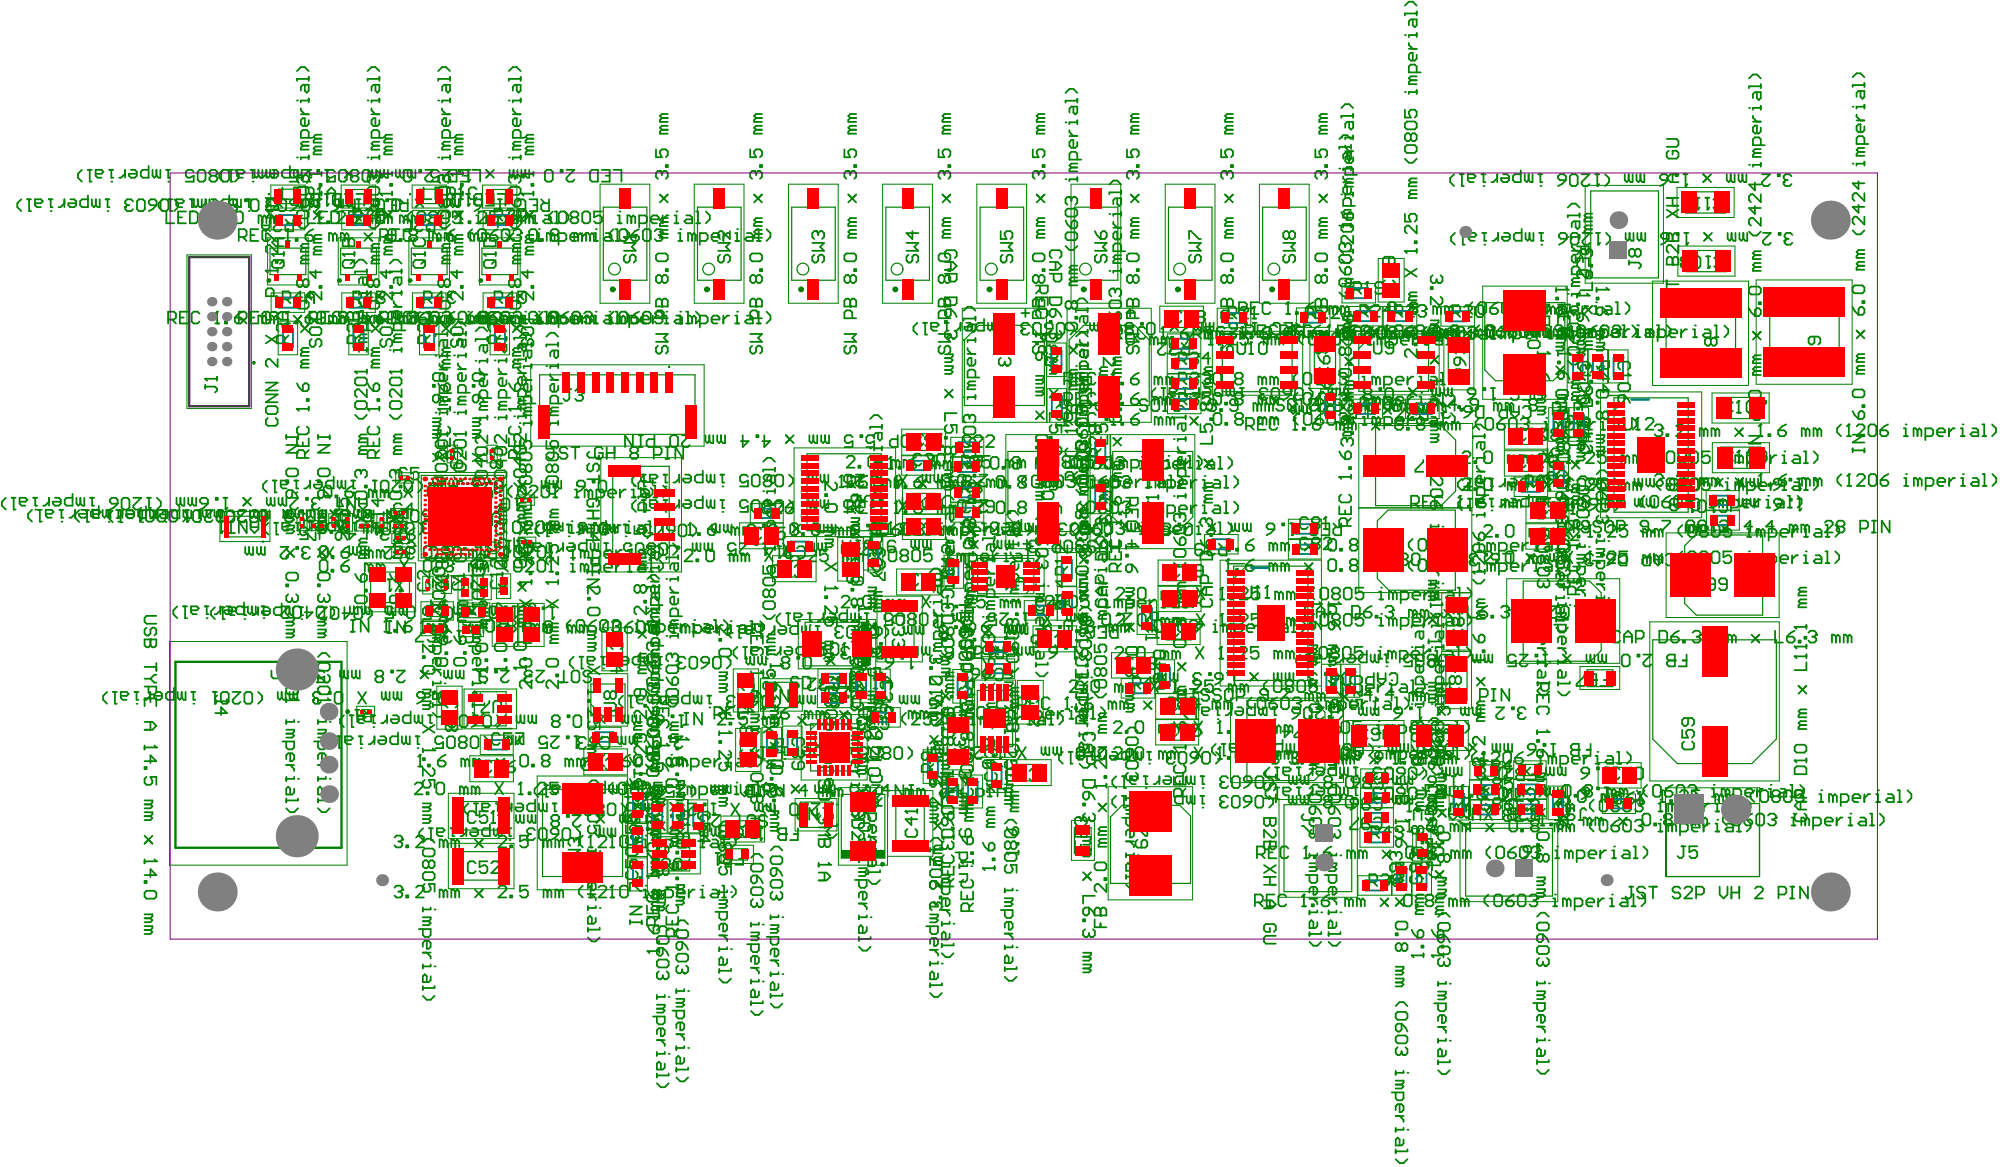
[picture p42: page 15]

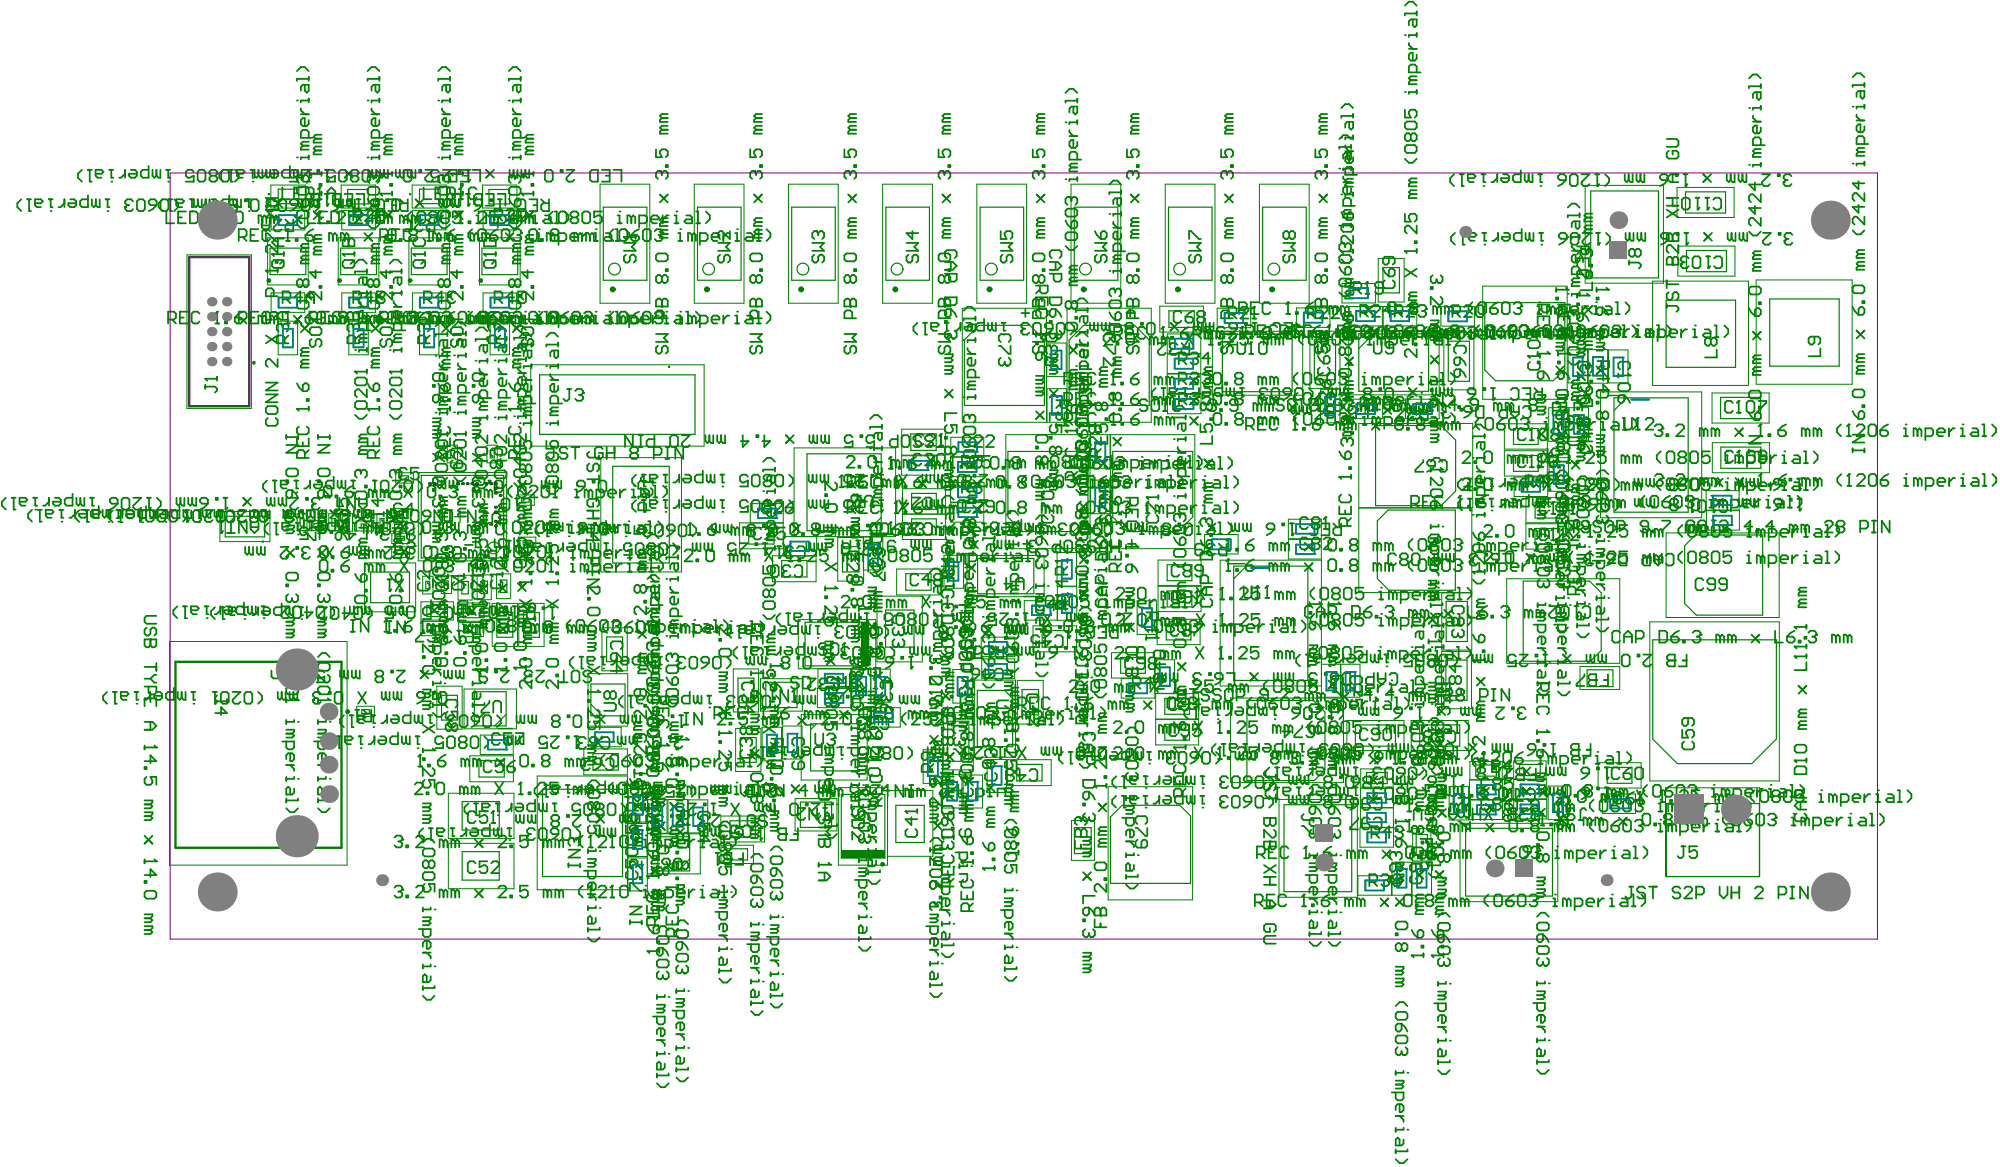
[picture p43: page 16]
