Makara97/Bluetooth_Speaker_Setup/Bluetooth_Speaker_Driver/Project Outputs for Bluetooth_Speaker_Driver/PDF/Composite Drill Drawing/Composite_Drill_Drawing.PDF

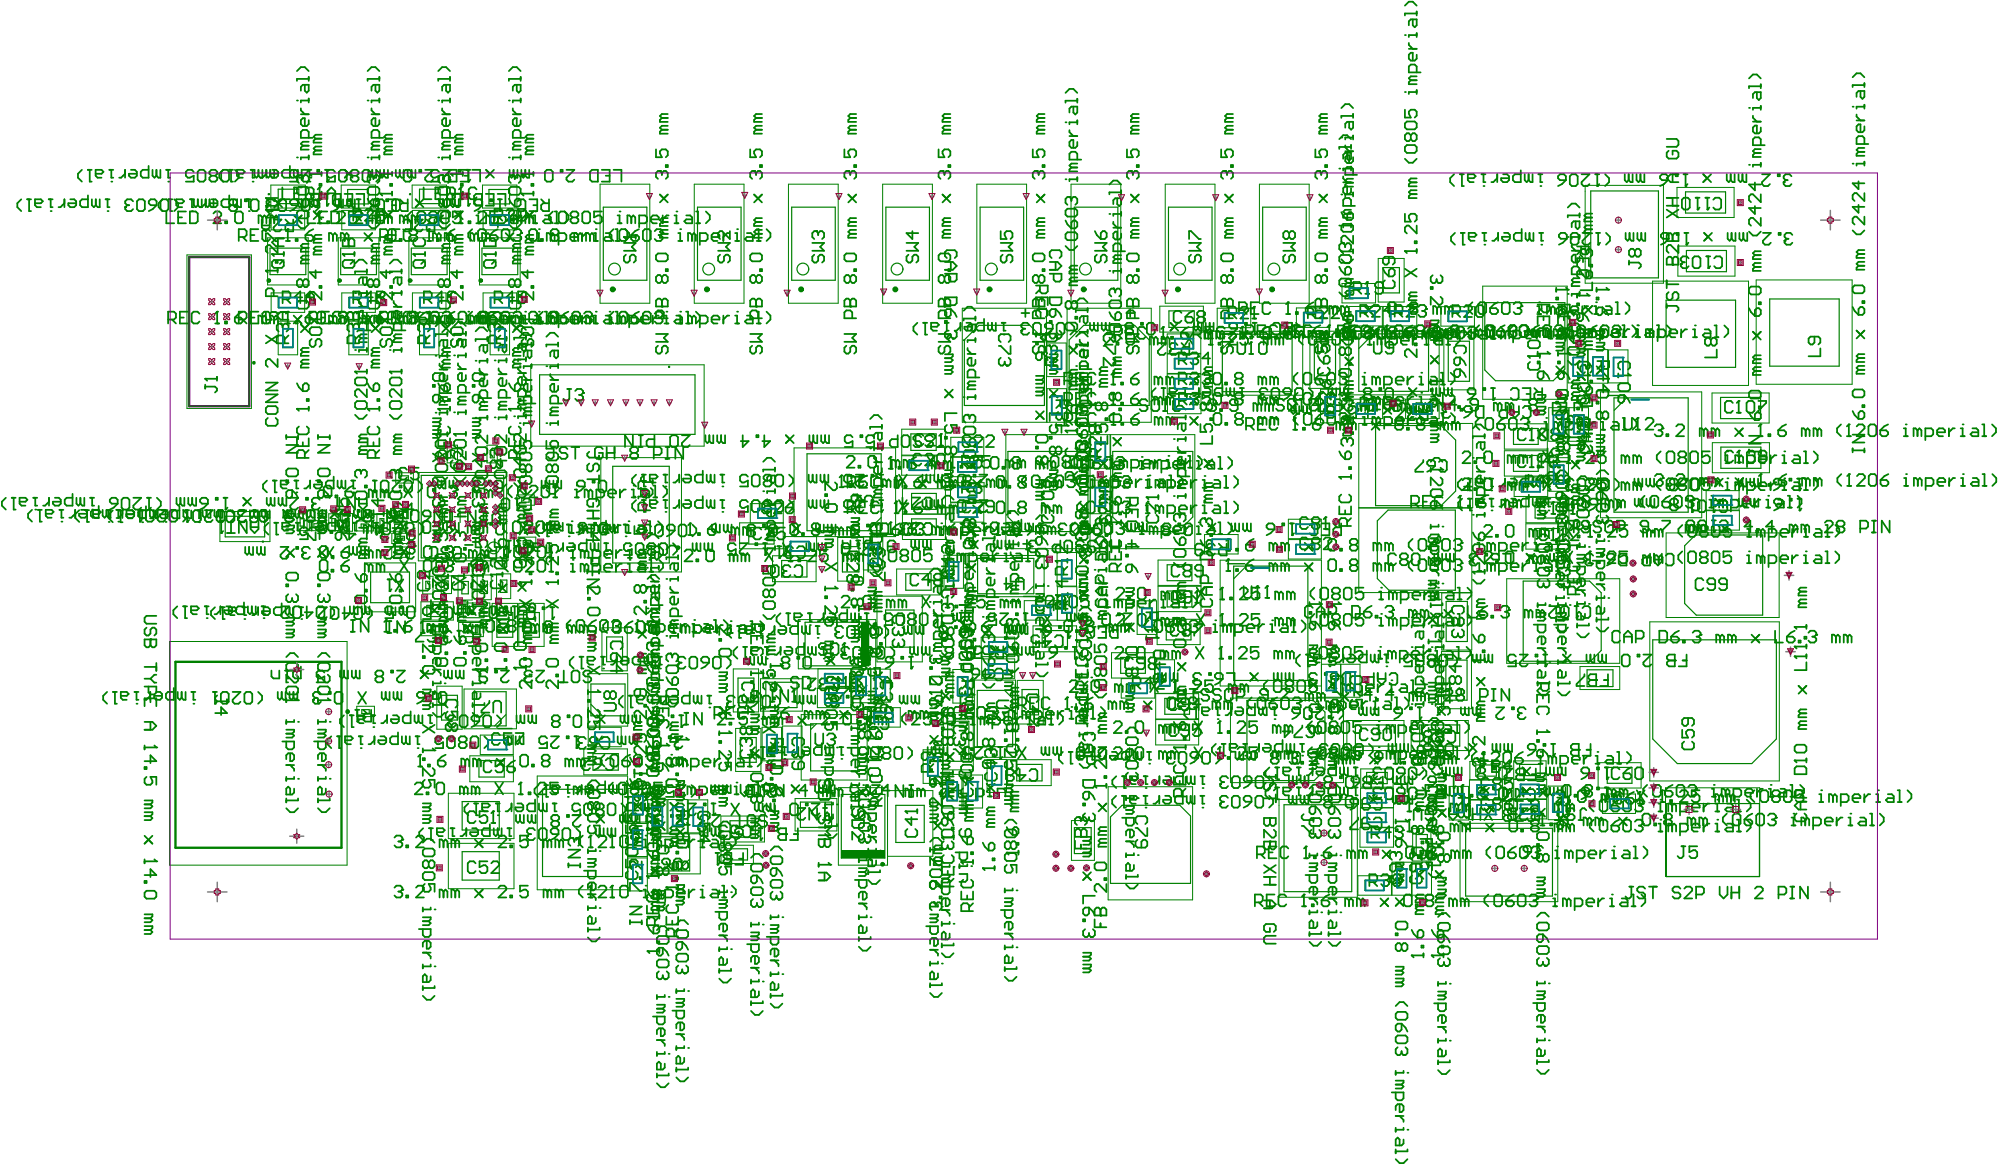
[picture p44: page 1]
