Makara97/Bluetooth_Speaker_Setup/(list of files, drawings)

Other design files:
Bluetooth_Speaker_Driver/4th_Order_Linwitz-Riley_Low_Pass_Filter.SchDoc
Bluetooth_Speaker_Driver/5v negative and positive channels.SchDoc
Bluetooth_Speaker_Driver/AMP.SchDoc
Bluetooth_Speaker_Driver/Bluetooth_Speaker_Driver.PrjPcb
Bluetooth_Speaker_Driver/DAC.SchDoc
Bluetooth_Speaker_Driver/LED_Indicator.SchDoc
Bluetooth_Speaker_Driver/Mono_Bass_TPA3138D2.SchDoc
Bluetooth_Speaker_Driver/nRF5340.SchDoc
Bluetooth_Speaker_Driver/PCB.PcbDoc
Bluetooth_Speaker_Driver/PcbLib1.PcbLib
Bluetooth_Speaker_Driver/Power_Section.SchDoc
Bluetooth_Speaker_Driver/Schlib1.SchLib
Bluetooth_Speaker_Driver/Stereo_L&R_TPA3138D2.SchDoc
Bluetooth_Speaker_Driver/Top_Layer.SchDoc
