Makara97/Bluetooth_Speaker_Setup/(commit log)

2025-11-08 Data sheets and initial files
    [Bluetooth_Speaker_Driver.PrjPcb, Sheet1.SchDoc]
2026-03-04 Update the DB and start schematics
    [AMP.SchDoc, Bluetooth_Speaker_Driver.PrjPcb, DAC.SchDoc, Power_Section.SchDoc, Sheet1.SchDoc, Top_Layer.SchDoc, nRF5340.SchDoc]
2026-03-18 Add Datasheets and Libraries of components
    [AMP.SchDoc, Bluetooth_Speaker_Driver.PrjPcb, DAC.SchDoc, PcbLib1.PcbLib, Schlib1.SchLib, Top_Layer.SchDoc, nRF5340.SchDoc]
2026-03-30 Create Libraries for components
    [DAC.SchDoc, PcbLib1.PcbLib, Schlib1.SchLib, nRF5340.SchDoc]
2026-03-31 Create Component libraries
    [PcbLib1.PcbLib, Schlib1.SchLib]
2026-04-06 Start mapping components
    [AMP.SchDoc, DAC.SchDoc, PcbLib1.PcbLib, Power_Section.SchDoc, Schlib1.SchLib, Top_Layer.SchDoc, nRF5340.SchDoc]
2026-05-18 Update and add new parts
    [5v negative and positive channels.SchDoc, AMP.SchDoc, Bluetooth_Speaker_Driver.PrjPcb, DAC.SchDoc, PcbLib1.PcbLib, Power_Section.SchDoc, Schlib1.SchLib, nRF5340.SchDoc]
2026-08-11 Developing the schematic of the circuit
    [5v negative and positive channels.SchDoc, AMP.SchDoc, DAC.SchDoc, Power_Section.SchDoc, Schlib1.SchLib, nRF5340.SchDoc]
2026-08-11 Developing the schematics of power supplies
    [Power_Section.SchDoc, Schlib1.SchLib]
2026-08-12 Add components to system
    [PcbLib1.PcbLib, Power_Section.SchDoc, Schlib1.SchLib]
2026-08-20 adding components to schematics
    [5v negative and positive channels.SchDoc, AMP.SchDoc, Bluetooth_Speaker_Driver.PrjPcb, DAC.SchDoc, Mono_Bass_TPA3138D2.SchDoc, PcbLib1.PcbLib, Power_Section.SchDoc, Schlib1.SchLib]
2026-08-22 Add more components for the schematics
    [4th_Order_Linwitz-Riley_Low_Pass_Filter.SchDoc, AMP.SchDoc, Bluetooth_Speaker_Driver.PrjPcb, Mono_Bass_TPA3138D2.SchDoc, Schlib1.SchLib, Stereo_L&R_TPA3138D2.SchDoc, Top_Layer.SchDoc, nRF5340.SchDoc]
2026-08-27 Adding new components
    [PcbLib1.PcbLib, Schlib1.SchLib, nRF5340.SchDoc]
2026-09-01 Add new components to schematic
    [Bluetooth_Speaker_Driver.PrjPcb, PcbLib1.PcbLib, Schlib1.SchLib, nRF5340.SchDoc]
2026-09-02 add new components
    [4th_Order_Linwitz-Riley_Low_Pass_Filter.SchDoc, 5v negative and positive channels.SchDoc, AMP.SchDoc, Bluetooth_Speaker_Driver.PrjPcb, LED_Indicator.SchDoc, Mono_Bass_TPA3138D2.SchDoc, PcbLib1.PcbLib, Power_Section.SchDoc]
2026-09-04 Finalizing the schematics
    [PcbLib1.PcbLib, Schlib1.SchLib, nRF5340.SchDoc]
2026-09-05 Correct the footprint libraries according to IPC standards
    The footprints are re-organized according to the IPC standards. The footprints that placed using the Smacsys tool keep footprint missing error. Then all that libraries are replaced into the main project library.
    [4th_Order_Linwitz-Riley_Low_Pass_Filter.SchDoc, 5v negative and positive channels.SchDoc, AMP.SchDoc, DAC.SchDoc, Mono_Bass_TPA3138D2.SchDoc, PcbLib1.PcbLib, Power_Section.SchDoc, Schlib1.SchLib]
2026-09-06 Add test point to relevant nets
    [5v negative and positive channels.SchDoc, DAC.SchDoc, Mono_Bass_TPA3138D2.SchDoc, PcbLib1.PcbLib, Power_Section.SchDoc, Schlib1.SchLib, Stereo_L&R_TPA3138D2.SchDoc, nRF5340.SchDoc]
2026-09-07 finishing stack and start component placement
    [4th_Order_Linwitz-Riley_Low_Pass_Filter.SchDoc, 5v negative and positive channels.SchDoc, AMP.SchDoc, Bluetooth_Speaker_Driver.PrjPcb, DAC.SchDoc, LED_Indicator.SchDoc, Mono_Bass_TPA3138D2.SchDoc, PCB.PcbDoc]
2026-09-08 Component placement started
    [4th_Order_Linwitz-Riley_Low_Pass_Filter.SchDoc, 5v negative and positive channels.SchDoc, AMP.SchDoc, DAC.SchDoc, LED_Indicator.SchDoc, Mono_Bass_TPA3138D2.SchDoc, PCB.PcbDoc, PcbLib1.PcbLib]
2026-09-11 Start the routing
    [4th_Order_Linwitz-Riley_Low_Pass_Filter.SchDoc, Mono_Bass_TPA3138D2.SchDoc, PCB.PcbDoc, Stereo_L&R_TPA3138D2.SchDoc, nRF5340.SchDoc]
2026-09-11 Routing is continuing
    [PCB.PcbDoc]
2026-09-13 Routing is all most over
    [Mono_Bass_TPA3138D2.SchDoc, PCB.PcbDoc]
2026-09-13 completed the basic routing and started the cleaning and pour process
    [PCB.PcbDoc, nRF5340.SchDoc]
2026-09-14 Constructing copper pours
    [PCB.PcbDoc]
2026-09-15 Completed the copper pour at first layer
    [PCB.PcbDoc]
2026-09-15 plane splitting and GND plane done
    [5v negative and positive channels.SchDoc, DAC.SchDoc, Mono_Bass_TPA3138D2.SchDoc, PCB.PcbDoc, Power_Section.SchDoc, Stereo_L&R_TPA3138D2.SchDoc, nRF5340.SchDoc]
2026-09-15 Designator placing stage is started
    [PCB.PcbDoc, Power_Section.SchDoc, nRF5340.SchDoc]
2026-09-16 Designator placement is over
    [Mono_Bass_TPA3138D2.SchDoc, PCB.PcbDoc]
2026-09-16 Finishing the PCB
    [PCB.PcbDoc, nRF5340.SchDoc]
2026-09-16 Finishing the project
    [4th_Order_Linwitz-Riley_Low_Pass_Filter.SchDoc, 5v negative and positive channels.SchDoc, AMP.SchDoc, Assembly Testpoint Report for PCB.csv, Bill of Materials-Bluetooth_Speaker_Driver(Fabrication Variant).xlsx, Bluetooth_Speaker_Driver.PrjPcb, DAC.SchDoc, Fabrication Testpoint Report for PCB.csv]
